TALs-Education/ZumoPi/README.md

# ZumoPi
ZumoPi is a compact robot platform built around the Pololu Zumo chassis and controlled by a Raspberry Pi. This project is used in various educational settings to demonstrate real-world applications of embedded systems, sensor integration, and autonomous control. The slides below cover topics such as configuring embedded hardware, implementing control loops, and developing path-following algorithms. The goal is to give students hands-on experience with building, programming, and testing autonomous robots.

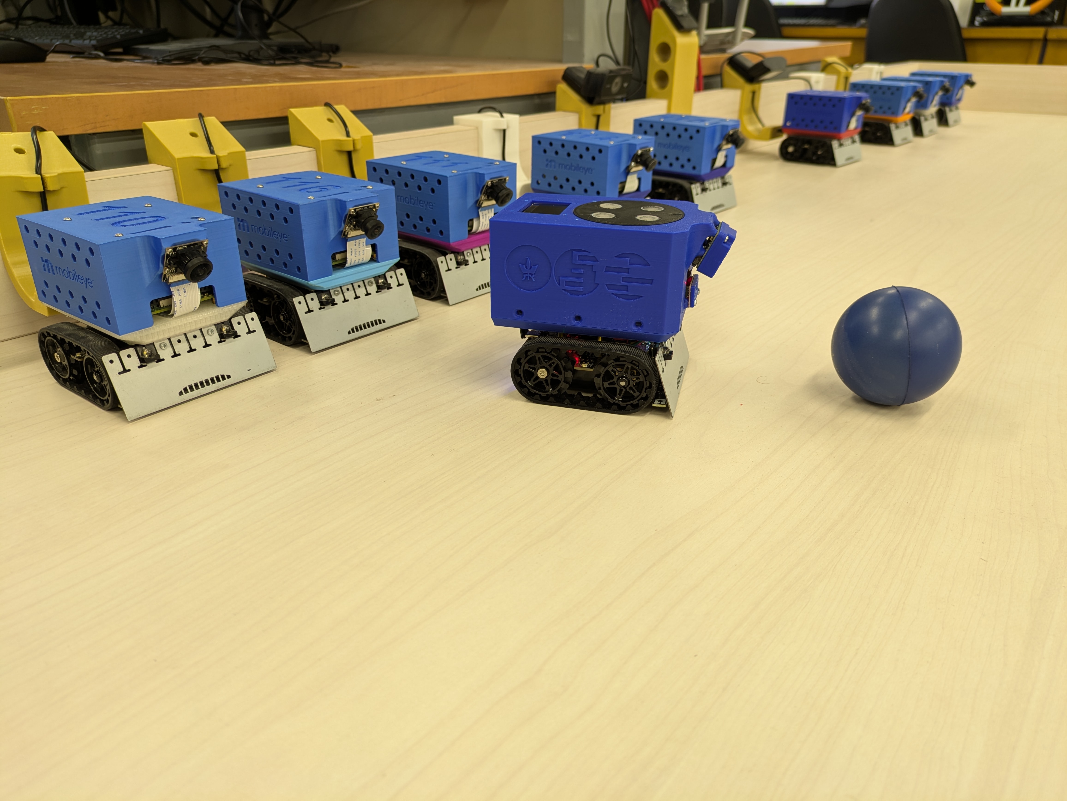
[picture p1: Media/ZumoPi_V02/ZumoV02.jpg]
Platform Image


---

Block Diagram

---

## Bill of Materials (BOM)

[BOM ZumoPi V02](https://docs.google.com/spreadsheets/d/e/2PACX-1vQxc54kx69_jDI3SzTPj1htnaY2AYKc5NwDaSZi82ZxfzQ_idLNpaMOl1VLD6l9M_Mb7hPjLyrn291Y/pubhtml)

---

## Course Slides

- **[Autonomous Systems Lab](https://docs.google.com/presentation/d/e/2PACX-1vRStIoiYa2XbYNI_D9ZccQSjIIEqi7QFh0CPTO20TWpKoEXQ6jn_6Y2cxPnYvpHpmra1TaAvrsPDCbp/pub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)**
  *Introduction to building and controlling autonomous robots, covering fundamental concepts such as sensor fusion, actuator control, and system integration.*

- **[Embedded](https://docs.google.com/presentation/d/e/2PACX-1vTtC3hYFiazQUpXpRI4Cu9u7xv1cP7oLfKXLLpGbvr99-eDz1KW8hfmtAW4wn4Qjw7GQxjzbYANB0p1/pub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)**  
  *Focus on embedded systems programming, including microcontroller or single-board computer setups, interfacing with hardware, and real-time control considerations.*

- **[PathControl](https://docs.google.com/document/d/e/2PACX-1vTpQWTco3Bi_aDHO9klbxftK4g1yNk0Z4INCxaVdjpg8Rd_K-o5vXg43kFpY49FMV86XIksFvMH8WC9/pub)**  
  *Detailed instructions and theory on path planning and control algorithms, demonstrating how to implement robust path-following routines on the ZumoPi robot.*

- **[PathControl - Python Simulation (PDF)](ZumoPi_V02/EducationalMaterials/ZumoPiV02%20-%20Autonomous%20Systems%20Lab%20-%20Path%20Control%20%28Python%29.pdf)**  
  *Python edition of the Path Control lab: the pre-lab runs in the [Python path control simulator](ZumoPi_V02/Python_Simulation) (GUI with live gain tuning, 2D path and block diagram view) instead of MATLAB/Simulink. Setup instructions are in its [README](ZumoPi_V02/Python_Simulation/README.md).*

- **[ImageProcessing](https://docs.google.com/document/d/e/2PACX-1vQhq_S6ipLvnca8L5krcB6jEdvge32izgGZujL72_1fmICjwPvxk8P4Rqf4jPIfgcK0uPkOjYD1Od2g/pub)**  
  *The Image Processing Lab provides comprehensive guidance and theoretical foundations for practical image processing techniques, demonstrating how to implement vision-based applications on the ZumoPi robot.*

- **[HomeExperiments](https://github.com/TALs-Education/HomeExperiments)**  
  *The HomeExperiments repository offers students home experiment kits focusing on motor control, Arduino integration, and sensor applications, facilitating hands-on learning of embedded systems concepts.*

---

## Demonstrations

- **[LineFollower 2024](https://youtu.be/RPoe6qCaDEk)**
- **[PathControl 2024](https://youtu.be/oDfgZZBIBZM)**
- **[SumoCompetition 2023](https://youtu.be/UK6Vnh2M9fI)**
- **[Video Teleoperation](https://youtu.be/0YhwoFXWOhQ)**
