TALs-Education/ZumoPi/ZumoPi_V02/SettingUp.txt

UPS - Geekworm X1200 - https://geekworm.com/products/x1200
https://suptronics.com/Raspberrypi/Power_mgmt/x120x-v1.0_software.html

arduino ide ARM 64 version 1.89
https://www.arduino.cc/en/software

Zumo-arduino Arduino Mbed OS RP2040 Boards 
https://github.com/adamgreen/pololu-3pi-plus-2040-arduino-library

Arduino library - Pololu3piPlus2040 compatible with Zumo2040
https://github.com/adamgreen/pololu-3pi-plus-2040-arduino-library

MicroPython Zumo2040 - https://github.com/pololu/zumo-2040-robot

install arduino-cli  	https://siytek.com/arduino-cli-raspberry-pi/

Install picamera2 https://forums.raspberrypi.com/viewtopic.php?t=361758 usually not needed installed by default
https://datasheets.raspberrypi.com/camera/picamera2-manual.pdf
$sudo apt install python3-picamera2

Install openCV
sudo apt install -y python3-opencv
sudo apt install -y opencv-data

work with virtualenv: https://learn.adafruit.com/python-virtual-environment-usage-on-raspberry-pi/overview
$sudo apt install python3-venv

create a virtual environment which uses the system python packages for picamera2
$python3 -m venv --system-site-packages zumoPy

activate enviroment
$source zumoPy/bin/activate

deactivate enviroment:
$deactivate

Backup enviroment:
$pip freeze > requirements.txt

Update enviroment:
$pip install -r requirements.txt

upgrade python-pip
$python3 -m pip install --upgrade pip

cancel auto shutdown:
$sudo shutdown -c

python packages:
$pip install dash
$pip install evdev
$pip install pyserial
$pip install dash-daq
$pip install matplotlib

Optional packages:
pip3 install tflite-runtime

Testcamera:
libcamera-hello
