TALs-Education/ZumoPi/ZumoPi_V02/Development/BallDetection/BallDetection(Sphere).pdf

## Detecting a Ball (Sphere) Using Camera Geometry

Using Known Camera Height, Tilt, FOV, and Ball Diameter

## Introduction

This document outlines a method for detecting a spherical ball in an image captured by a tilted camera at a known height. We assume:

- The ball has a known real-world diameter Dball (e.g., 70 mm).
- The camera is at height H above the ground (e.g., 85 mm), tilted downward by an angle θ.
- The camera has a horizontal and vertical field of view (FOV) of ϕh and ϕv, respectively (in degrees).
- The image resolution is W ×Himg, and the camera is modeled as a pinhole with effective focal lengths fx, fy.

Below, we derive the approximate distance from the camera to the ball using circle detection (cv2.HoughCircles) and account for partial ground occlusion where the ball contacts the floor. The associated Python code demonstrates how these formulas are implemented in real time.

## 1. Circle Detection

We first detect the ball’s 2D projection in the image using methods such as:

cv2.HoughCircles(...) | → | ( uball, vball, rpix),

where (uball, vball) is the circle’s center in pixel coordinates, and rpix is the detected circle’s pixel radius.

## 2. Initial Distance Estimate

Under a simpler pinhole model (no occlusion correction), if an object of physical diameter Dobj appears with diameter dpix in pixels, we can approximate the distance:

Dest =

favg × Dobj

dpix

,

where

- dpix = 2 rpix,
- favg is an average focal length in pixels, often computed as

fx =

W/2
tan

ϕh
2

, fy =

Himg/2
tan

ϕv
2

, favg =

fx + fy
2

For a sphere of diameter Dball, dpix is the measured diameter in the image.

## 3. Ground Occlusion Correction

If the ball rests on the ground, part of it is hidden by the contact point with the floor, making the measured circle smaller than the true circle. The Python code uses a function

project y(Yworld, Zworld, fy, cy)

to compute the vertical image coordinate of a 3D point (0, Yworld, Zworld) in a camera coordinate system tilted by θ.

### 3.1 Spherical Radius vs. Contact Point

Let Rball =

Dball
2

be the ball’s real radius.

- The center of the ball is at Yworld = Rball above the ground.
- The contact with the ground occurs at Yworld = 0.

We initially estimate Zworld = Dest and compute where the camera sees Yworld = Rball and Yworld = 0 in the image:

vcenter est = project y

Rball, Dest, fy, cy
,

vcontact est = project y

0, Dest, fy, cy

The difference

∆ = vcontact est − vcenter est

represents the vertical offset (in pixels) between the ball’s center and the ground contact point.

### 3.2 Corrected Apparent Diameter

In a perfect side view, if no occlusion occurred, the ball’s full radius in the image could be approximated by

rfull =

rdpix

2

2
+ ∆².

Thus, the full (unoccluded) diameter is dfull = 2 rfull. The code then refines the distance:

Dcorr = 2 ×

favg × Dball

dfull

,

introducing a factor of 2 to compensate for the partial occlusion. This new Dcorr is used for a more accurate distance estimate.

## 4. Final 3D Position

Once Dcorr is computed, we treat the ball’s center as lying at

Zworld = Dcorr cos(αeff), Xworld = Dcorr sin(αeff),

where

- α = arctan

uball−cx
fx
is the horizontal angle,

- β = arctan vcenter corr−cy
fy
is the additional pitch from the camera center to the ball center,
- αeff = θ + β is the total pitch angle from the horizontal reference.

Hence, in a 2D plane where the camera is the origin, Xworld is the lateral offset and Zworld is the forward distance (in mm). The ball’s vertical position relative to the ground can also be approximated by
VerticalEst = Dcorr × sin(αeff).

## 5. Summary of Key Steps in the Code

1. Capture frame, detect circle (uball, vball, rpix) via cv2.HoughCircles.
2. Initial distance:

Dest =

favg × Dball

(2 rpix)

3. Project ball center and contact to the image using project y.
4. Compute occlusion offset ∆ and refine diameter dfull.
5. Refine distance Dcorr and re-evaluate the ball center’s pitch angle β.
6. Compute 2D ground coordinates (Xworld, Zworld) and optional vertical position.

## 6. Caveats and Practical Considerations

- Lens Distortion: Wide-angle lenses may cause significant distortion that requires calibration for more accurate geometry.
- Noise and Circle Detection: cv2.HoughCircles parameters (dp, param1, param2, minRadius, etc.) must be tuned for the environment.
- Partial Occlusion Approximations: The approach here models the ball-floor contact as
a simple 2D projection. Very large tilt angles or non-flat surfaces can introduce errors.
- Real-Time Constraints: Computing these corrections each frame is still efficient enough for many robotics tasks, but frame rates vary based on resolution and Pi performance.

## Conclusion

By treating a detected circle in the image as part of a sphere resting on a flat plane, we can achieve more accurate distance estimates than naive pinhole formulas would give. The core ideas:

1. Use the known ball diameter and measured circle size to estimate distance.
2. Account for camera tilt and partial occlusion with a simple trigonometric correction.

3. Derive final (X, Z) coordinates in millimeters from the camera origin.

This pipeline can guide a mobile robot to locate, track, or interact with spherical objects using only a single downward-tilted camera.
