TALs-Education/ZumoPi/ZumoPi_V02/old_Designs/Research/Power_Management/bq24075/Links.txt

SparkFun Battery Babysitter - LiPo Battery Manager
https://www.sparkfun.com/products/13777
