TALs-Education/ZumoPi/ZumoPi_V02/old_Designs/Components/LTC4040/Links.txt

https://www.beyondlogic.org/ltc4040-5v-2-5a-uninterruptible-power-supply-ups-with-usb-c/
https://circuitmaker.com/Projects/Details/Craig-Peacock-4/5V-Uninterruptable-Power-Supply-USB

https://hackaday.io/project/162653-u1liupsrpi
