TALs-Education/ZumoPi/ZumoPi_V02/old_Designs/MCU/Pinout.xlsx

Sheet: Sheet1
 | My Functionality | AUDIO | UART | GPIO/BUS | I2C | SDIO | SPI | Dedicated |  | Header | My Functionality |  |  | AUDIO | UART | GPIO/BUS | I2C | SDIO | SPI | Dedicated |  | AUDIO | UART | GPIO/BUS | I2C | SDIO | SPI | Dedicated |  |  | AUDIO | UART | GPIO/BUS | I2C | SDIO | SPI0 | Dedicated |  |  |  | AUDIO | UART | GPIO/BUS | I2C | SDIO | SPI | Dedicated | AUDIO | UART | GPIO/BUS | I2C | SDIO | SPI0 | Dedicated
 |  | Function |  |  |  | Bottom | Top | Function |  |  |  |  |  | SAMD51 | Alternate | Primary | Bottom | Top | Primary | Alternate | SAMD51 | Alternate |  | Primary | RP2040 GPIO Pin | Bottom | Top | RP2040 GPIO Pin | Primary | Alternate | ESP32 Pin | Alternate Function |  | Primary Function | Bottom Pin | Top Pin | Primary Function | Alternate Function |  | ESP32 Pin | Function STM32 | Bottom | Top | Function |  |  |  | Function nRF52840 |  |  | Bottom | Top | Function nRF52840
 |  |  |  |  |  | Pin | Pin |  |  |  |  |  |  | Pin | Function | Function | Pin | Pin | Function | Function | Pin | Function |  | Function |  | Pin | Pin |  | Function | Function |  |  |  |  |  |  |  |  |  |  |  | Pin | Pin |  |  |  |  |  |  |  | Pin | Pin
 |  |  |  |  | (Not Connected) |  | 75 | GND |  |  |  |  |  |  |  | (Not Connected) |  | 75 | GND |  |  |  |  | (Not Connected)* |  |  | 75 |  | GND |  |  |  |  |  |  | 75 |  |  |  |  | (Not Connected) |  | 75 | GND |  |  |  |  |  |  | (Not Connected) | 75 | GND
 | 3.3V |  |  |  | 3.3V | 74 | 73 | G5 / BUS5 |  |  | !BST | Line MCU |  | D14 |  | 3.3V_IN | 74 | 73 | G5 |  | D7 |  |  | 3.3V |  | 74 | 73 | GPIO21 | G5 |  |  |  |  |  |  | 73 | G5 | RTC |  | 32 | 3.3V | 74 | 73 | G5 / BUS5 |  |  |  |  |  | 3.3V | 74 | 73 | G5
 | RTC_3V_BATT |  |  |  | RTC_3V_BATT | 72 | 71 | G6 / BUS6 |  |  | Vin Stat |  |  |  |  | 3.3V | 72 | 71 | G6 |  | D8 |  |  | 3.3V |  | 72 | 71 | GPIO22 | G6 |  |  |  |  |  |  | 71 | G6 | RTC |  | 33 |  | 72 | 71 | G6 / BUS6 |  |  |  |  |  | RTC_3V_BATT | 72 | 71 | G6
 | Header jp_en |  |  | SPI_CS1# | SDIO_DATA3 (I/O) | 70 | 69 | G7 / BUS7 |  |  | !Alert Battery |  |  |  |  | - | 70 | 69 | G7 |  | D9 |  | SPI_CS1 | SDIO_DATA3 | GPIO9 | 70 | 69 | GPIO23 | G7 |  |  |  |  |  |  | 61 | SPI_CIPO |  |  | 19 |  | 70 | 69 |  |  |  |  |  | SDIO_DATA3 | SPI_CS1 | 70 | 69 | G7
 | Header jp_en |  |  |  | SDIO_DATA2 (I/O) | 68 | 67 | G8 |  |  | Header | Pi_!INT! | JP |  |  | - | 68 | 67 | G8 |  | D10 |  | AUD_OUT | SDIO_DATA2 | GPIO10 | 68 | 67 |  | - |  |  |  |  |  |  | 59 | SPI_COPI |  |  | 23 |  | 68 | 67 |  |  |  |  |  |  | SDIO_DATA2 | 68 | 67 | G8
 | Header jp_en |  |  |  | SDIO_DATA1 (I/O) | 66 | 65 | G9 | ADC_D- | CAM_HSYNC | Header | Pi_!INT! | JP |  |  | - | 66 | 65 | G9 |  | D11 |  | AUD_IN | SDIO_DATA1 | GPIO11 | 66 | 65 | GPIO28 | G9 |  |  |  |  |  |  | 57 | SPI_SCK |  |  | 18 |  | 66 | 65 |  |  |  |  |  |  | SDIO_DATA1 | 66 | 65 | G9 | NFC1
 | Header jp_en |  |  | SPI_CIPO1 | SDIO_DATA0 (I/O) | 64 | 63 | G10 | ADC_D+ | CAM_VSYNC | Header | Pi_!INT! 2 | JP |  |  | - | 64 | 63 | - |  |  |  | SDIO_DATA0 | SPI_CIPO1 | GPIO12 | 64 | 63 | GPIO25 | G10 |  | 17 | AUD_OUT | TX1 | G3 | 56 | 55 | SPI_CS# |  |  | 5 |  | 64 | 63 | G10/HOST_VBUS |  |  |  |  | SDIO_DATA0 | SPI_CIPO1 | 64 | 63 | G10 | NFC2
 | Header jp_en |  |  | SPI COPI1 | SDIO_CMD (I/O) | 62 | 61 | SPI_CIPO (I) |  |  | Line MCU |  |  |  |  | - | 62 | 61 | SPI_CIPO |  | 47 |  | SDIO_CMD | SPI_COPI1 | GPIO15 | 62 | 61 | GPIO20 | SPI_CIPO | G4 | 16 | AUD_IN | RX1 | G4 | 54 | 53 | SCL1 | G1 | AUD_LRCLK | 25 |  | 62 | 61 | SPI_CIPO (I) |  |  |  |  | SDIO_CMD | SPI_COPI1 | 62 | 61 | SPI_CIPO
 | Header jp_en |  |  | SPI SCK1 | SDIO_SCK (O) | 60 | 59 | SPI_COPI (O) | LED_DAT |  | Line MCU |  |  |  |  | - | 60 | 59 | SPI_COPI |  | 45 |  | SDIO_SCK | SPI_SCK1 | GPIO14 | 60 | 59 | GPIO23 | SPI_COPI | G7 | 25 | AUD_LRCLK | SCL1 | G1 | 52 | 51 | SDA1 | G2 | AUD_BCLK | 26 |  | 60 | 59 | SPI_COPI (O) |  |  |  |  | SDIO_SCK | SPI_SCK1 | 60 | 59 | SPI_COPI
jp | VL0_CE |  |  |  | AUD_MCLK (O) | 58 | 57 | SPI_SCK (O) | LED_CLK |  | Line MCU |  |  | 43 |  | I2S_MCLK | 58 | 57 | SPI_SCK |  | 46 |  | AUD_MCLK | PWM1 | GPIO24 | 58 | 57 | GPIO22 | SPI_SCK | G6 | 26 | AUD_BCLK | SDA1 | G2 | 50 | 49 | BATT_VIN / 3 |  |  | 39 |  | 58 | 57 | SPI_SCK (O) |  |  |  |  |  | Not Connected | 58 | 57 | SPI_SCK
jp | VL1_CE | CAM_MCLK | PCM_OUT | I2S_OUT | AUD_OUT | 56 | 55 | SPI_CS# |  |  | Line MCU |  |  | 40 |  | I2S_SDO | 56 | 55 | SPI_CS |  | 48 |  | AUD_OUT | SDIO_DAT2 | GPIO10 | 56 | 55 | GPIO21 | SPI_CS | G5 | 16 | AUD_IN | RX1 | G4 | 48 | 47 | PWM1 |  |  | 12 | AUD_OUT | 56 | 55 | SPI_CS# |  |  |  |  |  | Not Connected | 56 | 55 | SPI_CS
jp | BNO_!INT! | CAM_PCLK | PCM_IN | I2S_IN | AUD_IN | 54 | 53 | I2C_SCL1 (I/O) |  |  | Header jp_en | I2c Pi |  | 41 |  | I2S_SDI | 54 | 53 | I2C_SCL1 | TX2 | 36 |  | AUD_IN | SDIO_DAT1 | GPIO11 | 54 | 53 |  | - |  | 17 | AUD_OUT | TX1 | G3 | 46 |  |  |  |  |  | AUD_IN | 54 | 53 | I2C_SCL1 (I/O) |  |  |  |  |  | Not Connected | 54 | 53 | I2C_SCL1
jp | BNO_!RST! | PDM_DATA | PCM_SYNC | I2S_WS | AUD_LRCLK | 52 | 51 | I2C_SDA1 (I/O) |  |  | Header jp_en | I2c Pi |  | 44 |  | I2S_FS | 52 | 51 | I2C_SDA1 | RX2 | 37 |  | AUD_LRCLK | CTS1 | GPIO2 | 52 | 51 |  | - |  | 26 | AUD_BCLK | SDA1 | G2 | 44 |  |  |  |  |  | AUD_LRCLK | 52 | 51 | I2C_SDA1 (I/O) |  |  |  |  |  | PDM_DATA | 52 | 51 | I2C_SDA1
jp | BNO_!BOOT! | PDM_CLK | PCM_CLK | I2S_SCK | AUD_BCLK | 50 | 49 | BATT_VIN / 3 (I - ADC) (0 to 3.3V) |  |  | BATT_VIN / 3 (I - ADC) (0 to 3.3V) |  |  | 42 |  | I2S_CLK | 50 | 49 | A4 |  | 21 |  | AUD_BCLK | UART_RTS1 | GPIO3 | 50 | 49 |  | BATT_VIN |  | 25 | AUD_LRCLK | SCL1 | G1 | 42 |  |  |  |  |  | AUD_BCLK | 50 | 49 | BATT_VIN / 3 (I - ADC) (0 to 3.3V) |  |  |  |  |  | PDM_CLK | 50 | 49 | BATT_VIN / 3 (0 to 3.3V)
 | ENC2_1 |  |  |  | G4 / BUS4 | 48 | 47 | PWM1 |  |  | M1 PWM |  |  | D6 |  | G4 | 48 | 47 | PWM1 | A3 | 20 |  | G4 | SPI_CIPO | GPIO20 | 48 | 47 | GPIO24 | PWM1 | AUD_MCLK | 15 |  |  | G0 | 40 | 39 | GND |  |  |  | G4 / BUS4 | 48 | 47 | PWM1 |  |  |  |  |  | G4 | 48 | 47 | PWM1
 | ENC2_0 |  |  |  | G3 / BUS3 | 46 | 45 | GND |  |  |  |  |  | D5 |  | G3 | 46 | 45 | GND |  |  |  |  | G3 | GPIO19 | 46 | 45 |  | GND |  | 35 |  |  | A1 | 38 |  |  |  |  |  | G3 / BUS3 | 46 | 45 | GND |  |  |  |  |  | G3 | 46 | 45 | GND
 | ENC1_1 |  |  |  | G2 / BUS2 | 44 | 43 | CAN_TX |  |  | Header |  |  | D4 |  | G2 | 44 | 43 | G10 |  | 38 |  |  | G2 | GPIO18 | 44 | 43 |  | - |  | 34 |  |  | A0 | 34 |  |  |  |  |  | G2 / BUS2 | 44 | 43 | CAN_TX |  |  |  |  |  | G2 | 44 | 43 | Not Connected
 | ENC1_0 |  |  |  | G1 / BUS1 | 42 | 41 | CAN_RX |  |  | Header |  |  | D3 |  | G1 | 42 | 41 | G11 |  | 39 |  |  | G1 | GPIO17 | 42 | 41 |  | - |  | 13 |  |  | PWM0 | 32 | 33 | GND |  |  |  | G1 / BUS1 | 42 | 41 | CAN_RX |  |  |  |  |  | G1 | 42 | 41 | Not Connected
 | P_EN |  |  |  | G0 / BUS0 | 40 | 39 | GND |  |  |  |  |  | D2 |  | G0 | 40 | 39 | GND |  |  |  |  | G0 | GPIO16 | 40 | 39 |  | GND |  |  |  |  |  |  | 19 | G4 | RX1 | AUD_IN | 16 | G0 / BUS0 | 40 | 39 | GND |  |  |  |  |  | G0 | 40 | 39 | GND
 | CLPROG |  |  |  | A1 | 38 | 37 | USBHOST_D- |  |  |  |  |  | 18 |  | A1 | 38 | 37 | - |  |  |  |  | A1 | GPIO27 | 38 | 37 |  | USBHOST_D- |  | 27 |  | CAM_TRIG | D1 | 18 | 17 | G3 | TX1 | AUD_OUT | 17 | A1 | 38 | 37 | USBHOST_D- |  |  |  |  |  | A1 | 38 | 37 | Not Connected
 |  |  |  |  | GND | 36 | 35 | USBHOST_D+ |  |  |  |  |  |  |  | GND | 36 | 35 | - |  |  |  |  | GND |  | 36 | 35 |  | USBHOST_D+ |  | 4 |  |  | I2C Interrupt | 16 |  |  |  |  |  | GND | 36 | 35 | USBHOST_D+ |  |  |  |  |  | GND | 36 | 35 | Not Connected
 | Header |  |  |  | A0 | 34 | 33 | GND |  |  |  |  |  | 17 | DAC | A0 | 34 | 33 | GND |  |  |  |  | A0 | GPIO26 | 34 | 33 |  | GND |  | 22 |  |  | SCL | 14 |  |  |  |  |  | A0 | 34 | 33 | GND |  |  |  |  |  | A0 | 34 | 33 | GND
 | M0 PWM |  |  |  | PWM0 | 32 | 31 | Module Key |  |  |  |  |  | 19 | A2 | PWM0 | 32 | 31 | Module Key |  |  |  |  | PWM0 | GPIO13 | 32 | 31 |  | Module Key |  | 21 |  |  | SDA | 12 | 11 | BOOT |  |  |  | PWM0 | 32 | 31 | Module Key |  |  |  |  |  | PWM0 | 32 | 31 | Module Key
 |  |  |  |  | Module Key | 30 | 29 | Module Key |  |  |  |  |  |  |  | Module Key | 30 | 29 | Module Key |  |  |  |  | Module Key |  | 30 | 29 |  | Module Key |  | 14 |  |  | D0 | 10 | 9 | USB_VIN |  |  |  | Module Key | 30 | 29 | Module Key |  |  |  |  |  | Module Key | 30 | 29 | Module Key
 |  |  |  |  | Module Key | 28 | 27 | Module Key |  |  |  |  |  |  |  | Module Key | 28 | 27 | Module Key |  |  |  |  | Module Key |  | 28 | 27 |  | Module Key |  |  |  |  |  |  | 7 | GND |  |  |  | Module Key | 28 | 27 | Module Key |  |  |  |  |  | Module Key | 28 | 27 | Module Key
 |  |  |  |  | Module Key | 26 | 25 | Module Key |  |  |  |  |  |  |  | Module Key | 26 | 25 | Module Key |  |  |  |  | Module Key |  | 26 | 25 |  | Module Key |  |  |  |  | RESET | 6 | 5 | USB_D- |  |  |  | Module Key | 26 | 25 | Module Key |  |  |  |  |  | Module Key | 26 | 25 | Module Key
 |  |  |  |  | Module Key | 24 | 23 | SWDIO |  |  | SWDIO |  |  |  |  | Module Key | 24 | 23 | SWDIO |  |  |  |  | Module Key |  | 24 | 23 |  | SWDIO |  |  |  |  |  |  | 3 | USB_D+ |  |  |  | Module Key | 24 | 23 | SWDIO |  |  |  |  |  | Module Key | 24 | 23 | SWDIO
 | BNO_TX |  |  |  | UART_TX2 (O) | 22 | 21 | SWDCK |  |  | SWDCK |  |  | 36 | I2C_SCL1 | UART_TX2 | 22 | 21 | SWDCK |  |  |  | I2C_INT | UART_TX2 | GPIO8 | 22 | 21 |  | SWDCK |  |  |  |  | 3.3V | 2 | 1 | GND |  |  |  |  | 22 | 21 | SWDCK |  |  |  |  |  | UART_TX2 | 22 | 21 | SWDCK
 | BNO_RX |  |  |  | UART_RX2 (I) | 20 | 19 | UART_RX1 (I) |  |  | Header | Uart Pi |  | 37 | I2C_SDA1 | UART_RX2 | 20 | 19 | UART_RX1 |  | 33 | SPI_CS1 | SDIO_DAT3 | UART_RX2 | GPIO9 | 20 | 19 | GPIO1 | UART_RX1 |  |  |  |  |  |  |  |  |  |  |  |  | 20 | 19 | UART_RX1 (I) |  |  |  |  |  | UART_RX2 | 20 | 19 | UART_RX1
 | M1 Phase |  |  | CAM_TRIG | D1 | 18 | 17 | UART_TX1 (0) |  |  | Header | Uart Pi |  | D1 |  | D1 | 18 | 17 | UART_TX1 |  | 32 |  |  | D1 | GPIO7 | 18 | 17 | GPIO0 | UART_TX1 |  |  |  |  |  |  |  |  |  |  |  | D1 | 18 | 17 | UART_TX1 (0) |  |  |  |  |  | D1 | 18 | 17 | UART_TX1
 | Line MCU Interrupt |  |  |  | I2C_INT# | 16 | 15 | UART_CTS1 (I) |  |  |  |  |  | D12 |  | I2C_INT | 16 | 15 | - |  |  |  | TX2 | I2C_INT | GPIO8 | 16 | 15 | GPIO2 | UART_CTS1 | AUD_LRCLK |  |  |  |  |  |  |  |  |  |  | I2C_INT# | 16 | 15 |  |  |  |  |  |  | I2C_INT | 16 | 15 | UART_CTS1
Line MCU | I2C_SCL (I/0) |  |  |  | I2C_SCL (I/0) | 14 | 13 | UART_RTS1 (O) |  |  |  |  |  | 34 |  | I2C_SCL | 14 | 13 | - |  |  |  |  | I2C_SCL | GPIO5 | 14 | 13 | GPIO3 | UART_RTS1 | AUD_BCLK |  |  |  |  |  |  |  |  |  |  | I2C_SCL (I/0) | 14 | 13 |  |  |  |  |  |  | I2C_SCL | 14 | 13 | UART_RTS1
Line MCU | I2C_SDA (I/0) |  |  |  | I2C_SDA (I/0) | 12 | 11 | BOOT (I - Open Drain) |  |  | BOOT (I - Open Drain) | Header |  | 35 |  | I2C_SDA | 12 | 11 | - |  |  |  |  | I2C_SDA | GPIO4 | 12 | 11 |  | BOOT |  |  |  |  |  |  |  |  |  |  |  | I2C_SDA (I/0) | 12 | 11 | BOOT# (I - Open Drain) |  |  |  |  |  | I2C_SDA | 12 | 11 | BOOT (Open Drain)
 | M0 Phase |  |  |  | D0 | 10 | 9 | USB_VIN |  |  | USB_VIN |  |  | D0 |  | D0 | 10 | 9 | - |  |  |  |  | D0 | GPIO6 | 10 | 9 |  | USB_VIN |  |  |  |  |  |  |  |  |  |  |  | D0 | 10 | 9 |  |  |  |  |  |  | D0 | 10 | 9 | USB_VIN
 | SWO |  |  | SWO | G11 | 8 | 7 | GND |  |  |  |  |  | 29 |  | HOST_ENABLE | 8 | 7 | GND |  |  |  |  | - |  | 8 | 7 |  | GND |  |  |  |  |  |  |  |  |  |  |  | G11/HOST_ID | 8 | 7 | GND |  |  |  |  |  |  | 8 | 7 | GND
Header | RESET# (I - Open Drain) |  |  |  | RESET# (I - Open Drain) | 6 | 5 | USB_D- |  |  | USB_D- | Header after mux |  |  |  | RESET# (Open Drain) | 6 | 5 | USB_D- | USBHOST_D- | 30 |  |  | RESET |  | 6 | 5 |  | USB_D- |  |  |  |  |  |  |  |  |  |  |  | RESET# (I - Open Drain) | 6 | 5 | USB_D- |  |  |  |  |  | RESET# (Open Drain) | 6 | 5 | USB_D-
 | 3.3V_EN |  |  |  | 3.3V_EN | 4 | 3 | USB_D+ |  |  | USB_D+ | Header after mux |  |  |  | 3.3V_EN | 4 | 3 | USB_D+ | USB_HOST_D+ | 31 |  |  | - |  | 4 | 3 |  | USB_D+ |  |  |  |  |  |  |  |  |  |  |  |  | 4 | 3 | USB_D+ |  |  |  |  |  | 3.3V_EN | 4 | 3 | USB_D+
 | 3.3V |  |  |  | 3.3V | 2 | 1 | GND |  |  |  |  |  |  |  | 3.3V_IN | 2 | 1 | GND |  |  |  |  | 3.3V_IN |  | 2 | 1 |  | GND |  |  |  |  |  |  |  |  |  |  |  | 3.3V | 2 | 1 | GND |  |  |  |  |  | 3.3V | 2 | 1 | GND

Sheet: ESP32_Option
https://learn.sparkfun.com/tutorials/micromod-esp32-processor-board-hookup-guide/all
My Functionality | ESP32 Pin | Alternate Function | Primary Function | Bottom Pin | Top Pin | Primary Function | Alternate Function | ESP32 Pin | My Functionality | AUDIO | UART | GPIO/BUS | I2C | SDIO | SPI0 | Dedicated | Header Pi
 |  |  |  |  | 73 | G5 | RTC | 32
 |  |  |  |  | 71 | G6 | RTC | 33
 |  |  |  |  | 61 | SPI_CIPO |  | 19 | SPI_CIPO
 |  |  |  |  | 59 | SPI_COPI |  | 23 | SPI_COPI
 |  |  |  |  | 57 | SPI_SCK |  | 18 | SPI_SCK
 |  |  |  | 56 | 55 | SPI_CS# |  | 5 | SPI_CS#
 |  |  |  | 50 | 49 | BATT_VIN / 3 |  | 39 | BATT_VIN / 3
ENC2_1 | 16 |  | G4 | 48 | 47 | PWM1 |  | 12 | PWM1
ENC2_0 | 17 |  | G3 | 46
ENC1_1 | 26 |  | G2 | 44
ENC1_0 | 25 |  | G1 | 42
P_EN | 15 |  | G0 | 40 | 39 | GND
CLPROG | 35 |  | A1 | 38
 | 34 |  | A0 | 34
M0 PWM | 13 |  | PWM0 | 32 | 33 | GND
M1 Phase | 27 | CAM_TRIG | D1 | 18 | 17
I2C Interrupt | 4 |  | I2C Interrupt | 16
SCL | 22 |  | SCL | 14
SDA | 21 |  | SDA | 12 | 11 | BOOT |  |  | BOOT
M0 Phase | 14 |  | D0 | 10 | 9 | USB_VIN |  |  | USB_VIN
 |  |  |  |  | 7 | GND
RESET# (I - Open Drain) |  |  | RESET | 6 | 5 | USB_D- |  |  | USB_D- MUX
 |  |  |  |  | 3 | USB_D+ |  |  | USB_D+ MUX
3.3V |  |  | 3.3V | 2 | 1 | GND
Dedicated Pins
A0 - GPIO pin 34, pad 34 on the MicroMod (Input Only!)
A1 - GPIO pin 35, pad 38 on the MicroMod (Input Only!)
D0 - GPIO pin 14, pad 10 on the MicroMod
D1 - GPIO pin 27, pad 18 on the MicroMod
PWM0 - GPIO pin 13, pad 32 on the MicroMod
PWM1 - GPIO pin 12, pad 47 on the MicroMod
General Purpose IO pins
G0 - GPIO pin 15, pad 40 on the MicroMod
G1 - GPIO pin 25, pad 42 on the MicroMod - Shared with the I2S bus, and secondary I2C bus.
G2 - GPIO pin 26, pad 44 on the MicroMod - Shared with the I2S bus, and secondary I2C bus.
G3 - GPIO pin 17, pad 46 on the MicroMod - Shared with the I2S bus, and secondary UART.
G4 - GPIO pin 16, pad 48 on the MicroMod - Shared with the I2S bus, and secondary UART.
G5 - GPIO pin 32, pad 73 on the MicroMod - Shared with the 32KHz RTC crystal.
G6 - GPIO pin 33, pad 71 on the MicroMod - Shared with the 32KHz RTC crystal.
