TALs-Education/ZumoPi/Media/ZumoPi_V02/ImageDetection.png

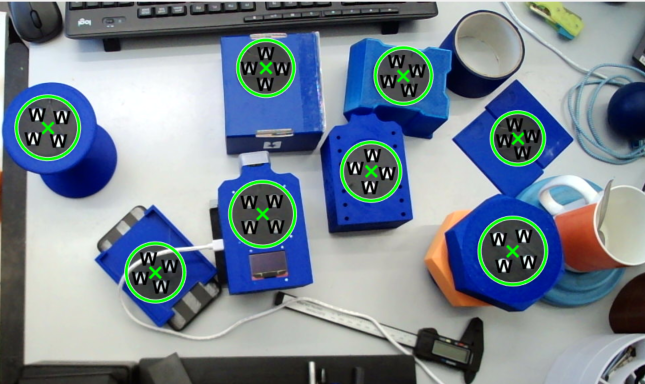
Media/ZumoPi_V02/ImageDetection.png
