TALs-Education/ZumoPi/Media/ZumoPi_V02/ImageDetectionMultiBarcode.jpg

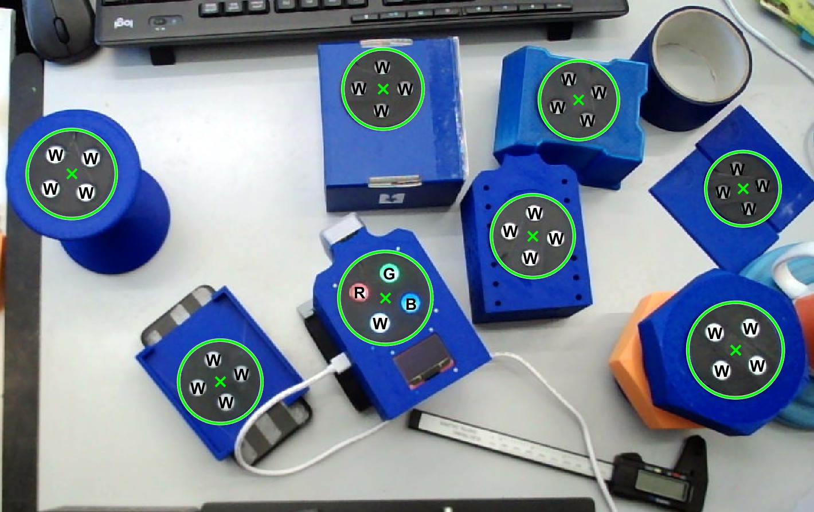
Media/ZumoPi_V02/ImageDetectionMultiBarcode.jpg
