TALs-Education/ZumoPi/Media/ZumoPi_V02/PXL_20250226_071156245.jpg

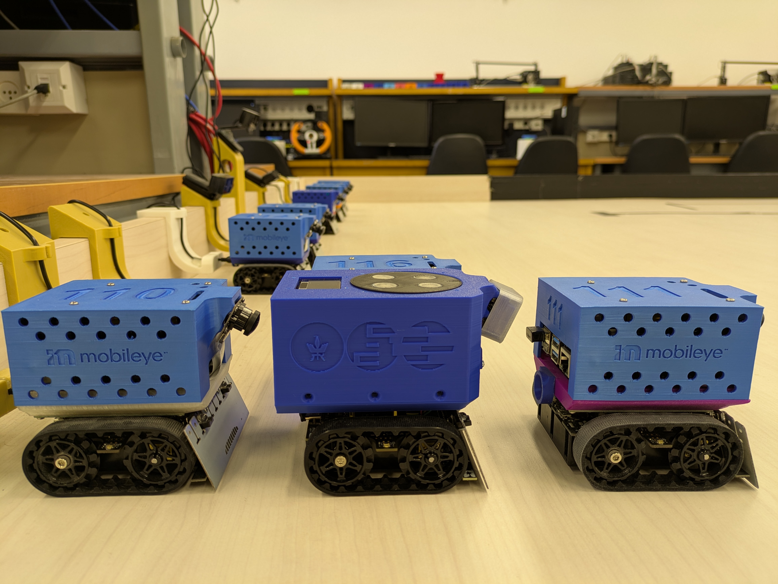
Media/ZumoPi_V02/PXL_20250226_071156245.jpg
