TALs-Education/ZumoPi/Media/ZumoPi_V02_Assembly/PiUartPinout.jpeg

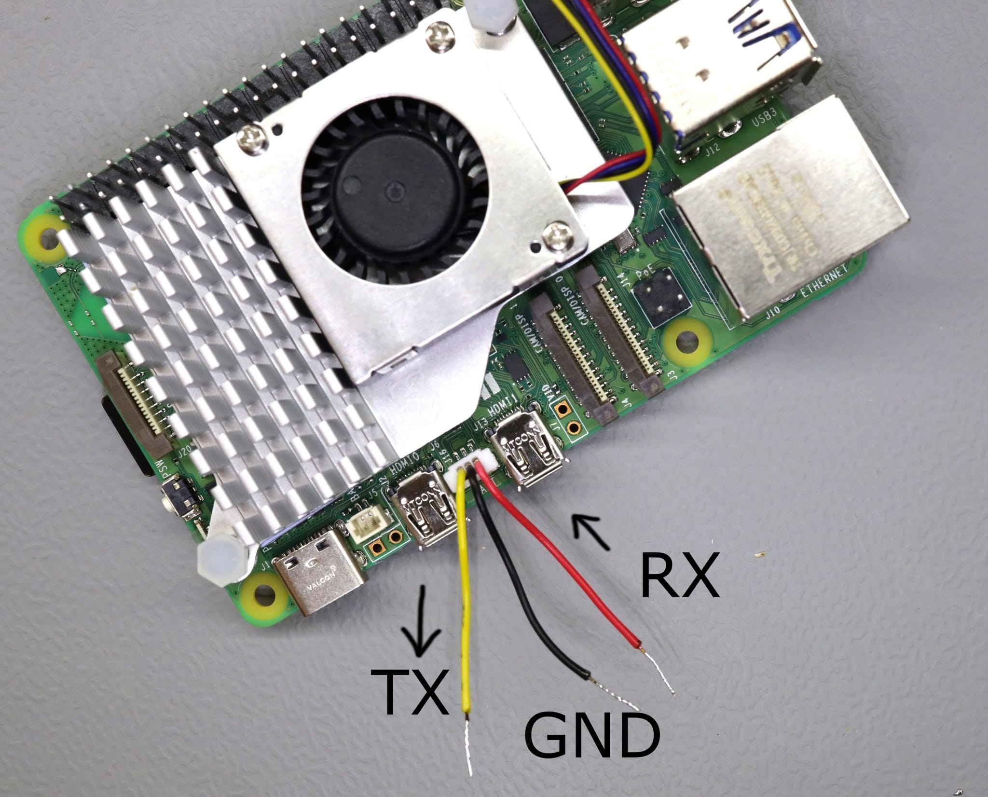
Media/ZumoPi_V02_Assembly/PiUartPinout.jpeg
