TALs-Education/ZumoPi/ZumoPi_V02/Development/BarcodeDetection/matlab/Image3.jpg

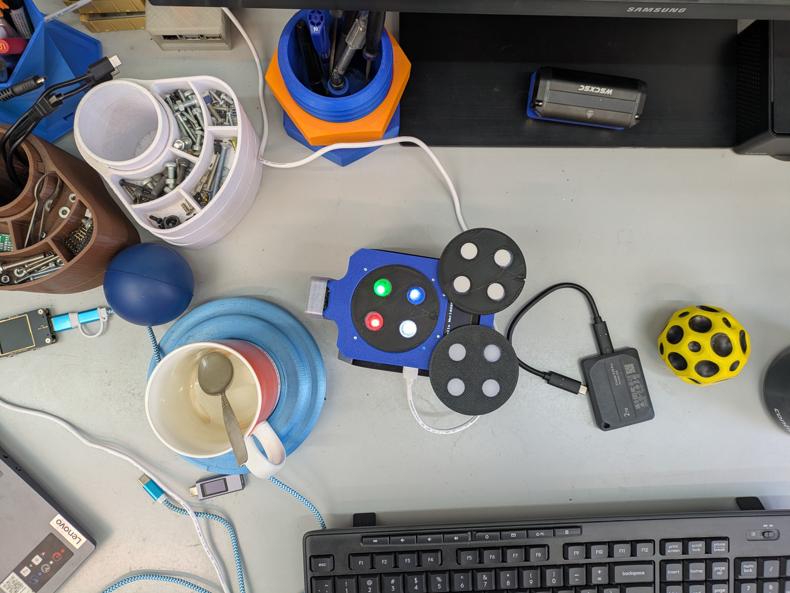
ZumoPi_V02/Development/BarcodeDetection/matlab/Image3.jpg
