TALs-Education/ZumoPi/ZumoPi_V02/Development/BarcodeDetection/matlab/Image4.jpg

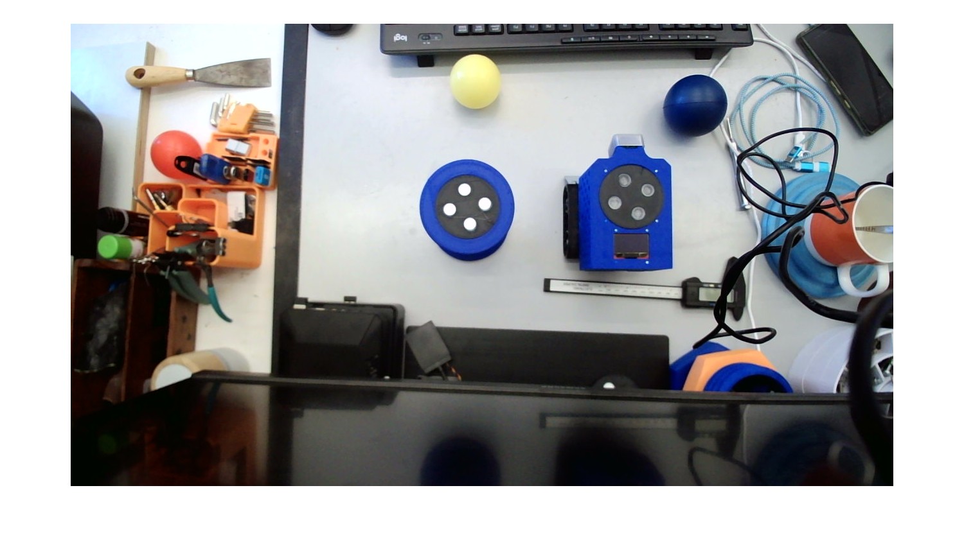
ZumoPi_V02/Development/BarcodeDetection/matlab/Image4.jpg
