TALs-Education/ZumoPi/ZumoPi_V02/Matlab_Simulation/images/distance.jpg

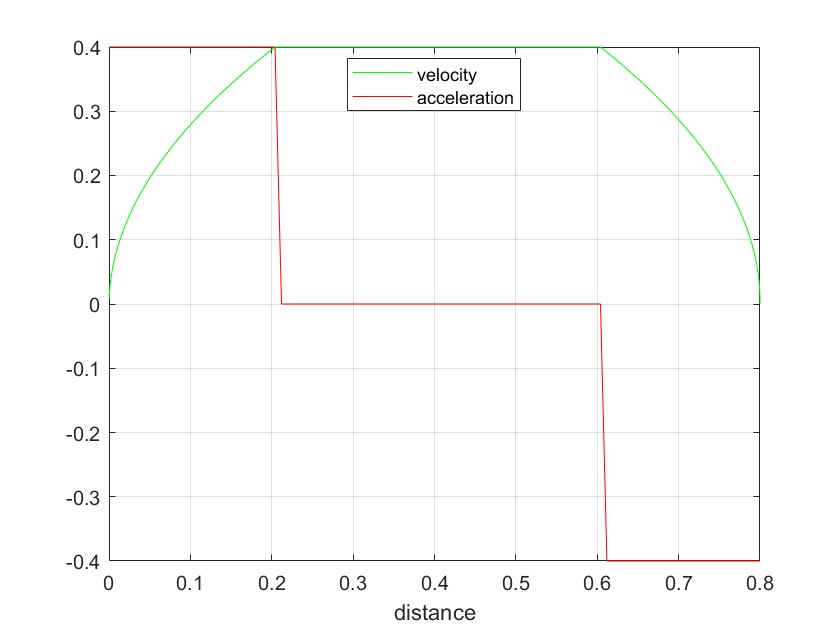
ZumoPi_V02/Matlab_Simulation/images/distance.jpg
