TALs-Education/ZumoPi/ZumoPi_V02/Matlab_Simulation/images/infSignPlot.jpg

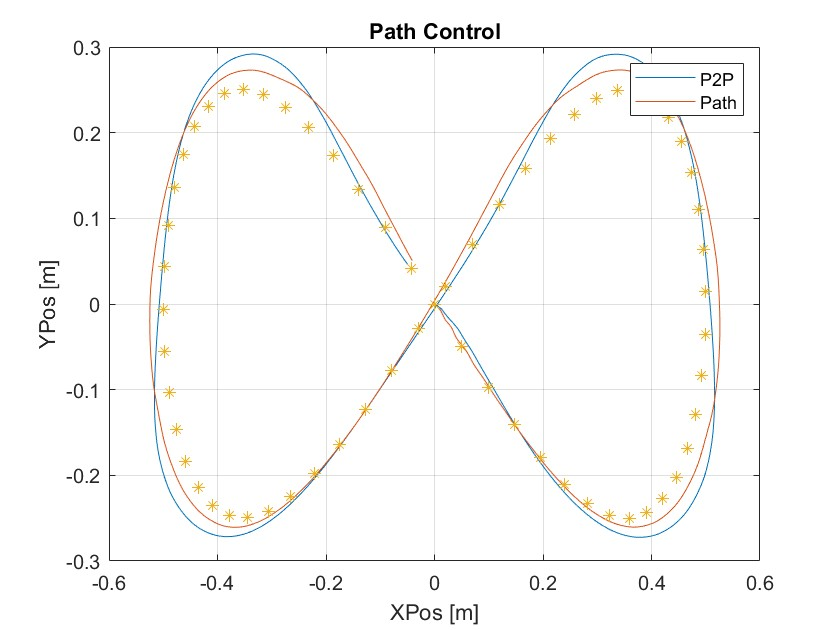
ZumoPi_V02/Matlab_Simulation/images/infSignPlot.jpg
