TALs-Education/ZumoPi/ZumoPi_V02/Matlab_Simulation/images/infSignPlot_Untuned.jpg

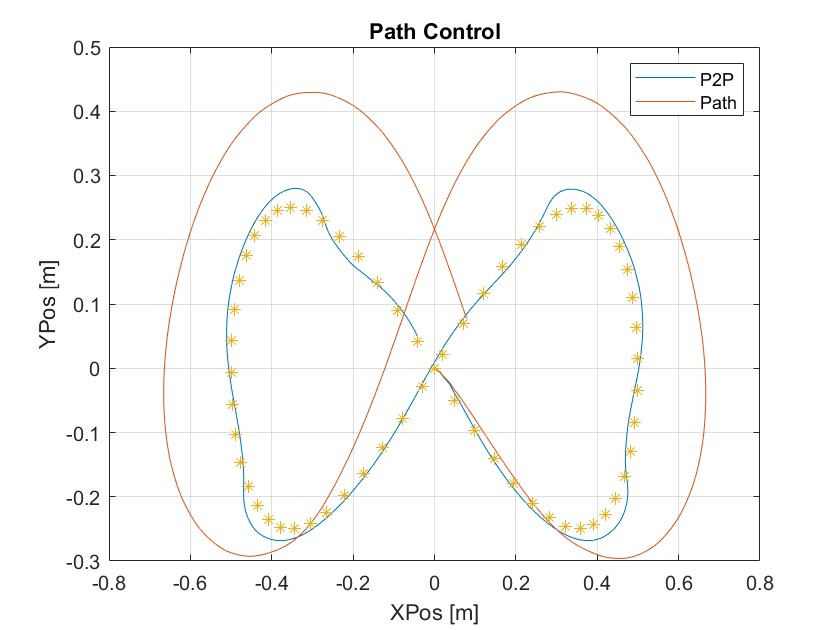
ZumoPi_V02/Matlab_Simulation/images/infSignPlot_Untuned.jpg
