TALs-Education/ZumoPi/ZumoPi_V02/Matlab_Simulation/images/P2P_Control.jpg

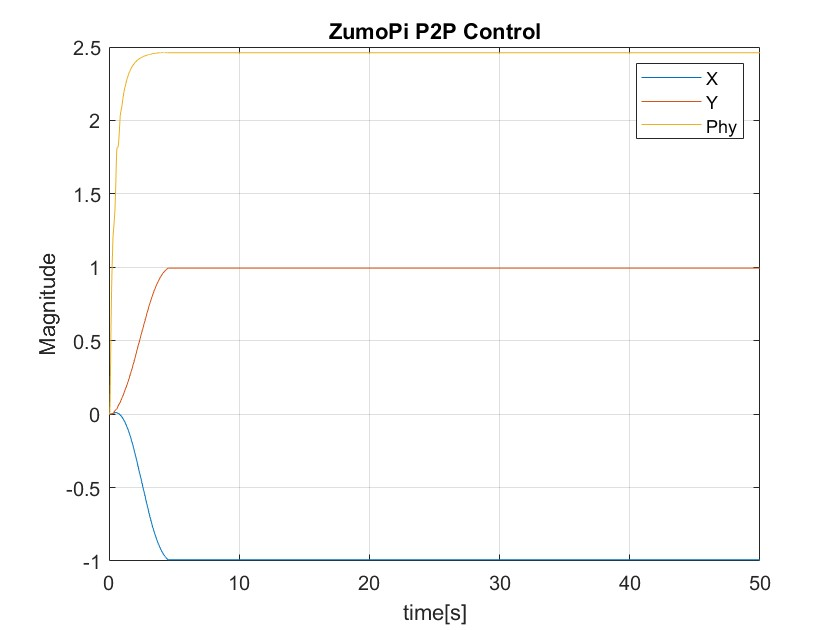
ZumoPi_V02/Matlab_Simulation/images/P2P_Control.jpg
