TALs-Education/ZumoPi/ZumoPi_V02/Matlab_Simulation/images/PathResponse.jpg

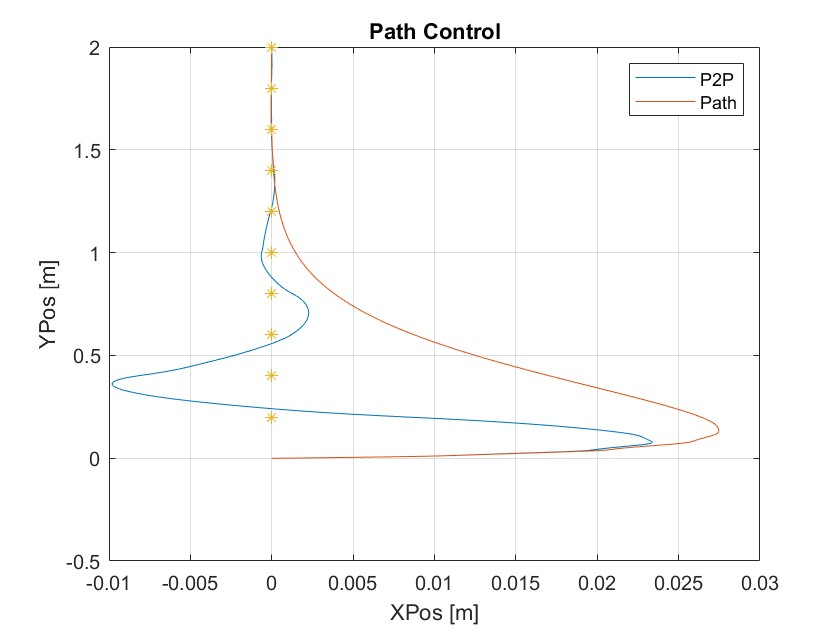
ZumoPi_V02/Matlab_Simulation/images/PathResponse.jpg
