TALs-Education/ZumoPi/ZumoPi_V02/Matlab_Simulation/images/profile.jpg

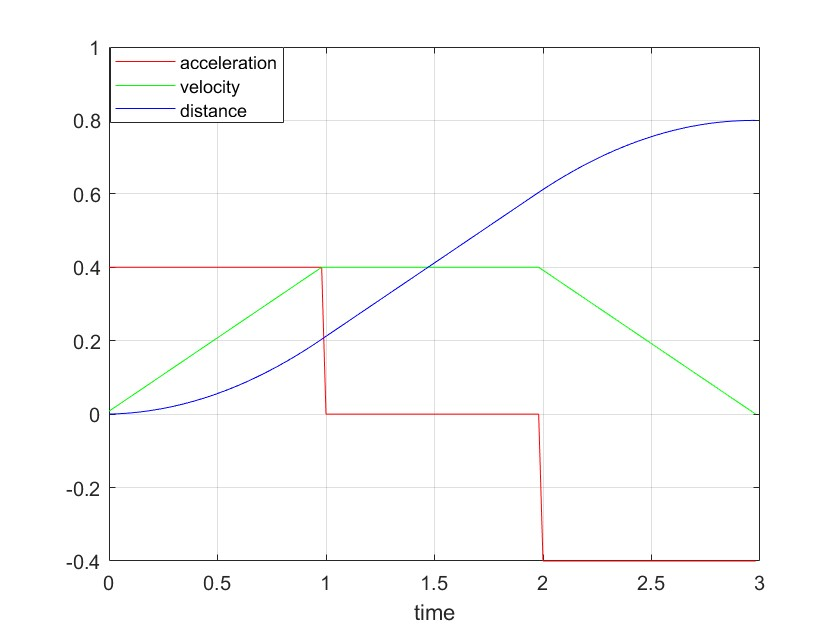
ZumoPi_V02/Matlab_Simulation/images/profile.jpg
