TALs-Education/ZumoPi/ZumoPi_V02/Python_Simulation/docs/gui_p2p_single.png

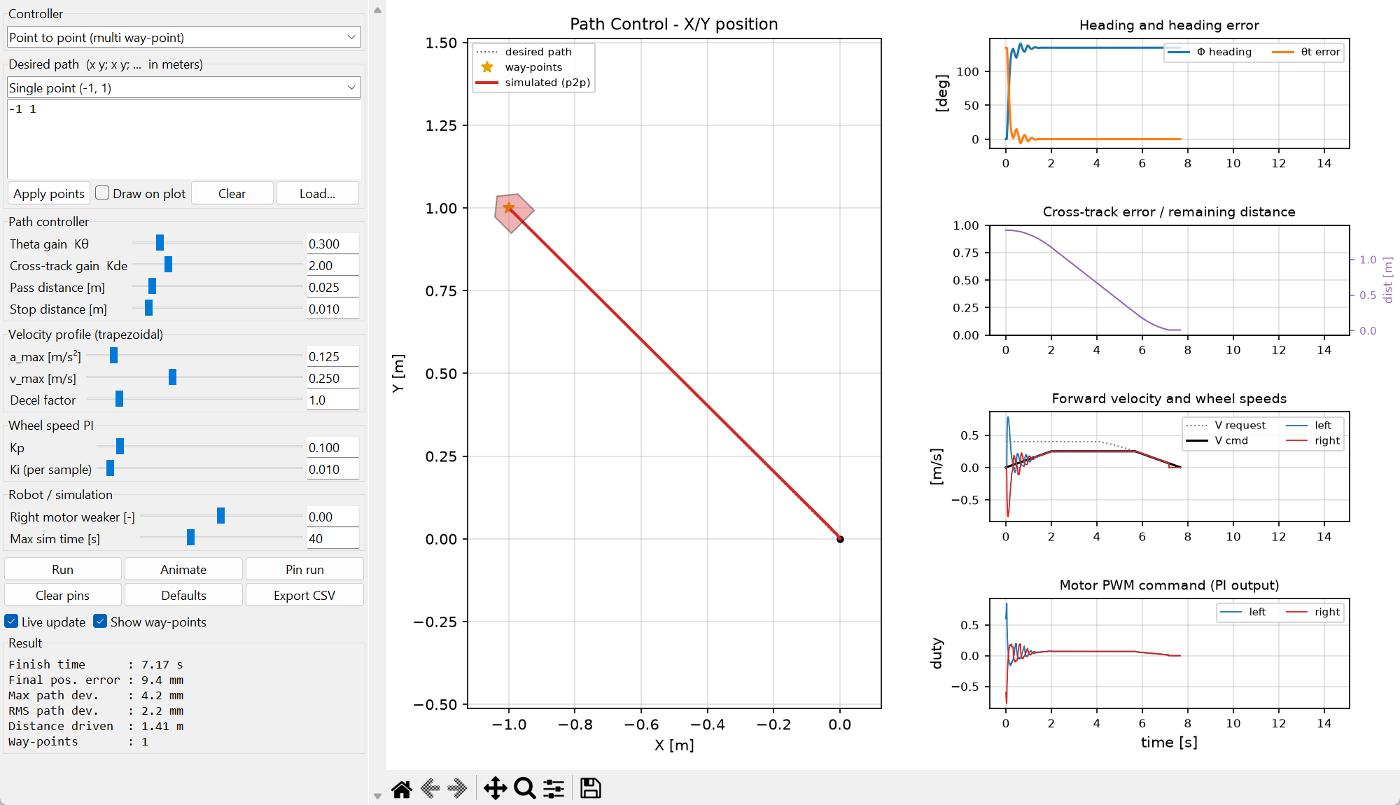
ZumoPi_V02/Python_Simulation/docs/gui_p2p_single.png
