TALs-Education/ZumoPi/ZumoPi_V02/Python_Simulation/docs/plot_inf_tuned.png

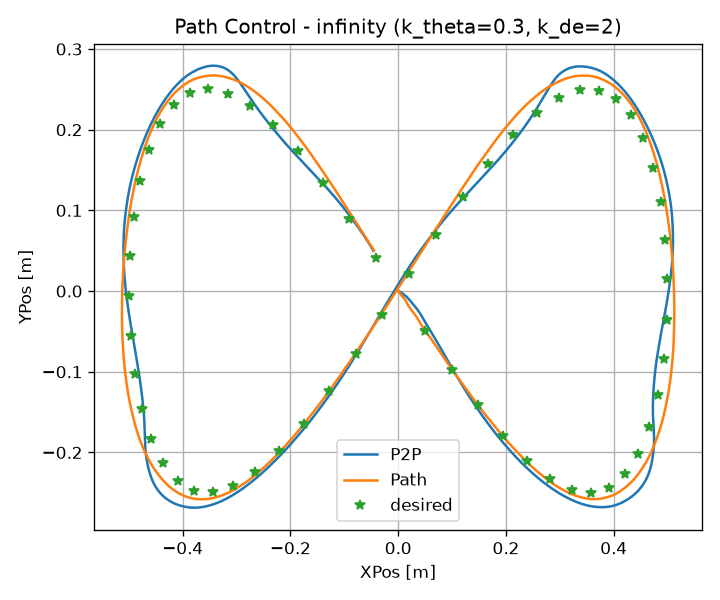
ZumoPi_V02/Python_Simulation/docs/plot_inf_tuned.png
