TALs-Education/ZumoPi/ZumoPi_V02/Python_Simulation/docs/plot_inf_untuned.png

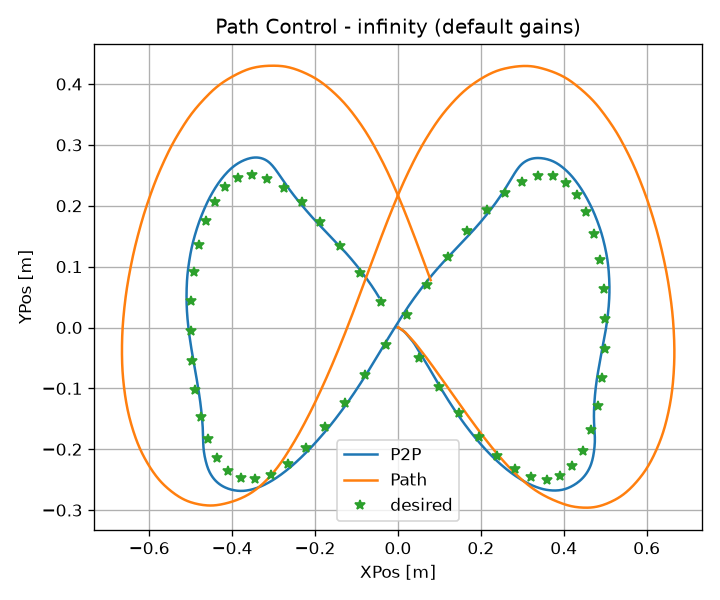
ZumoPi_V02/Python_Simulation/docs/plot_inf_untuned.png
