TALs-Education/ZumoPi/ZumoPi_V02/Python_Simulation/docs/plot_line.png

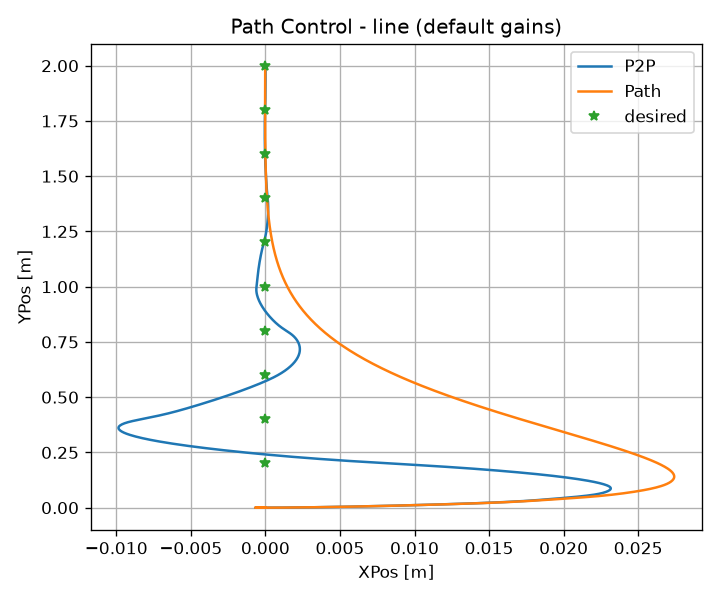
ZumoPi_V02/Python_Simulation/docs/plot_line.png
