TALs-Education/ZumoPi/ZumoPi_V02/EducationalMaterials/ZumoPi V02 BOM LIST.pdf

Github | https://github.com/TALs-Education/ZumoPi
ZumoPi V02 BOM LIST: | Fusion360 3d Model and files | https://a360.co/3Dfy8EH Without top addition: | https://a360.co/4koXErK
Part | Price (NIS) | units | Link | Comment | Additional Option
Zumo 2040 Robot | 950 | 1 https://www.pololu.com/category/308/zumo-2040-robot Pololu item: 5012
Raspberry PI 5 8GB | 390 | 1 https://piitel.co.il/shop/raspberry-pi-5/?attribute_pa_ram=8gb Piitel: 73804
Raspberry Pi AI HAT (Hailo 26 Tops) | 554 | 1 https://piitel.co.il/shop/raspberry-pi-ai-hat/ Piitel: 74090
Active Cooler | 25 | 1 https://piitel.co.il/shop/active-cooler/ Piitel: 73809
Raspberry Pi Camera Module 3 | 163 | 1 https://piitel.co.il/shop/raspberry-pi-camera-module-3/?attribute_pa_lense=wide Piitel: 73523
Official Raspberry Pi CSI | 13 | 1 https://piitel.co.il/shop/official-raspberry-pi-csi-fpc-flexible-cable-200mm-for-raspberry-pi-5-22pin-to-15pin-suitable-for-csi-camera-modules/ Piitel: 73911
Raspberry Pi 27W USB-C | 68.99 | 1 https://piitel.co.il/shop/27w-usb-c-psu/?attribute_pa_color=white Piitel: 73808
MicroSD Card 64GB | 80.73 | 1 https://piitel.co.il/shop/%d7%9b%d7%a8%d7%98%d7%99%d7%a1-%d7%96%d7%99%d7%9b%d7%a8%d7%95%d7%9f-sandisk-extreme-pro-microsdhc-sdsqxcy-064g-gn6ma-64gb/ Piitel: 72763
edimax wifi dongle 7822ulc | 150 | 1 https://www.edimax.com/edimax/merchandise/merchandise_detail/data/edimax/uk/wireless_adapters_ac1200_dual-band/ew-7822ulc/ EW-7822ULC | USB-AX55 Nano https://www.asus.com/networking-iot-servers/adapters/all-series/usb-ax55-nano/ 320
LIPOLY BATTERY CHARGER W/USB C | 28.47 | 1 https://www.digikey.co.il/en/products/detail/adafruit-industries-llc/4410/10673110 Digikey: 1528-4410-ND
M2 Spacer M F 15mm | 12.24 | 4 https://www.digikey.co.il/he/products/detail/w%C3%BCrth-elektronik/971100244/9488622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 Digikey: 732-12918-ND
M2.5 Spacer FF 20mm | 23.32 | 4 https://www.digikey.co.il/he/products/detail/w%C3%BCrth-elektronik/970200155/9488727 Digikey: 732-13023-ND
M3x10 Countersunk | 6 | 0.06 https://www.digikey.co.il/he/products/detail/io-audio-technologies/IO-M3X10-M3HN-100/13949728 Digikey: 1937-IO-M3X10/M3HN-100-ND
JST SH 1.0 3pin | 1 | 0.1 https://www.aliexpress.com/item/1005006676932842.html?spm=a2g0o.order_list.order_list_main.43.60fc1802xkUBiA aliexpress
USB-C Type C | 10 | 1 https://www.aliexpress.com/item/1005005975880130.html?spm=a2g0o.cart.0.0.183b38daNsKnDr&mp=1 aliexpress: AMLE-CMUP
Geekworm X1200 | 250 | 1 https://geekworm.com/products/x1200 https://www.aliexpress.com/item/1005006420068840.html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 Aliexpress
VL53L5CX | 160.1 | 1 https://www.4project.co.il/product/sparkfun-qwiic-mini-tof-imager-vl53l5cx 4Project: 4P-1013785 / SF-SEN-19013
18650 Li-Ion 3.7V/3000mAh - LG | 86.6 | 2 https://www.4project.co.il/product/18650-lg-hg2-battery-3.7v-3000mah 4Project: 4P-892026
LiPoly 3.7V/1200mAh/2C | 48.3 | 1 https://www.4project.co.il/product/polymer-lithium-ion-battery-3.7v-1200mah 4Project: 4P-537596
JST-PH 2-pin | 7.8 | 2 https://www.4project.co.il/product/jst-ph-2pin-connector-with-wires 4Project: 4P-682 https://vi.aliexpress.com/item/1005002332868366.html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 JST 1.25 2P
JST-SM 3-pin | 4 | 1 https://www.4project.co.il/product/540089 4Project: 4P-540089 https://vi.aliexpress.com/item/1005002332868366.html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 JST 1.25 3P
Qwiic cable 10cm | 11.4 | 1 https://www.4project.co.il/product/flexible-qwiic-cable-100mm 4Project: 4P-540126 / SF-PRT-17259
PLA+ | 20.65 | 0.25 https://www.4project.co.il/product/pla-plus-1.75mm-blue-filament 4Project: 4P-819293
M2x10 | 1.6 | 8 https://www.4project.co.il/product/screw-m2x10mm-galvanized 4Project: 4P-6744
M2 Nut | 0.8 | 4 https://www.4project.co.il/product/nut-m2-galvanized 4Project: 4P-6736
M2.5x10 | 0.8 | 4 https://www.4project.co.il/product/screw-m2.5x10mm-galvanized 4Project: 4P-6573

M2.5x30 | 1.8 | 4 https://www.4project.co.il/product/screw-m2.5x30mm-galvanized 4Project: 4P-6580
Total | 3069.6

Optional Led system

JST-PH 4-pin | 6.9 | 1 https://www.4project.co.il/product/jst-ph-4pin-connector-with-wires 4Project: 4P-684
JST-SM 4-Pin | 4.7 | 1 https://www.4project.co.il/product/540090 4Project: 4P-540090 https://vi.aliexpress.com/item/1005002332868366.html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 JST 1.25 4P
M3x6 | 0.8 | 4 https://www.4project.co.il/product/screw-m3x6mm-galvanized 4Project: 4P-6742
APA102C | 31.2 | 4 https://www.digikey.co.il/he/products/detail/american-bright-optoelectronics-corporation/BL-HBGR32L-3-TRB-8/9817409 Digikey: 2007-BL-HBGR32L-3-TRB-8TR-ND
Custom PCB | 50 | 1 https://a360.co/4kiAROl Fusion 360 design
Total | 93.6

3d printed accessories
Cones | https://a360.co/3XkSaVm
Barcode Holder | https://a360.co/4koiM1C
