TALs-Education/ZumoPi/Media/ZumoPi_V02_Assembly/ZumoPiComponents.jpg

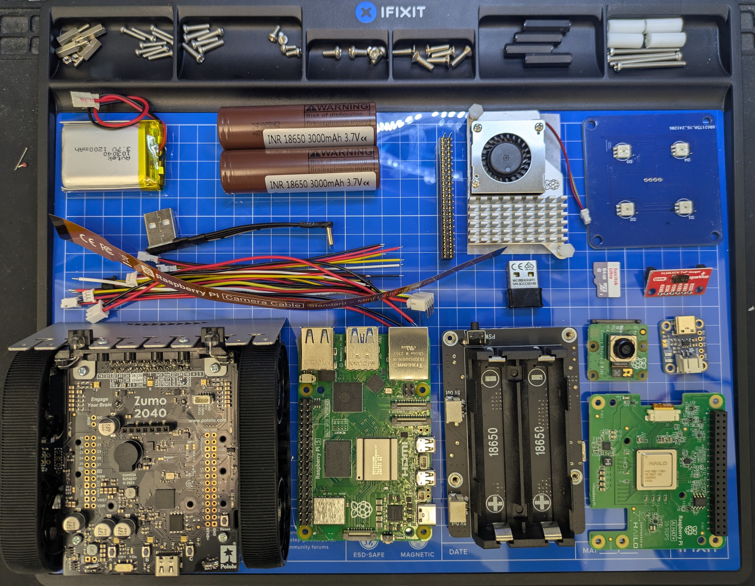
Media/ZumoPi_V02_Assembly/ZumoPiComponents.jpg
