TALs-Education/ZumoPi/ZumoPi_V02/3dModels/accessories/BarcodeCircle.3mf

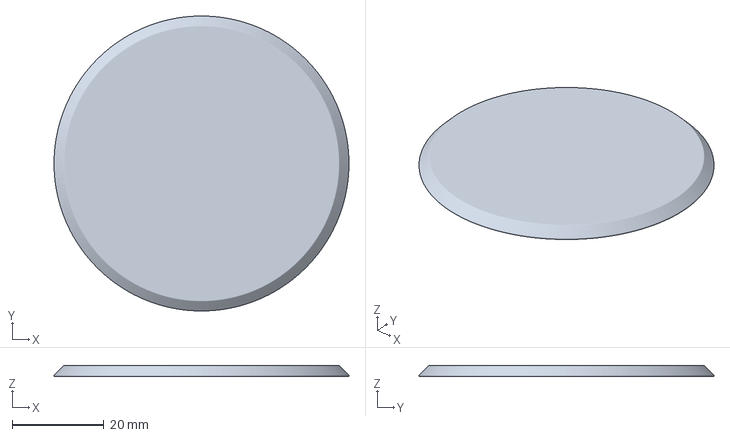
[picture p97: CAD file, 2026-08-06]
ZumoPi_V02/3dModels/accessories/BarcodeCircle.3mf
64.3 x 64.3 x 2.50 mm
