TALs-Education/ZumoPi/ZumoPi_V02/3dModels/ZumoPiV02/CarsCoversNumbered/PiCover_121.3mf

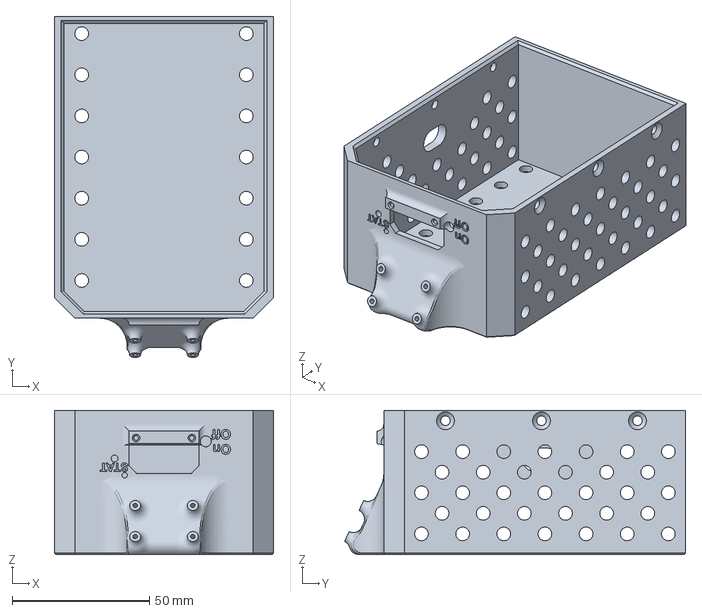
[picture p98: CAD file, 2026-09-06]
ZumoPi_V02/3dModels/ZumoPiV02/CarsCoversNumbered/PiCover_121.3mf
80.0 x 124.3 x 52.5 mm
