TALs-Education/ZumoPi/ZumoPi_V02/3dModels/ZumoPiV02/GroupedPrint.3mf

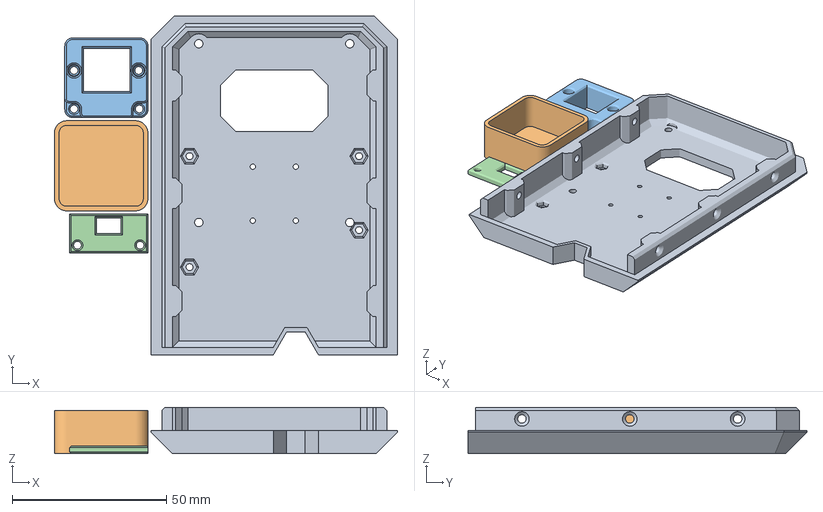
[picture p99: CAD file, 2026-08-06]
ZumoPi_V02/3dModels/ZumoPiV02/GroupedPrint.3mf
111.4 x 110.0 x 15.0 mm
PiAdapter
CameraProtection
CameraCover
TofCover
