TALs-Education/ZumoPi/ZumoPi_V02/3dModels/accessories/Cylinder_Multicolor.3mf

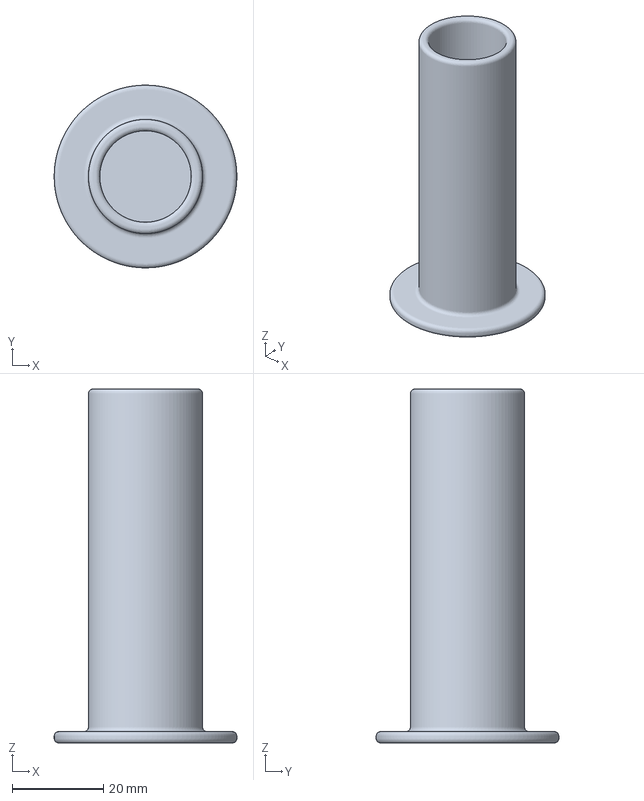
[picture p100: CAD file, 2026-08-06]
ZumoPi_V02/3dModels/accessories/Cylinder_Multicolor.3mf
40.0 x 40.0 x 77.5 mm
