TALs-Education/ZumoPi/ZumoPi_V02/3dModels/ZumoPiV02/CameraCover.3mf

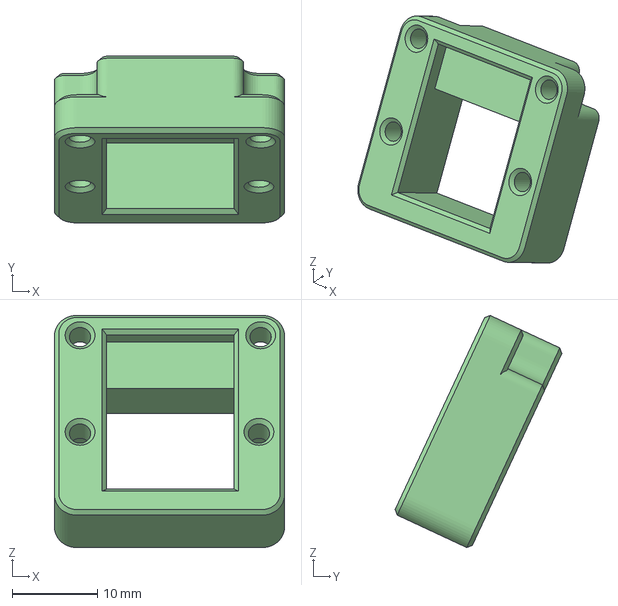
[picture p101: CAD file, 2026-08-06]
ZumoPi_V02/3dModels/ZumoPiV02/CameraCover.3mf
27.0 x 19.6 x 27.2 mm
