TALs-Education/ZumoPi/ZumoPi_V02/3dModels/accessories/SmallSignCircle.3mf

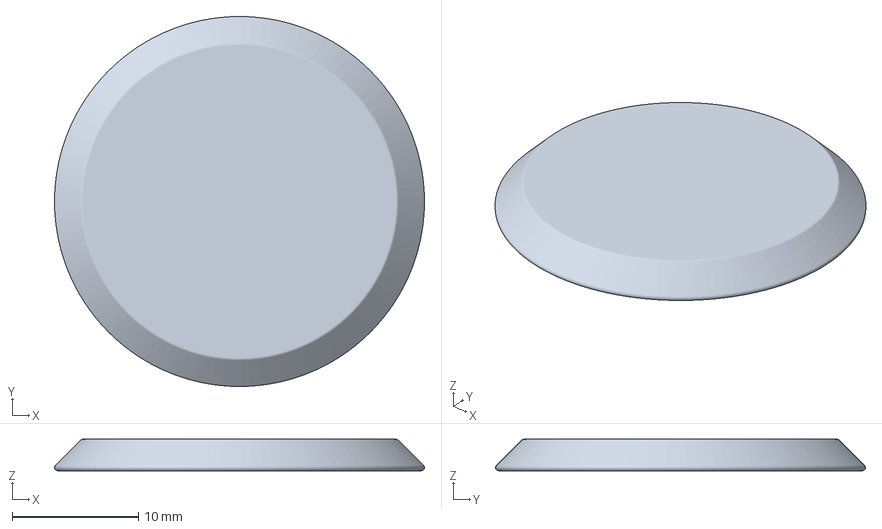
[picture p102: CAD file, 2026-08-06]
ZumoPi_V02/3dModels/accessories/SmallSignCircle.3mf
29.3 x 29.3 x 2.50 mm
