TALs-Education/ZumoPi/ZumoPi_V02/3dModels/ZumoPiV02/PiAdapter.3mf

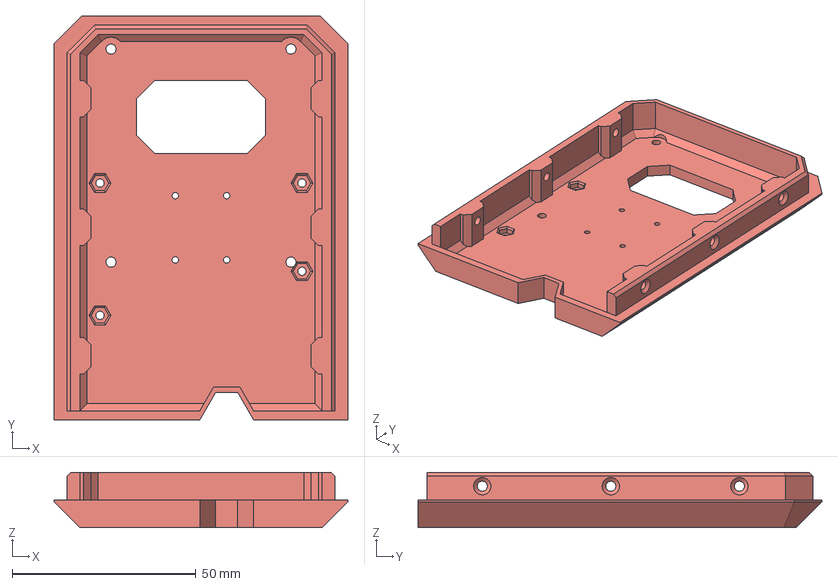
[picture p103: CAD file, 2026-08-06]
ZumoPi_V02/3dModels/ZumoPiV02/PiAdapter.3mf
80.0 x 110.0 x 15.0 mm
