TALs-Education/ZumoPi/ZumoPi_V02/3dModels/accessories/Ball.3mf

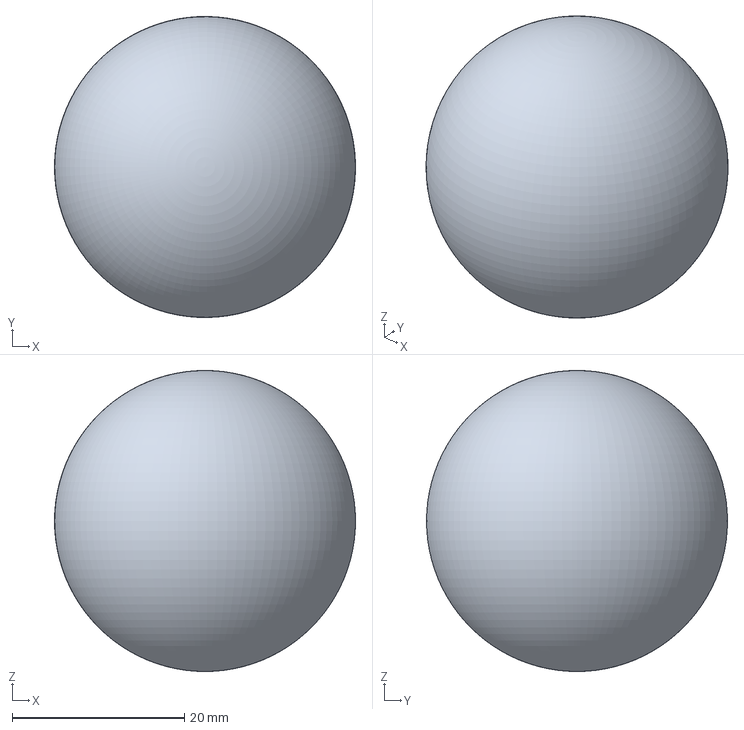
[picture p104: CAD file, 2026-08-06]
ZumoPi_V02/3dModels/accessories/Ball.3mf
35.0 x 35.0 x 35.0 mm
