TALs-Education/ZumoPi/ZumoPi_V02/3dModels/ZumoPiV02/Knob.3mf

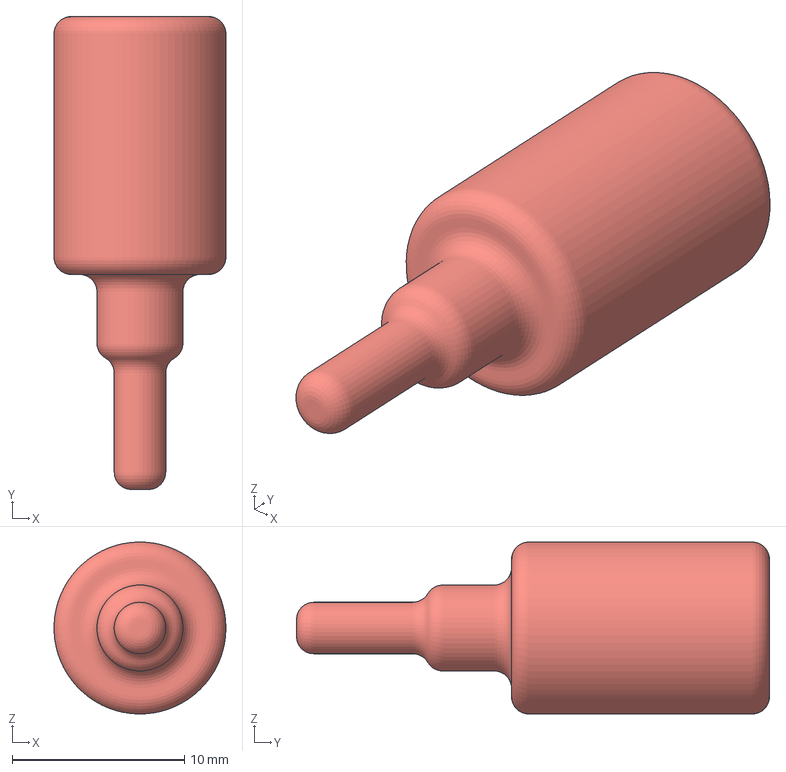
[picture p105: CAD file, 2026-08-06]
ZumoPi_V02/3dModels/ZumoPiV02/Knob.3mf
10.00 x 27.5 x 10.00 mm
