TALs-Education/ZumoPi/ZumoPi_V02/3dModels/accessories/BarcodePrints.3mf

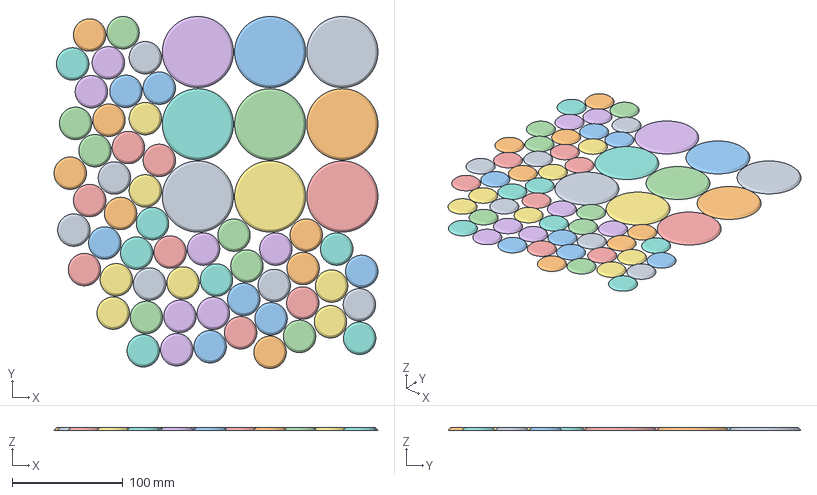
[picture p106: CAD file, 2026-08-06]
ZumoPi_V02/3dModels/accessories/BarcodePrints.3mf
292.8 x 318.2 x 2.50 mm
Assembly x 64
