TALs-Education/ZumoPi/ZumoPi_V02/3dModels/ZumoPiV02/TofCover.3mf

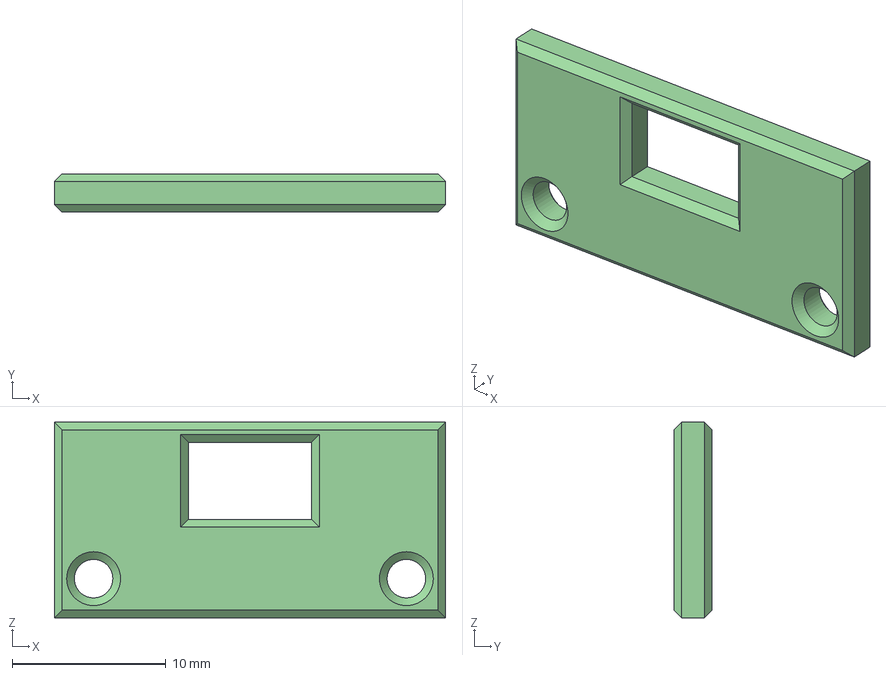
[picture p107: CAD file, 2026-08-06]
ZumoPi_V02/3dModels/ZumoPiV02/TofCover.3mf
25.4 x 2.50 x 12.7 mm
