TALs-Education/ZumoPi/ZumoPi_V02/3dModels/accessories/Cone_MultiColor.3mf

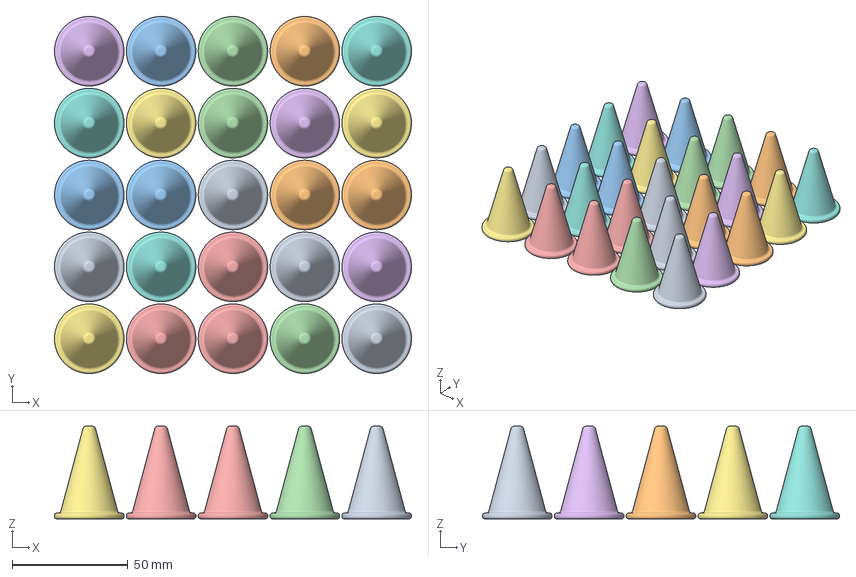
[picture p108: CAD file, 2026-08-06]
ZumoPi_V02/3dModels/accessories/Cone_MultiColor.3mf
154.0 x 154.0 x 40.0 mm
Cone_MultiColor x 25
