TALs-Education/ZumoPi/ZumoPi_V02/3dModels/ZumoPiV02/CameraProtection.3mf

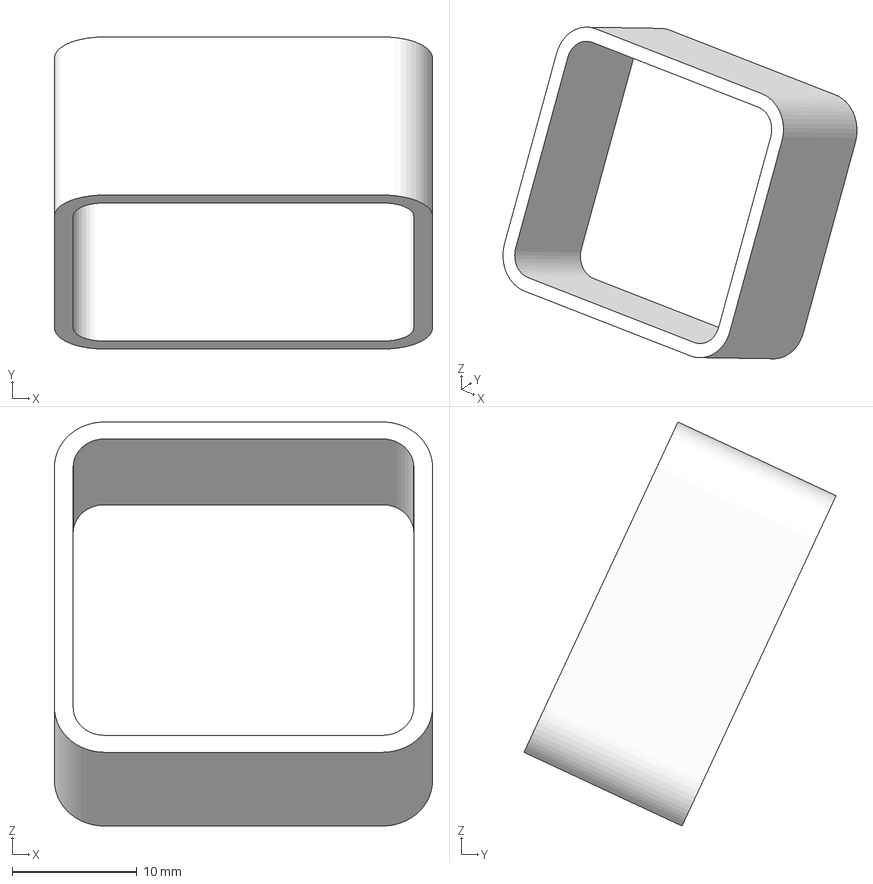
[picture p109: CAD file, 2026-08-06]
ZumoPi_V02/3dModels/ZumoPiV02/CameraProtection.3mf
30.4 x 25.0 x 32.4 mm
