TALs-Education/ZumoPi/ZumoPi_V02/3dModels/accessories/Cylinder_Small_Multicolor.3mf

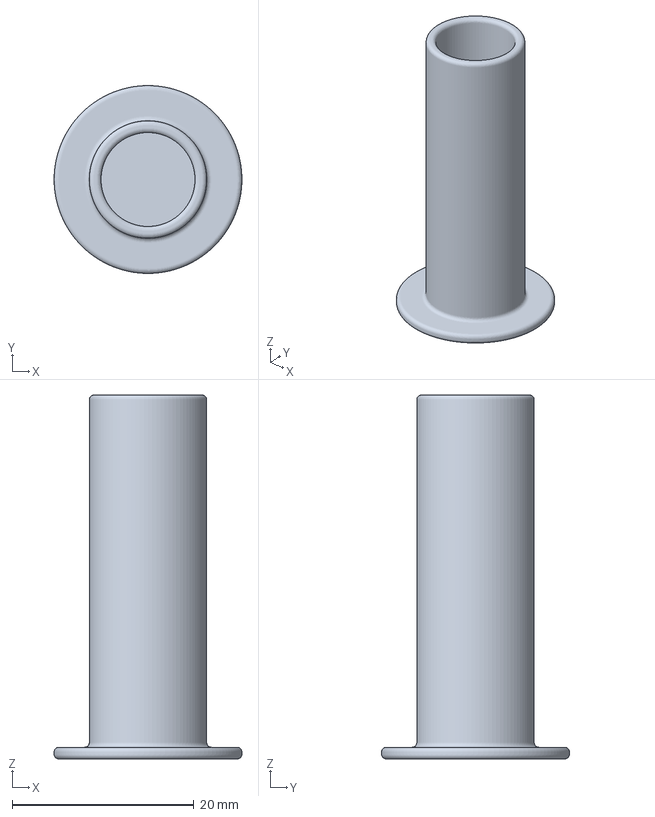
[picture p110: CAD file, 2026-08-06]
ZumoPi_V02/3dModels/accessories/Cylinder_Small_Multicolor.3mf
20.6 x 20.6 x 40.0 mm
