TALs-Education/ZumoPi/(list of files, cad)

Other CAD files:
ZumoPi_V02/3dModels/ZumoPiV02/CarsCoversNumbered/PiCover_125.3mf
ZumoPi_V02/3dModels/ZumoPiV02/CarsCoversNumbered/PiCover_124.3mf
ZumoPi_V02/3dModels/ZumoPiV02/CarsCoversNumbered/PiCover_123.3mf
ZumoPi_V02/3dModels/ZumoPiV02/CarsCoversNumbered/PiCover_122.3mf
ZumoPi_V02/3dModels/ZumoPiV02/CarsCoversNumbered/PiCover_120.3mf
ZumoPi_V02/3dModels/ZumoPiV02/CarsCoversNumbered/PiCover_126.3mf
ZumoPi_V02/3dModels/ZumoPiV02/PiCover.3mf
ZumoPi_V02/3dModels/ZumoPiV02/CarsCoversNumbered/PiCover_130.3mf
ZumoPi_V02/3dModels/ZumoPiV02/CarsCoversNumbered/PiCover_127.3mf
ZumoPi_V02/3dModels/ZumoPiV02/CarsCoversNumbered/PiCover_128.3mf
ZumoPi_V02/3dModels/ZumoPiV02/CarsCoversNumbered/PiCover_129.3mf
ZumoPi_V01/Zumo Platform/3d/zum02c-drill.dxf
ZumoPi_V02/3dModels/ZumoPiV02/ZumoPi_Basic_V02.f3z
