TALs-Education/ZumoPi/ZumoPi_V01/fresh_build.txt

Install rasbian using pi imager
Perform system update, enable ssh, vnc, camera, etc.

install EW-7822ULC/UTC adapter - https://github.com/cilynx/rtl88x2bu
tutorials - install prerequirments from tutorial install driver using make 
https://simsalabasim.medium.com/edimax-7822-wifi-usb-dongle-on-raspberry-pi-4-4f839db76e1e
https://edimax.freshdesk.com/support/solutions/articles/14000062079-how-to-install-ew-7822ulc-utc-adapter-on-raspberry-pi
$cd rtl8822bu
$make
$sudo make install

install arduino arm 32
$sudo apt install arduino
add zumo libraries 	https://www.pololu.com/docs/0J63/5.2
install arduino-cli  	https://siytek.com/arduino-cli-raspberry-pi/

setup arduino cores:
$arduino-cli core install arduino:avr

work with virtualenv: https://learn.adafruit.com/python-virtual-environment-usage-on-raspberry-pi/overview
$sudo apt install python3-venv
$python3 -m venv zumoPy

activate enviroment
$source zumoPy/bin/activate

deactivate enviroment:
$deactivate

Backup enviroment:
$pip freeze > requirements.txt

Update enviroment:
$pip install -r requirements.txt

upgrade python-pip
$python3 -m pip install --upgrade pip

python packages:
$pip install dash
$pip install evdev
$pip install pyserial
$pip install dash-daq

#legacy camera setup
&sudo apt install python3-picamzero

&pip install picamera
&pip install --upgrade picamera[array]

install i2ctools
https://snapcraft.io/install/i2ctools/raspbian

Setup pi UPS: https://wiki.geekworm.com/X728
$git clone https://github.com/geekworm-com/x728
$cd x728
$chmod +x *.sh
$sudo bash x728-v1.0.sh // or latest version present 2.1
