TALs-Education/ZumoPi/Media/ZumoPi_V02_Assembly/AssembledZumoPiV02.jpg

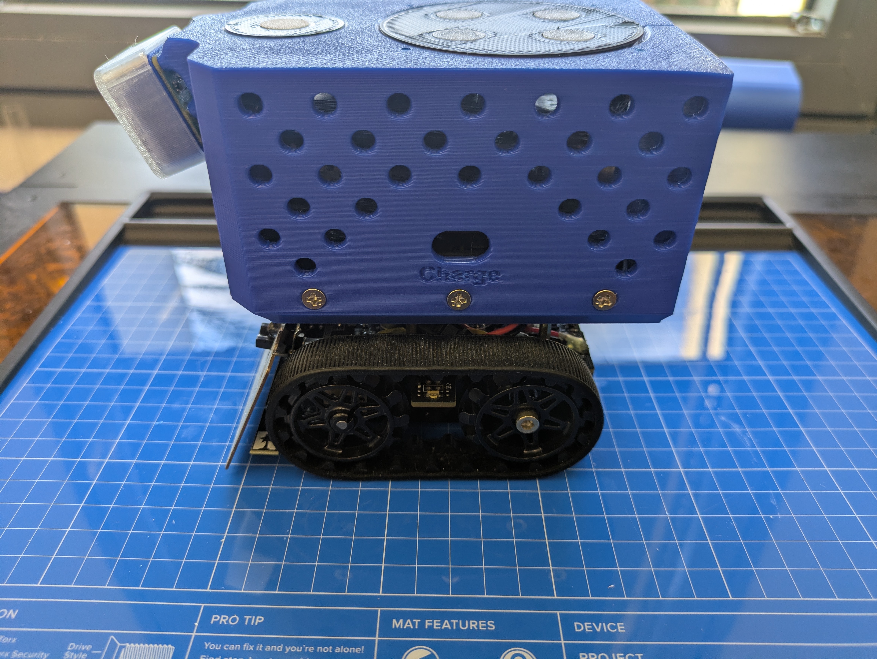
Media/ZumoPi_V02_Assembly/AssembledZumoPiV02.jpg
