TALs-Education/ZumoPi/Media/ZumoPi_V02_Assembly/BatteryCharger.jpg

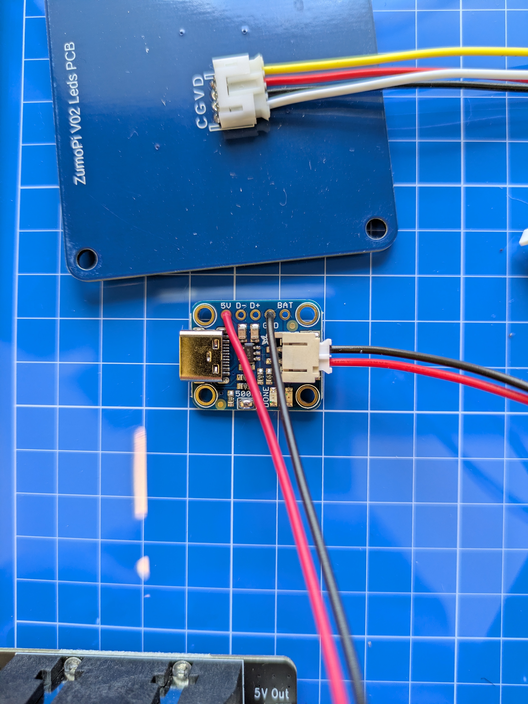
Media/ZumoPi_V02_Assembly/BatteryCharger.jpg
