TALs-Education/ZumoPi/Media/ZumoPi_V02_Assembly/CameraAssembly.jpg

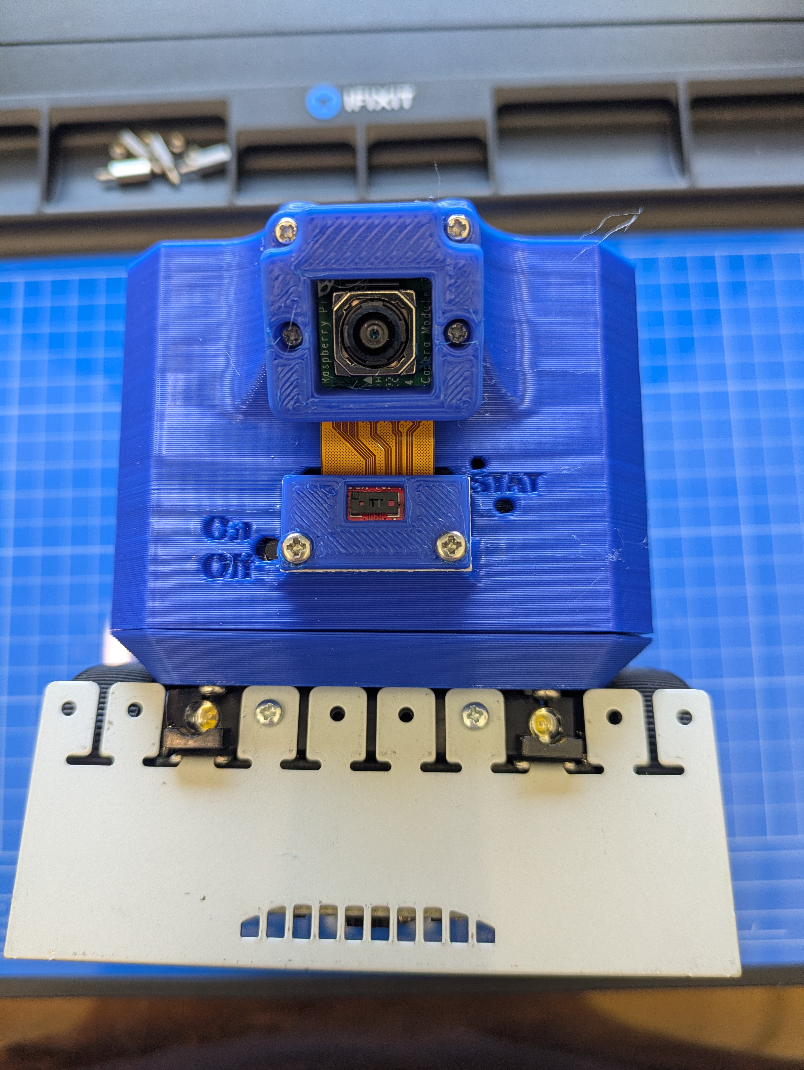
Media/ZumoPi_V02_Assembly/CameraAssembly.jpg
