TALs-Education/ZumoPi/Media/ZumoPi_V02_Assembly/Connectors.jpg

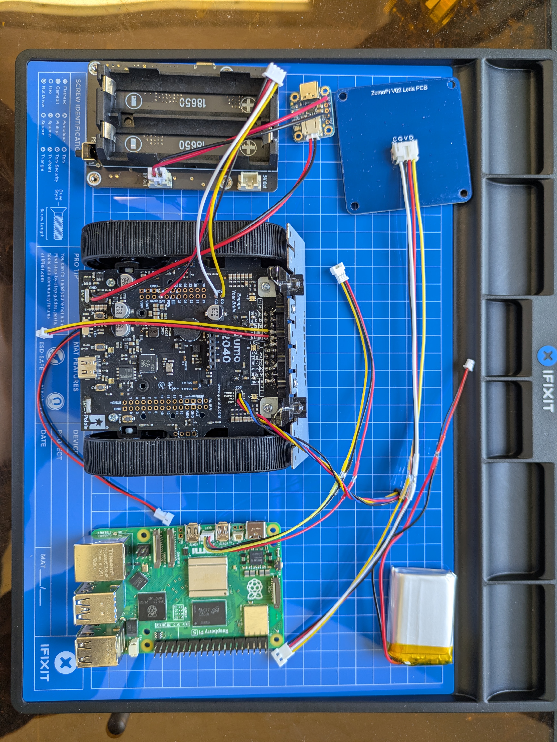
Media/ZumoPi_V02_Assembly/Connectors.jpg
