TALs-Education/ZumoPi/Media/ZumoPi_V02_Assembly/FullUnitAssembly.jpg

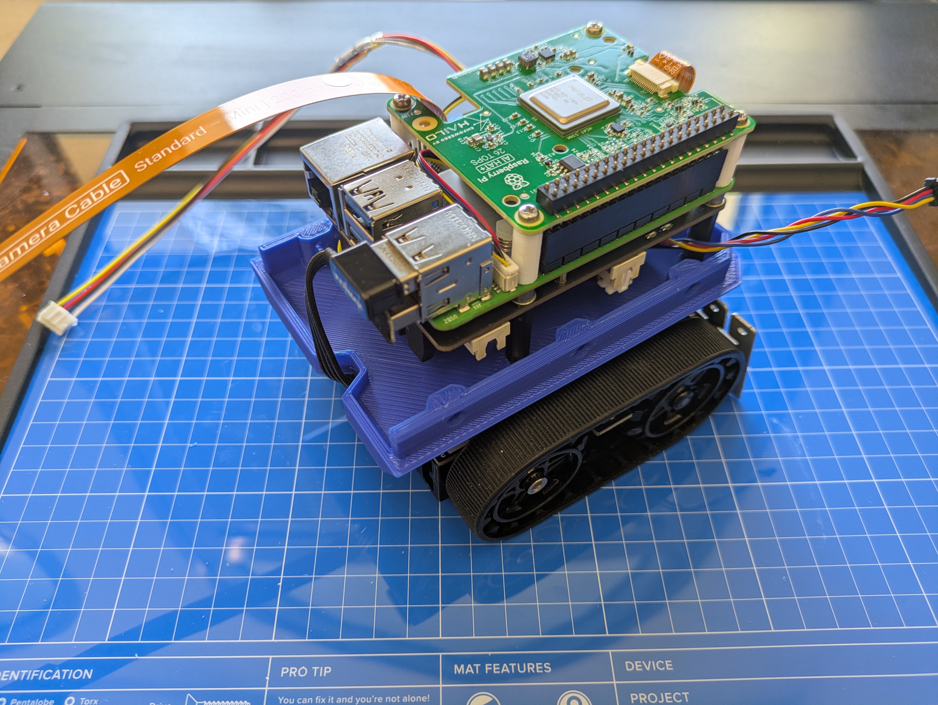
Media/ZumoPi_V02_Assembly/FullUnitAssembly.jpg
