TALs-Education/ZumoPi/Media/ZumoPi_V02_Assembly/LedPCBAssembly.jpg

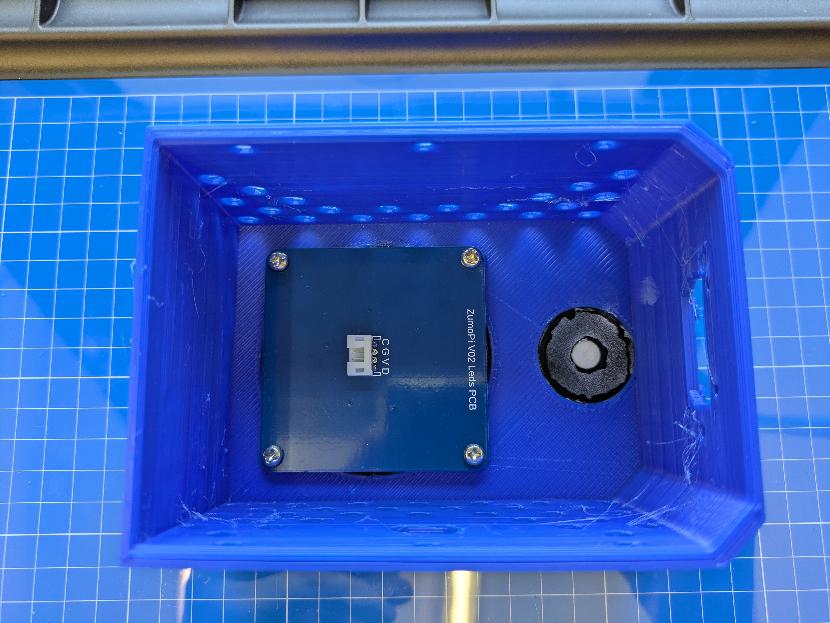
Media/ZumoPi_V02_Assembly/LedPCBAssembly.jpg
