TALs-Education/ZumoPi/Media/ZumoPi_V02_Assembly/LedsPCBWiring.jpg

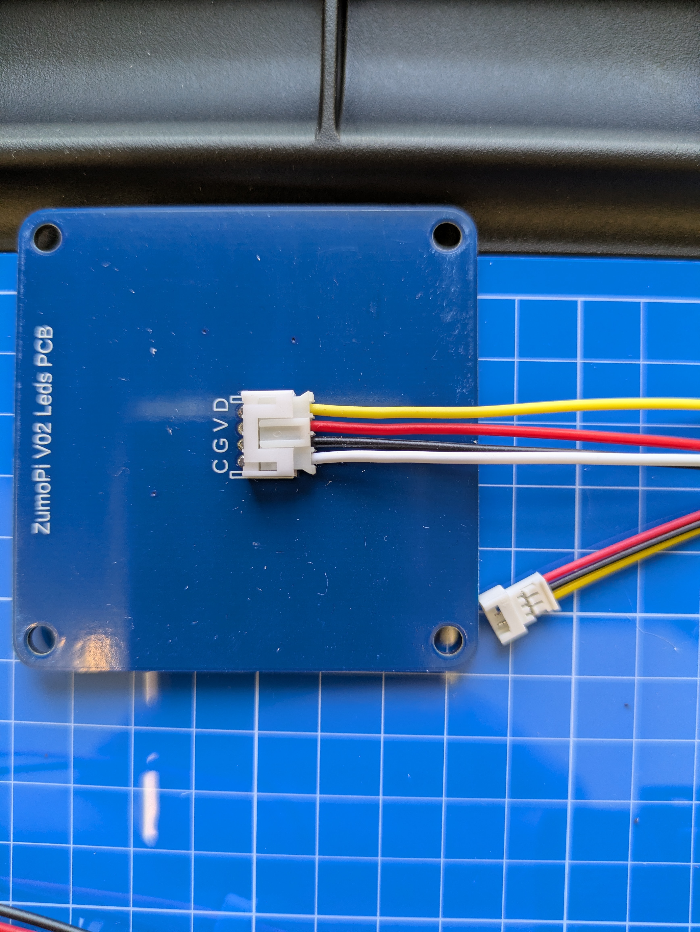
Media/ZumoPi_V02_Assembly/LedsPCBWiring.jpg
