TALs-Education/ZumoPi/Media/ZumoPi_V02_Assembly/PiAssembly.jpg

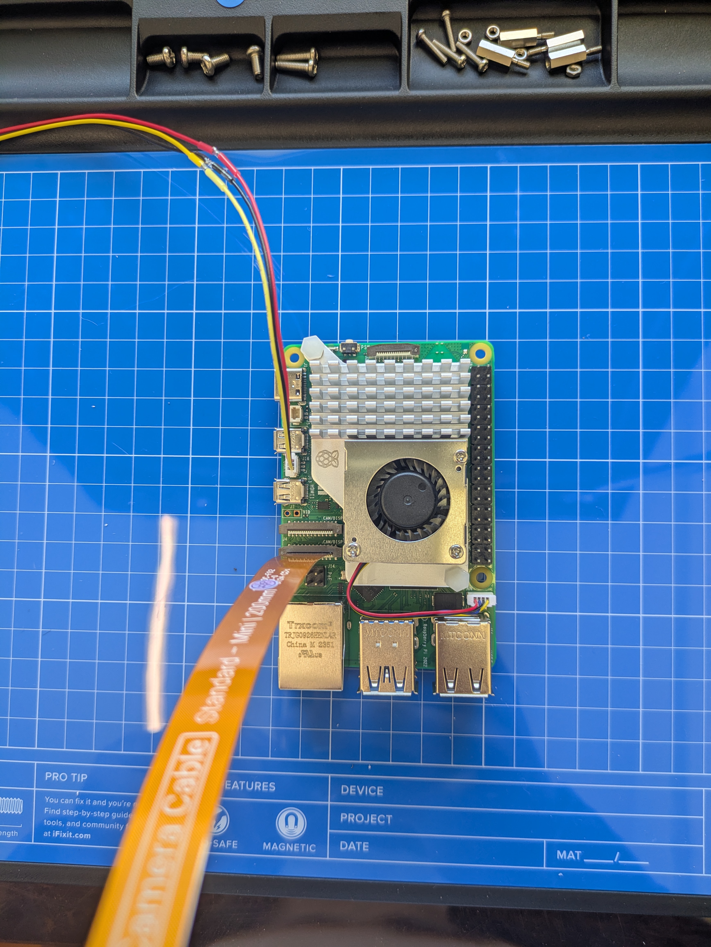
Media/ZumoPi_V02_Assembly/PiAssembly.jpg
