TALs-Education/ZumoPi/Media/ZumoPi_V02_Assembly/StandoffAssembly.jpg

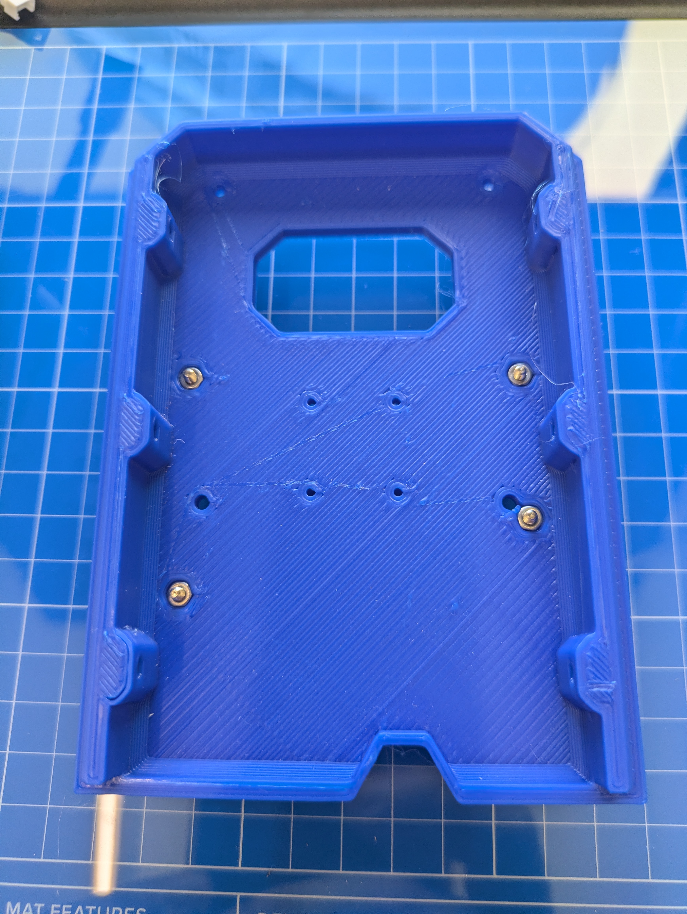
Media/ZumoPi_V02_Assembly/StandoffAssembly.jpg
