TALs-Education/ZumoPi/Media/ZumoPi_V02_Assembly/ThickWires/PXL_20251112_133846683.jpg

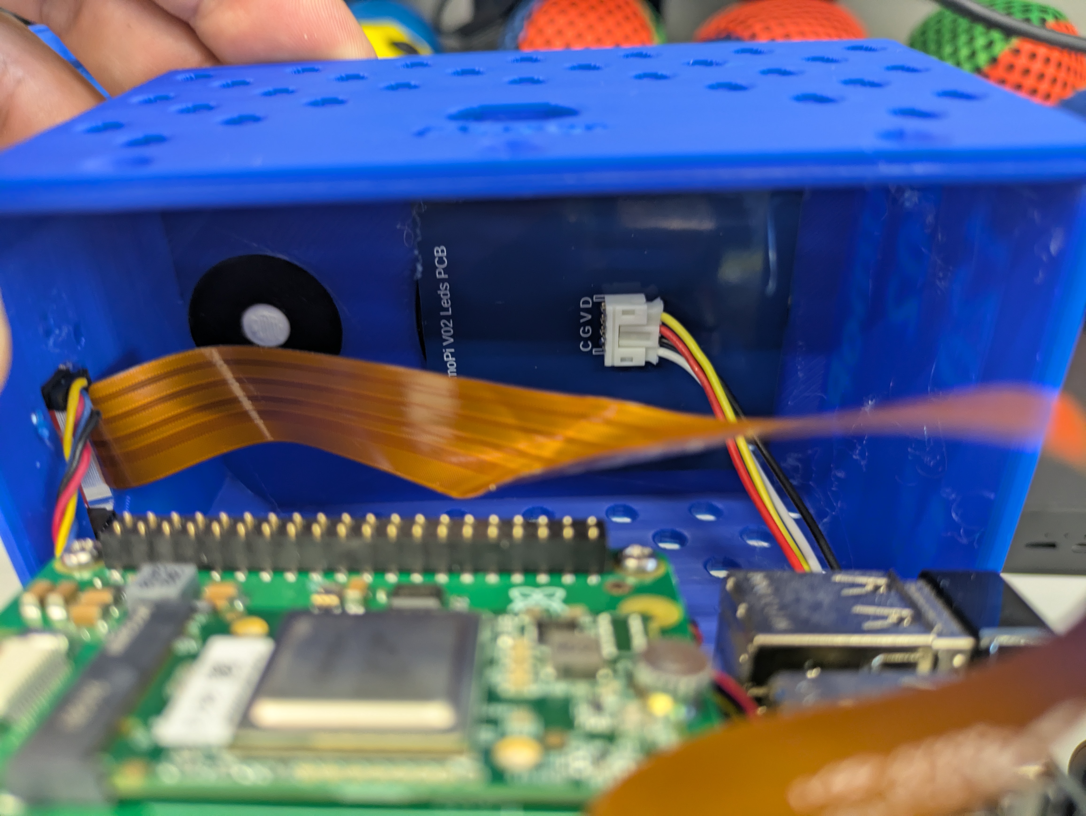
Media/ZumoPi_V02_Assembly/ThickWires/PXL_20251112_133846683.jpg
