TALs-Education/ZumoPi/Media/ZumoPi_V02_Assembly/TOFAssembly.jpg

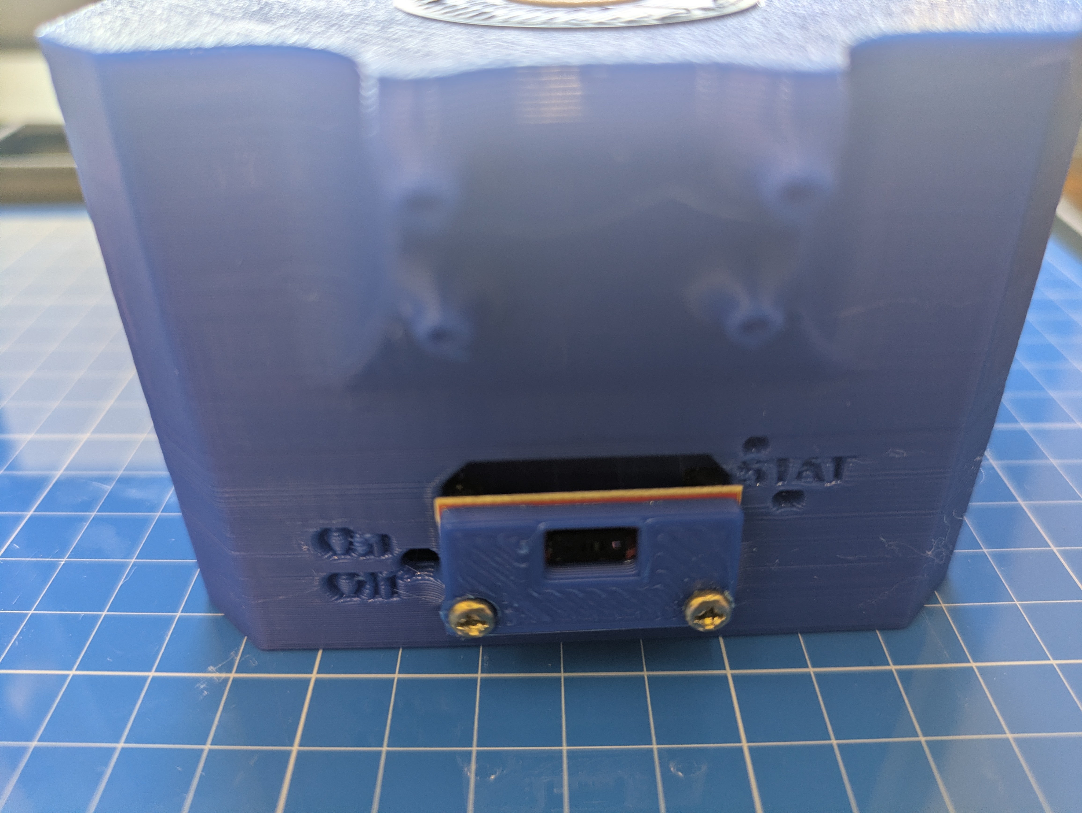
Media/ZumoPi_V02_Assembly/TOFAssembly.jpg
