TALs-Education/ZumoPi/Media/ZumoPi_V02_Assembly/UartWiring.jpg

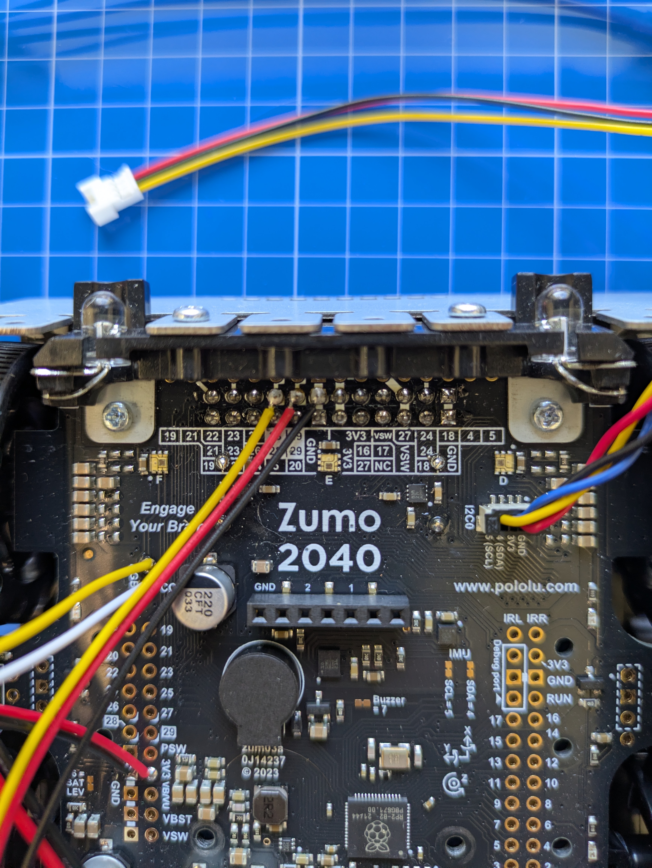
Media/ZumoPi_V02_Assembly/UartWiring.jpg
