TALs-Education/ZumoPi/Media/ZumoPi_V02_Assembly/ZumoConnectors1.jpg

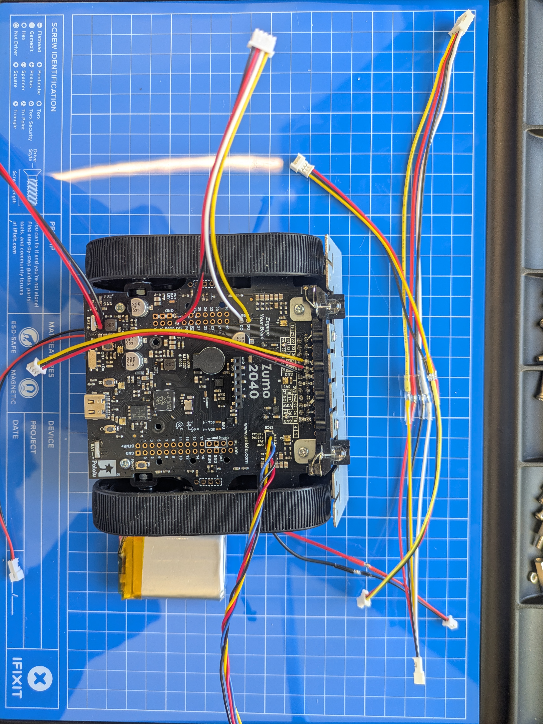
Media/ZumoPi_V02_Assembly/ZumoConnectors1.jpg
