TALs-Education/ZumoPi/Media/ZumoPi_V02_Assembly/ZumoConnectors2.jpg

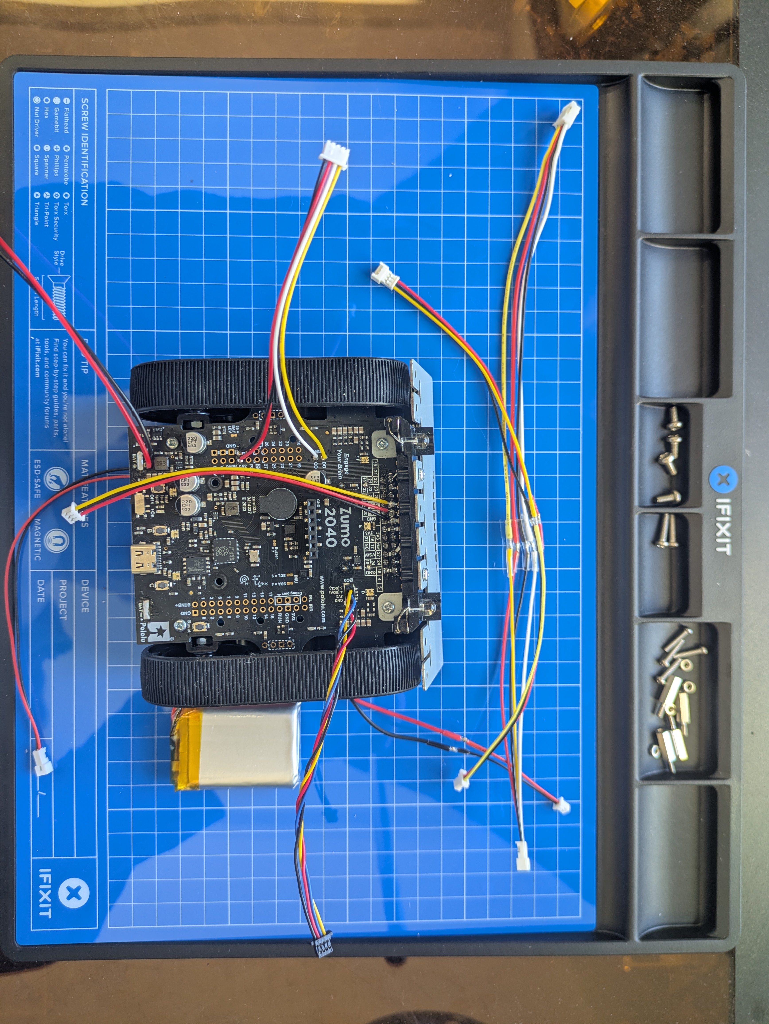
Media/ZumoPi_V02_Assembly/ZumoConnectors2.jpg
