TALs-Education/ZumoPi/ZumoPi_V02/old_Designs/Components/SparkFun_Qwiic_VR_IMU_Breakout.pdf

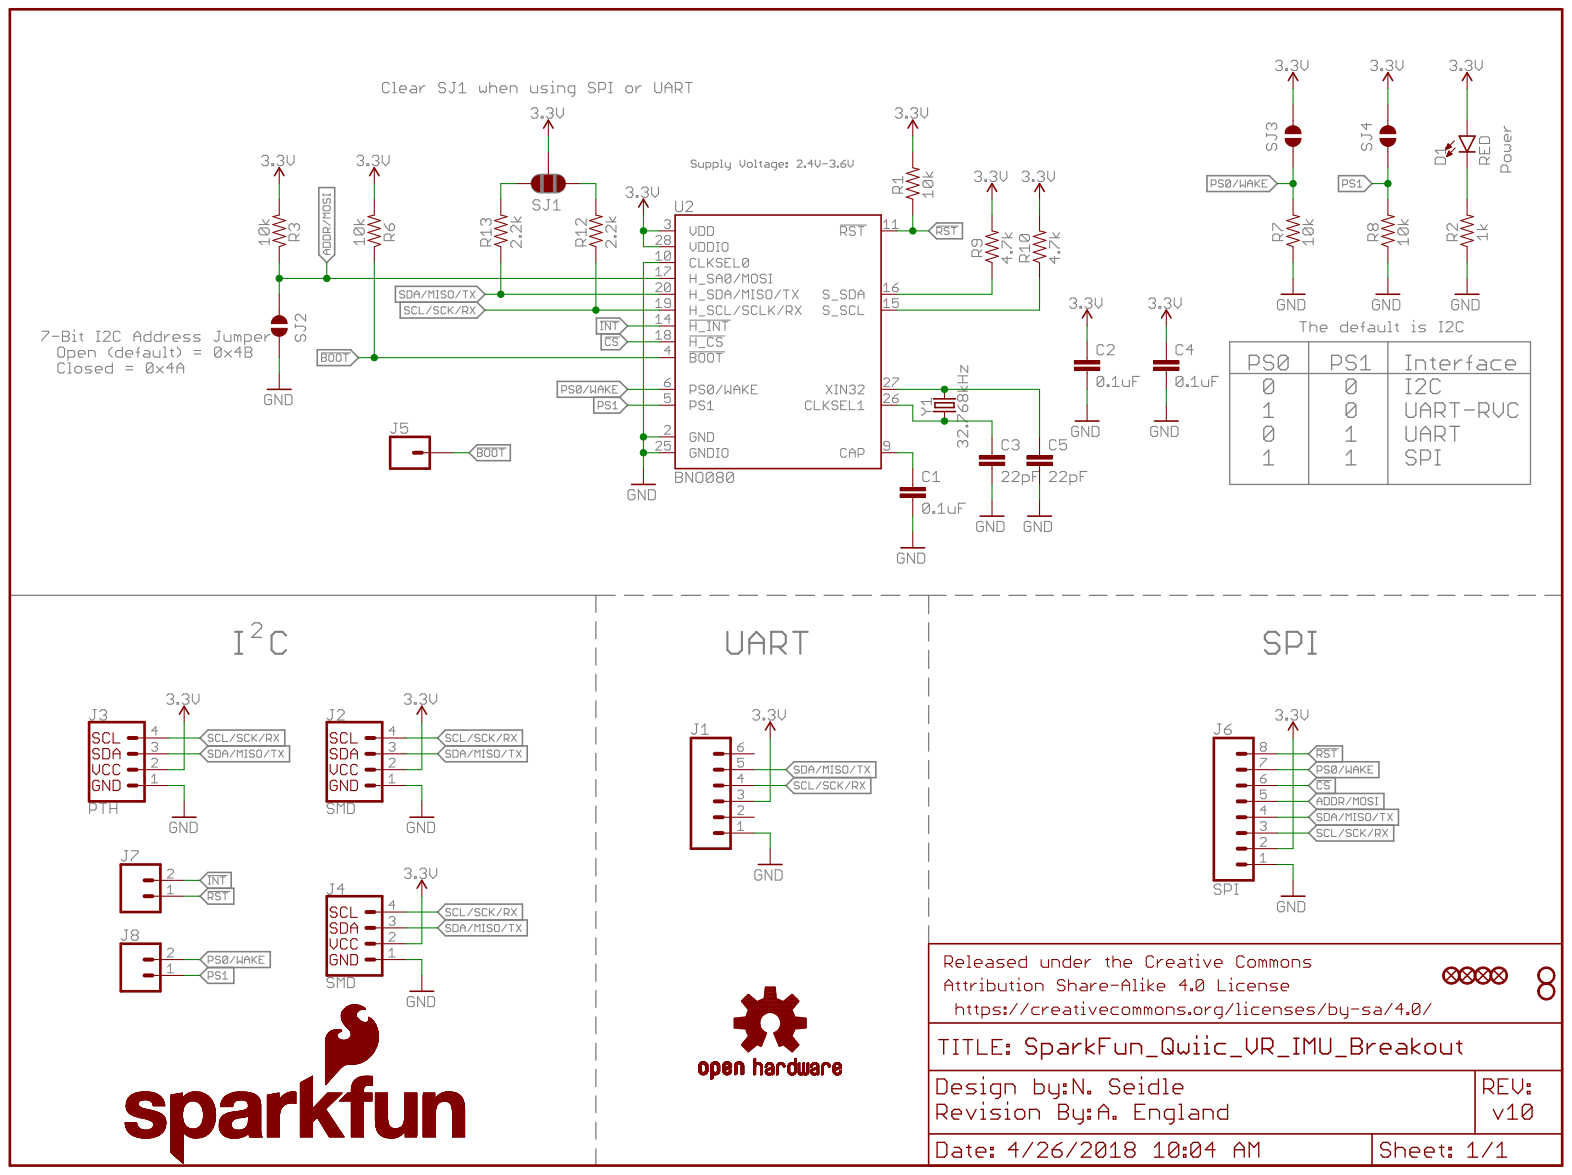
[picture p128: page 1]
