TALs-Education/ZumoPi/ZumoPi_V02/old_Designs/MCU/MicroMod_Processor_Board-nRF52840.pdf

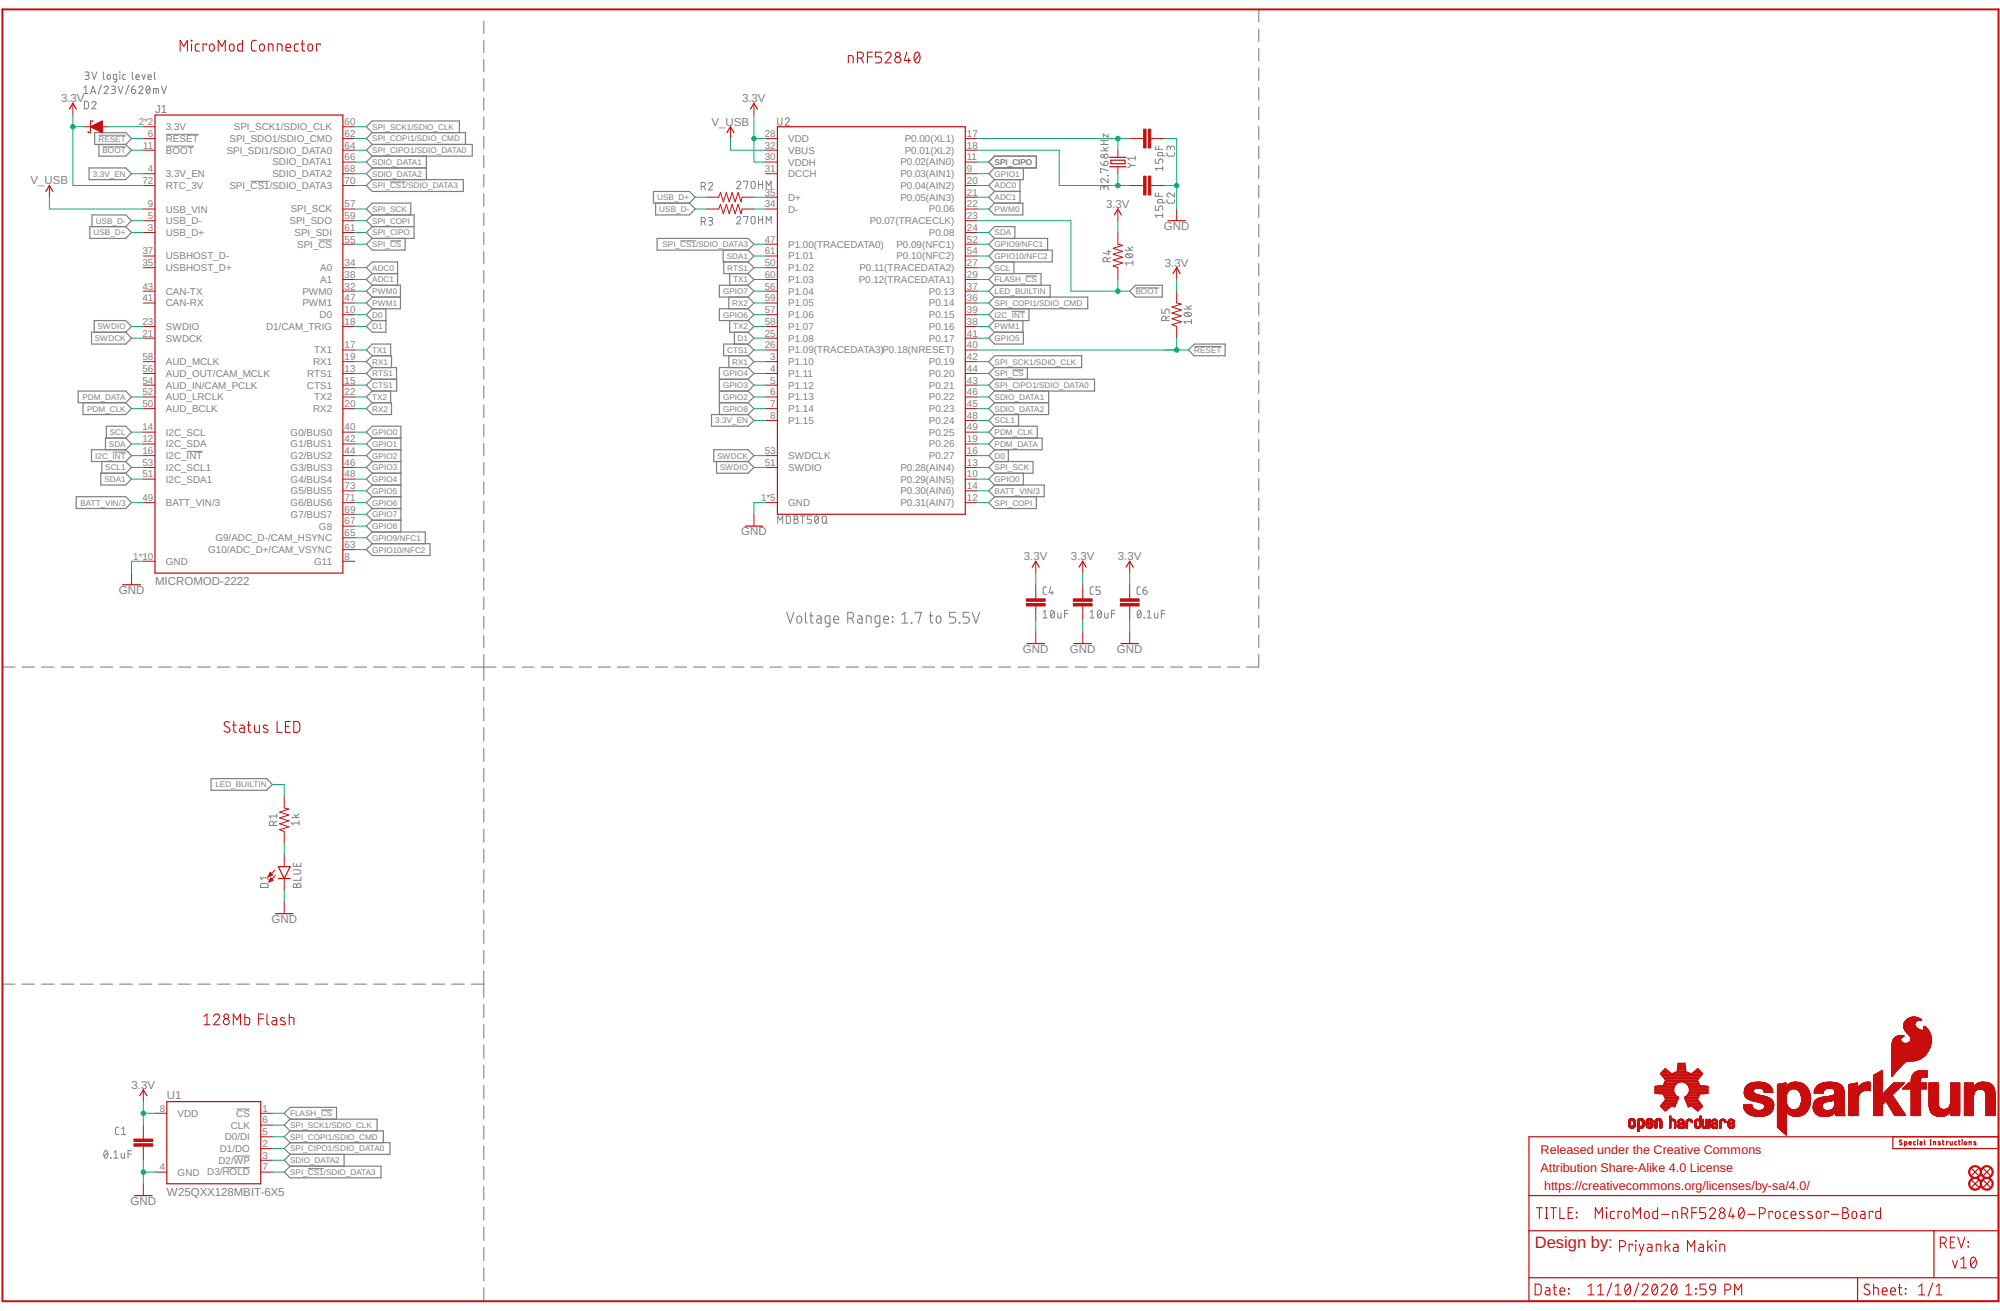
[picture p129: page 1]

Released under the Creative Commons Attribution Share-Alike 4.0 License

https://creativecommons.org/licenses/by-sa/4.0/ Design by:
