TALs-Education/ZumoPi/ZumoPi_V02/old_Designs/Sensor_Array/SparkFun Line Follower Array_v10.pdf

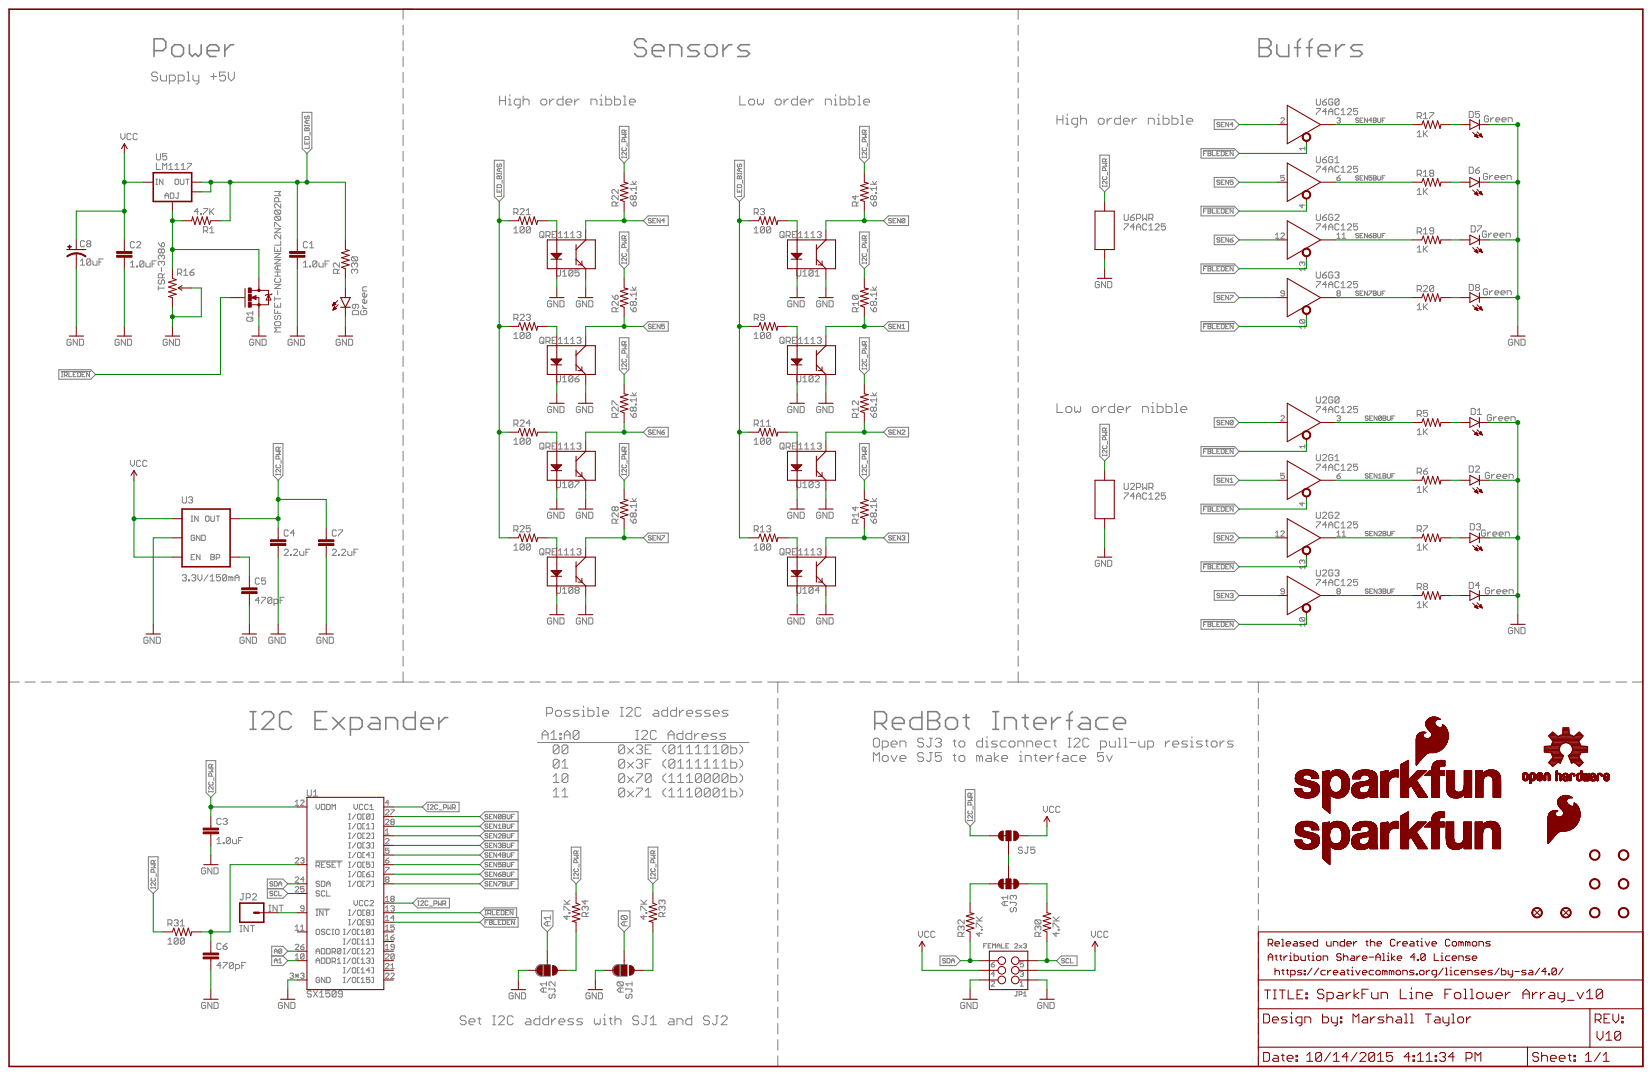
[picture p130: page 1]
