TALs-Education/ZumoPi/ZumoPi_V02/old_Designs/Research/Power_Management/Magnetic_Connector/PHR-C4777-02A-FVP-800.pdf

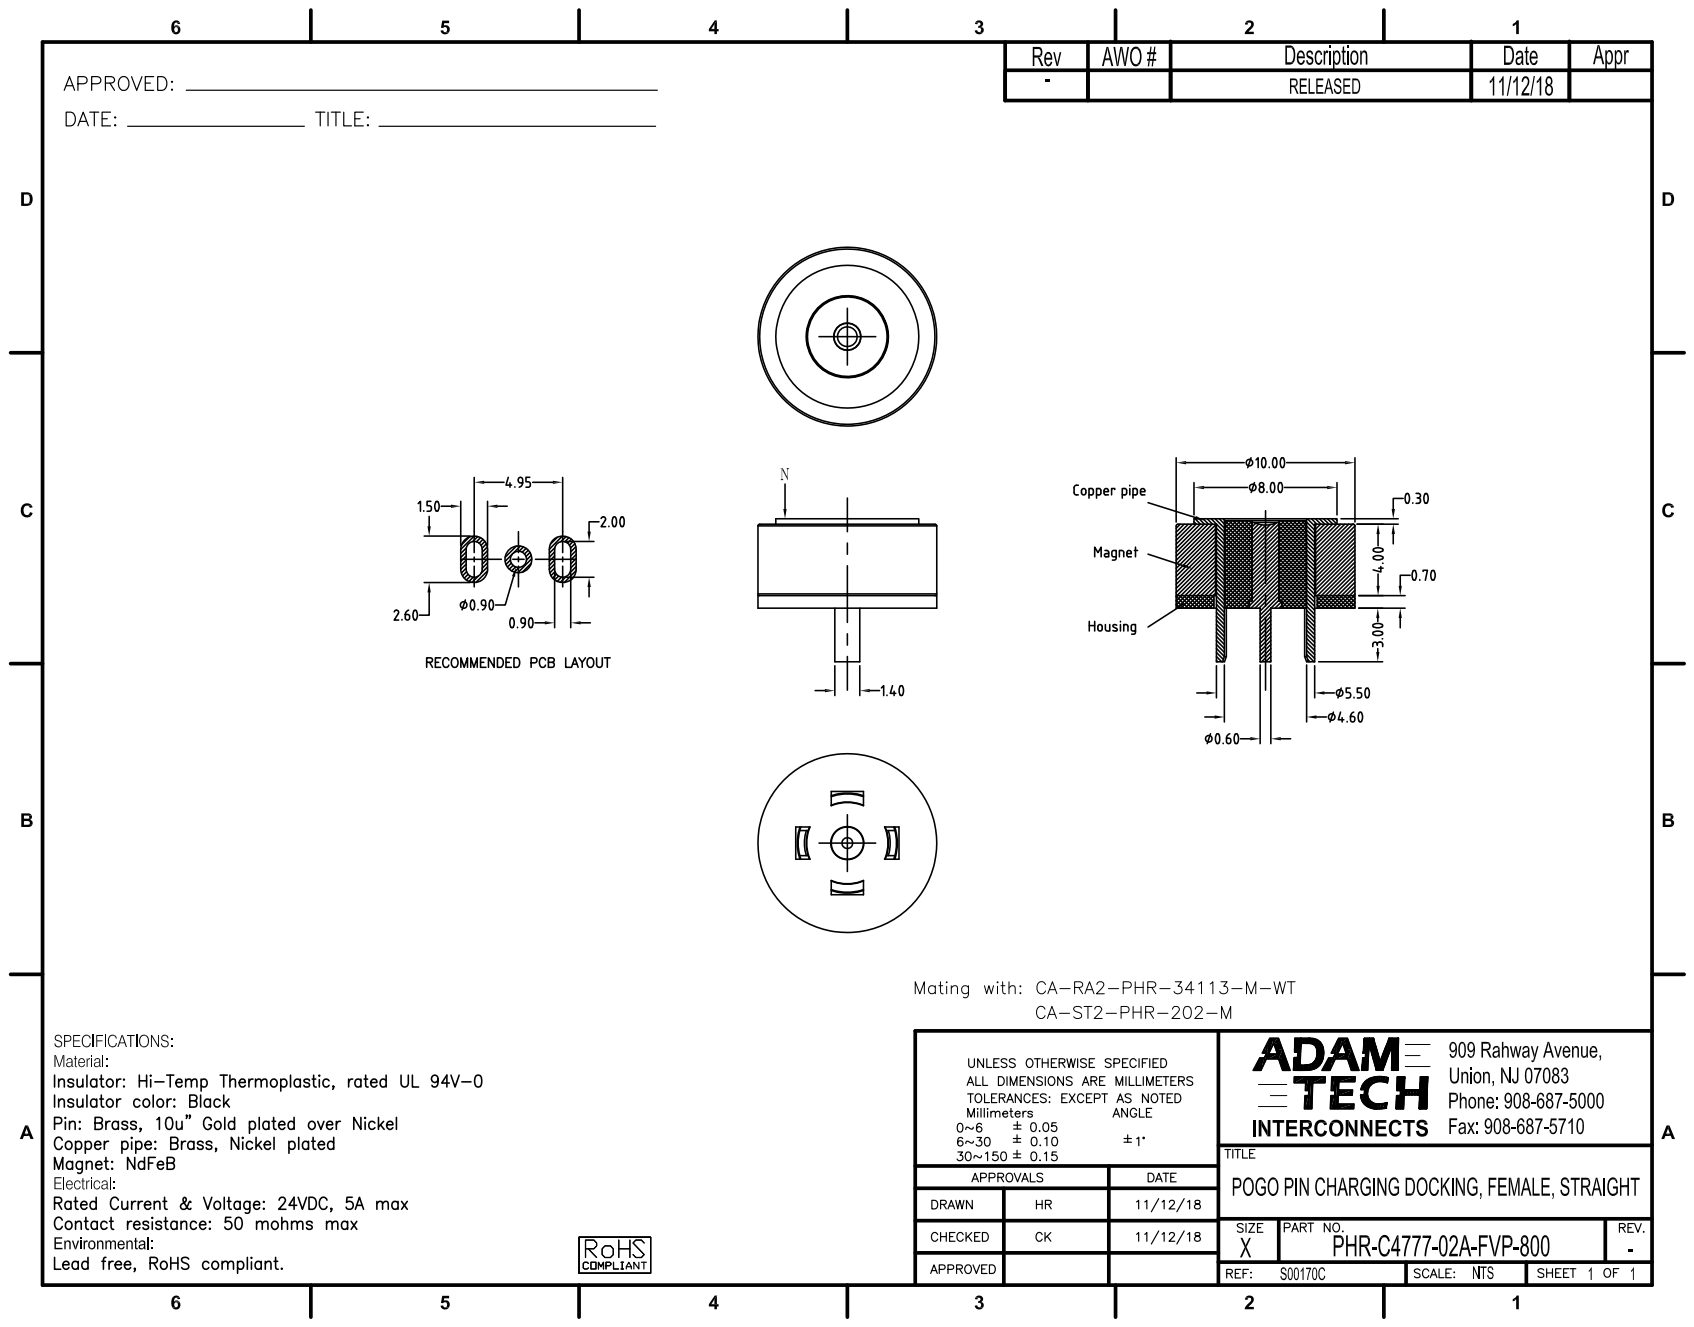
[picture p131: page 1]
