TALs-Education/ZumoPi/ZumoPi_V02/old_Designs/PCB/ref_design/Qwiic_Fuel_Gauge_-_MAX17048/Qwiic Fuel Gauge - MAX17048.brd

## EAGLE design ZumoPi_V02/old_Designs/PCB/ref_design/Qwiic_Fuel_Gauge_-_MAX17048/Qwiic Fuel Gauge - MAX17048.brd (2024-11-26, an earlier design)

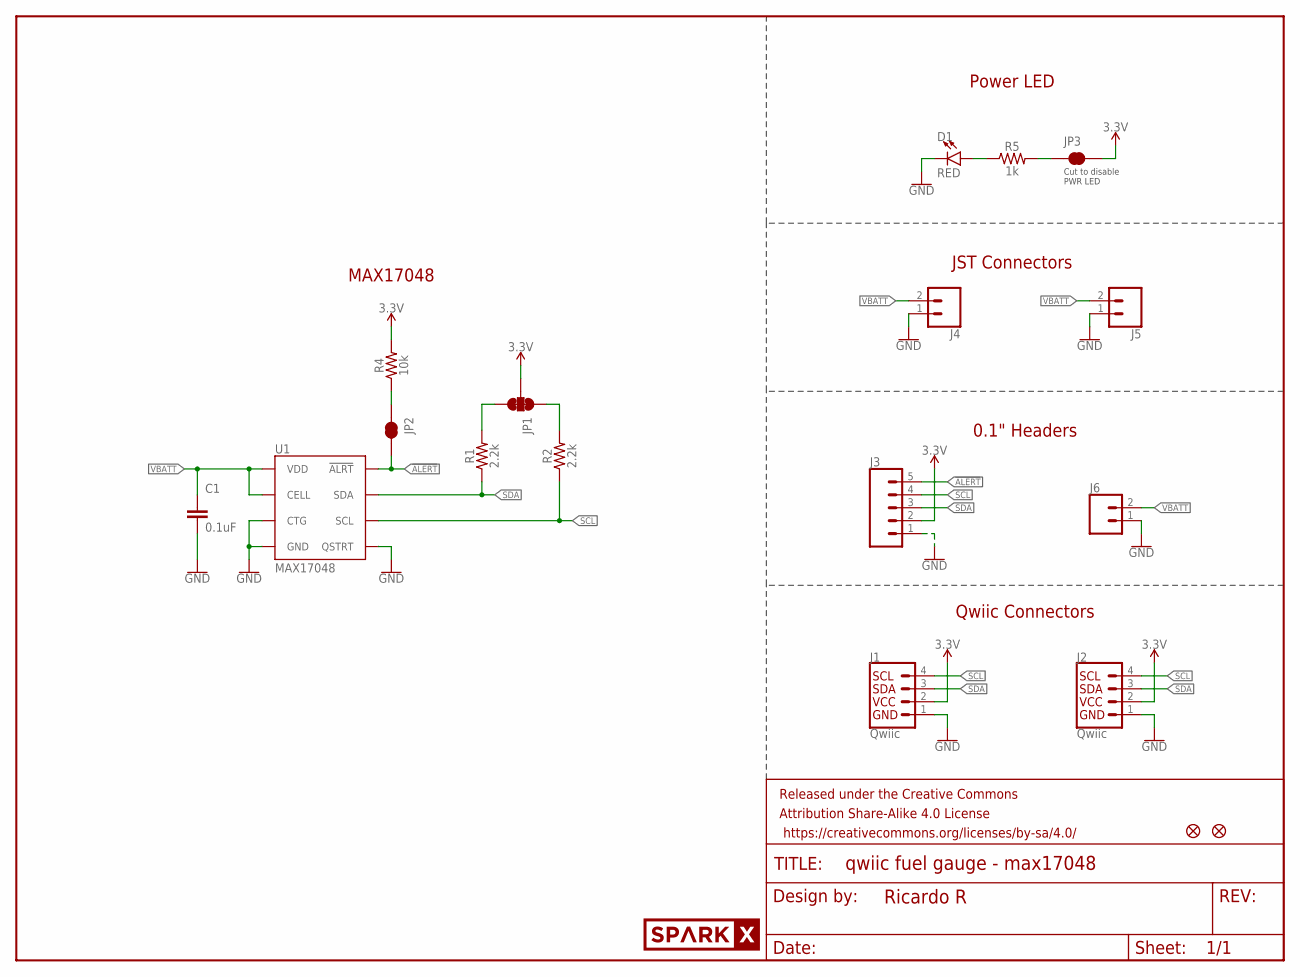
[picture p132: schematic Qwiic Fuel Gauge - MAX17048.sch]

Parts:
C1: 0.1uF; 0603
D1: RED; LED-0603
FD1, FD2: FIDUCIAL1X2; FIDUCIAL-1X2
FRAME1: FRAME-LETTERNO_PACKAGE; DUMMY
J1, J2: Qwiic; JST04_1MM_RA
J3: CONN_05NO_SILK; 1X05_NO_SILK
J4, J5: CONN_02-JST-2MM-SMT; JST-2-SMD
J6: CONN_021X02_NO_SILK; 1X02_NO_SILK
JP1: JUMPER-SMT_3_2-NC_TRACE_SILK; SMT-JUMPER_3_2-NC_TRACE_SILK
JP2, JP3: JUMPER-SMT_2_NC_TRACE_SILK; SMT-JUMPER_2_NC_TRACE_SILK
R1, R2: 2.2k; 0603
R4: 10k; 0603
R5: 1k; 0603
U1: MAX17048; DFN-8
U$30: SPARKX-LOGO4; SPARKX-MEDIUM

Connections:
3.3V: J1.2, J2.2, J3.2, JP1.2, JP3.2, R4.2
!ALERT: J3.5, JP2.2, U1.5 (!ALRT)
GND: C1.2, D1.C, J1.1, J2.1, J3.1, J4.1 (2), J5.1 (2), J6.1, U1.1 (CTG), U1.4 (GND), U1.6 (QSTRT), U1.9 (GND)
unnamed: D1.A, R5.1
unnamed: JP1.3, R1.2
unnamed: JP1.1, R2.2
unnamed: JP3.1, R5.2
unnamed: JP2.1, R4.1
SCL: J1.4, J2.4, J3.4, R2.1, U1.7 (SCL)
SDA: J1.3, J2.3, J3.3, R1.1, U1.8 (SDA)
VBATT: C1.1, J4.2 (1), J5.2 (1), J6.2, U1.2 (CELL), U1.3 (VDD)

Notes on the sheet:
Qwiic Connectors
Cut to disable PWR LED
0.1" Headers
JST Connectors
Power LED
MAX17048

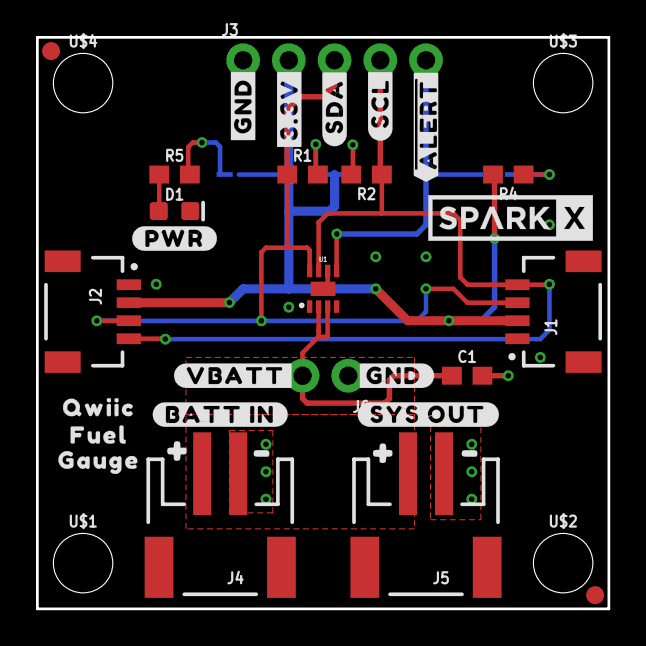
[picture p133: board Qwiic Fuel Gauge - MAX17048.brd from above]

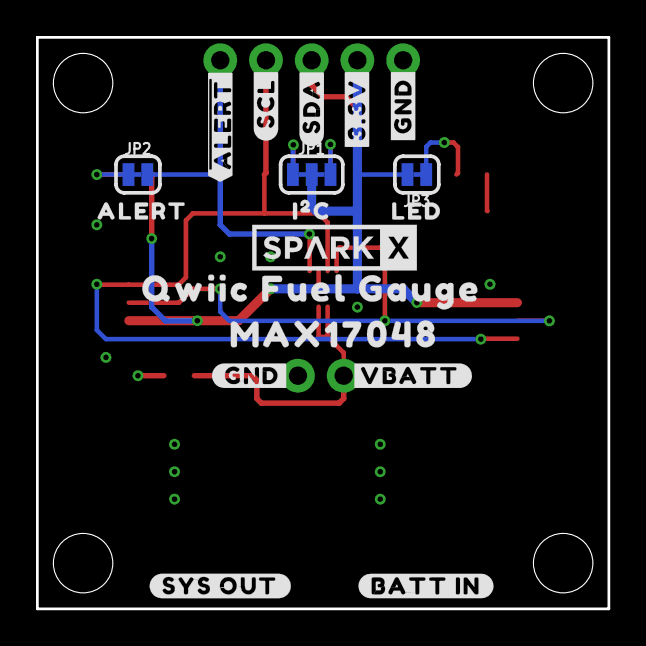
[picture p134: board Qwiic Fuel Gauge - MAX17048.brd from below]

Board: 2 copper layers, 31.8 x 31.8 mm, 56 parts (18 on the bottom side), 11 nets.

Other parts of the board:
U$1, U$2, U$3, U$4: STAND-OFF
U$5, U$16: ##ALERT##6
U$6, U$17: #SCL#5
U$7, U$22: #SDA#4
U$8, U$14: #3#3V#1
U$9, U$15: #GND#0
U$10, U$20: #BATT_IN#8
U$11, U$37: #SYS_OUT#0
U$12: #VBATT#10
U$13: #GND#7
U$18: #GND#1708416
U$19: #VBATT#1708415
U$21: SPARKX-LOGO4; SPARKX-MEDIUM
U$23: MAX170481
U$24: FUEL1
U$25: ALERT1708413
U$26: #PWR#1708412
U$27: QWIIC_FUEL_GAUGE0
U$28: I�C0
U$29: LED1
U$31: GAUGE2
U$32: QWIIC0
U$33, U$34: #0
U$35, U$36: #1
