TALs-Education/ZumoPi/ZumoPi_V02/old_Designs/PCB/ref_design/VL6180_Sensor_v10/VL6180_Sensor_v10.brd

## EAGLE design ZumoPi_V02/old_Designs/PCB/ref_design/VL6180_Sensor_v10/VL6180_Sensor_v10.brd (2024-11-26, an earlier design)

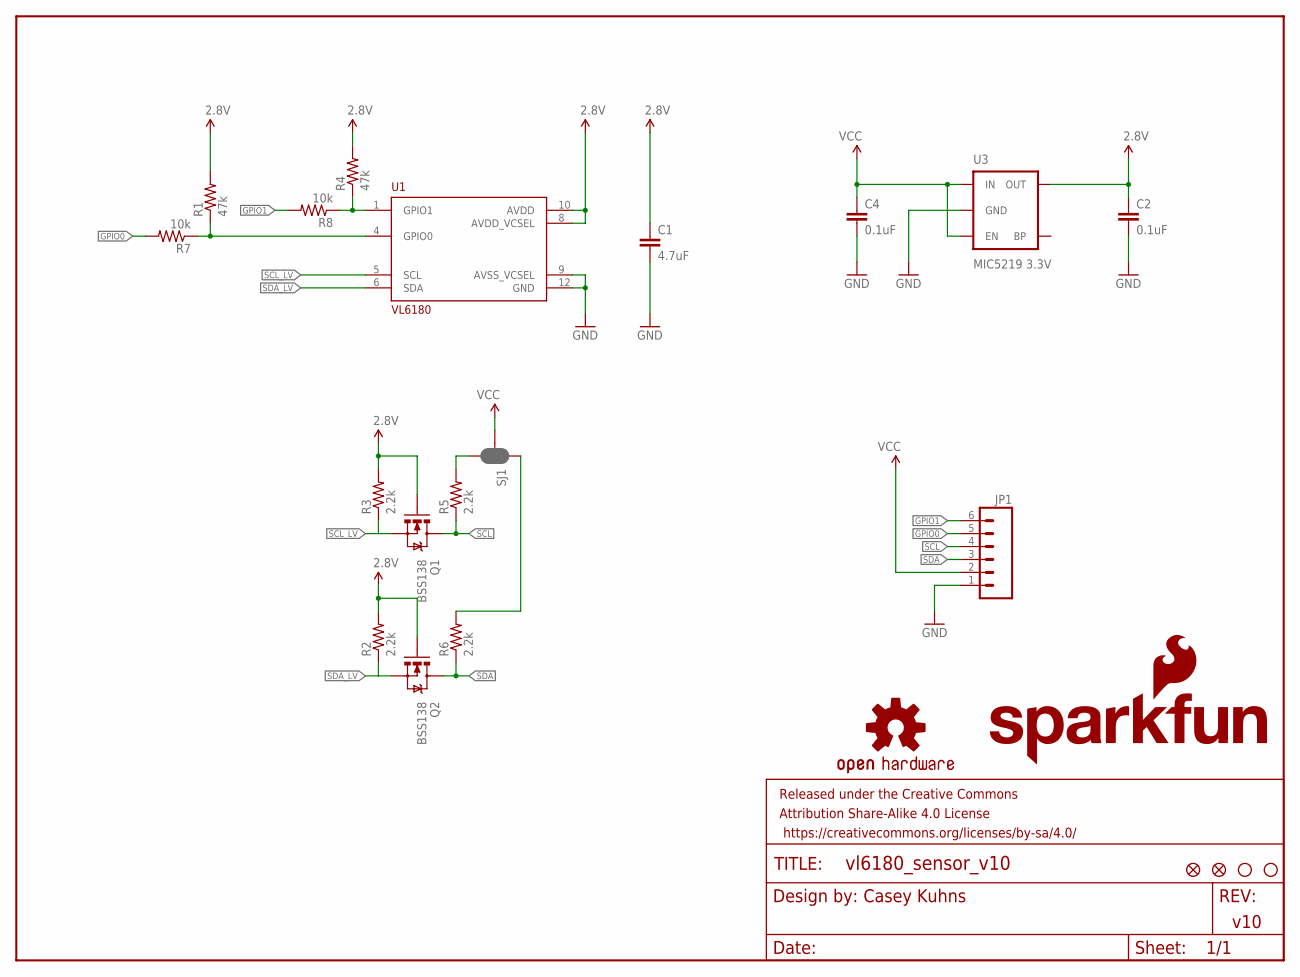
[picture p135: schematic VL6180_Sensor_v10.sch]

Parts:
C1: 4.7uF; 0603-CAP
C2, C4: 0.1uF; 0603-CAP
FID1, FID2: FIDUCIAL1X2; FIDUCIAL-1X2
FRAME1: FRAME-LETTER; CREATIVE_COMMONS
JP1: M06SIP; 1X06
LOGO1: SFE_LOGO_NAME_FLAME.1_INCH; SFE_LOGO_NAME_FLAME_.1
LOGO2: OSHW-LOGOS; OSHW-LOGO-S
Q1, Q2: BSS138; SOT23
R1, R4: 47k; 0603-RES
R2, R3, R5, R6: 2.2k; 0603-RES
R7, R8: 10k; 0603-RES
SJ1: JUMPER-PAD-3-NC_BY_PASTE; PAD-JUMPER-3-NC_BY_PASTE_YES_SILK_FULL_BOX
STANDOFF1, STANDOFF2: STAND-OFF
U1: VL6180
U3: MIC5219 3.3V; SOT23-5

Connections:
2.8V: C1.1, C2.1, Q1.1 (G), Q2.1 (G), R1.2, R2.2, R3.2, R4.2, U1.8 (AVDD_VCSEL), U1.10 (AVDD), U3.5 (OUT)
GND: C1.2, C2.2, C4.2, JP1.1, U1.9 (AVSS_VCSEL), U1.12 (GND), U3.2 (GND)
GPIO0: JP1.5, R7.2
GPIO1: JP1.6, R8.2
unnamed: R6.2, SJ1.1
unnamed: R5.2, SJ1.3
unnamed: R1.1, R7.1, U1.4 (GPIO0)
unnamed: R4.1, R8.1, U1.1 (GPIO1)
SCL: JP1.4, Q1.3 (D), R5.1
SCL_LV: Q1.2 (S), R3.1, U1.5 (SCL)
SDA: JP1.3, Q2.3 (D), R6.1
SDA_LV: Q2.2 (S), R2.1, U1.6 (SDA)
VCC: C4.1, JP1.2, SJ1.2, U3.1 (IN), U3.3 (EN)

Notes on the sheet:
Casey Kuhns
v10

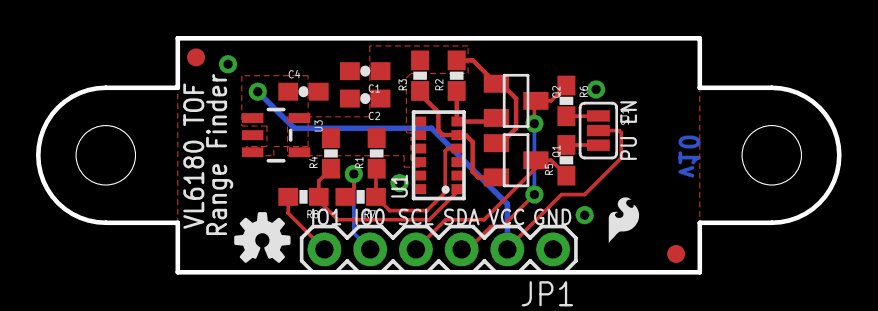
[picture p136: board VL6180_Sensor_v10.brd from above]

Board: 2 copper layers, 44.5 x 13.0 mm, 25 parts (1 on the bottom side), 13 nets.

Other parts of the board:
U$2: SFE_LOGO_FLAME_.1
