TALs-Education/ZumoPi/ZumoPi_V02/old_Designs/PCB/ref_design/Qwiic_Multi_Distance_Sensor_-_VL53L3CX/Qwiic Multi Distance Sensor - VL53L3CX.brd

## EAGLE design ZumoPi_V02/old_Designs/PCB/ref_design/Qwiic_Multi_Distance_Sensor_-_VL53L3CX/Qwiic Multi Distance Sensor - VL53L3CX.brd (2024-11-26, an earlier design)

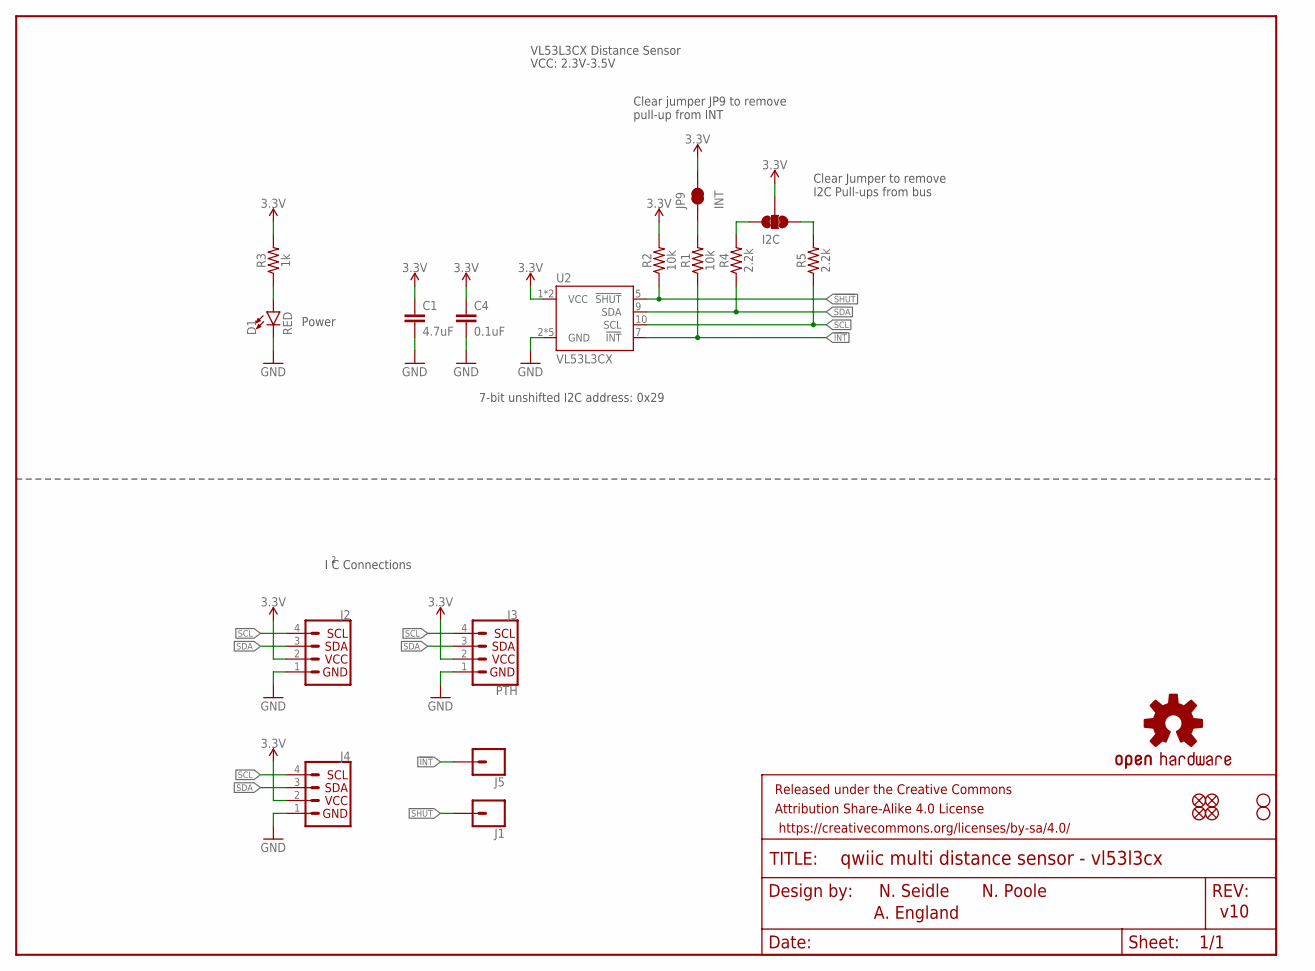
[picture p137: schematic Qwiic Multi Distance Sensor - VL53L3CX.sch]

Parts:
C1: 4.7uF; 0603
C4: 0.1uF; 0603
D1: RED; LED-0603
FRAME1: FRAME-LETTERNO_PACKAGE; DUMMY
I2C: JUMPER-SMT_3_2-NC_TRACE_SILK; SMT-JUMPER_3_2-NC_TRACE_SILK
J1, J5: CONN_01PTH_NO_SILK_YES_STOP; 1X01_NO_SILK
J2, J4: QWIIC_CONNECTORJS-1MM; 1X04_1MM_RA
J3: PTH; 1X04_NO_SILK
JP1, JP2, JP5, JP6: FIDUCIALUFIDUCIAL; MICRO-FIDUCIAL
JP3, JP4: STAND-OFF
JP9: INT; PAD-JUMPER-2-NC_BY_TRACE_YES_SILK
LOGO1: OSHW-LOGOMINI; OSHW-LOGO-MINI
R1, R2: 10k; 0603
R3: 1k; 0603
R4, R5: 2.2k; 0603
U2: VL53L3CX; VL53L1X

Connections:
3.3V: C1.1, C4.1, I2C.2, J2.2, J3.2 (VCC), J4.2, JP9.2, R2.2, R3.2, U2.1 (VCC), U2.11 (VCC)
!INT: J5.1, R1.1, U2.7 (!INT)
!SHUT: J1.1, R2.1, U2.5 (!SHUT)
GND: C1.2, C4.2, D1.C, J2.1, J3.1 (GND), J4.1, U2.2 (GND), U2.3 (GND), U2.4 (GND), U2.6 (GND), U2.12 (GND)
unnamed: I2C.1, R5.2
unnamed: I2C.3, R4.2
unnamed: D1.A, R3.1
unnamed: JP9.1, R1.2
SCL: J2.4, J3.4 (SCL), J4.4, R5.1, U2.10 (SCL)
SDA: J2.3, J3.3 (SDA), J4.3, R4.1, U2.9 (SDA)

Notes on the sheet:
N. Seidle
v10
7-bit unshifted I2C address: 0x29
Clear Jumper to remove I2C Pull-ups from bus
Clear jumper JP9 to remove pull-up from INT
Power
A. England
I C Connections
VL53L3CX Distance Sensor
VCC: 2.3V-3.5V
N. Poole

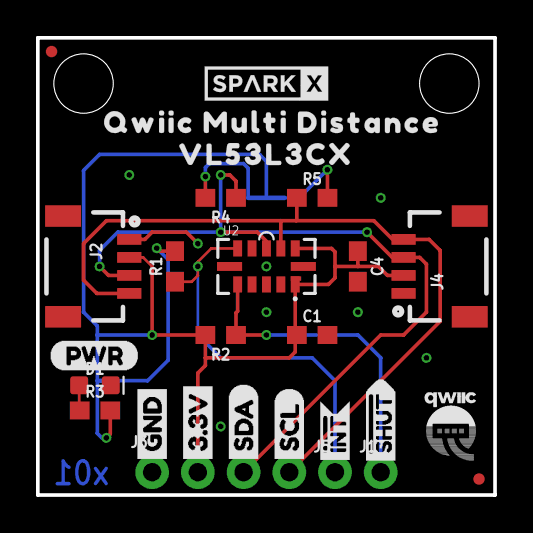
[picture p138: board Qwiic Multi Distance Sensor - VL53L3CX.brd from above]

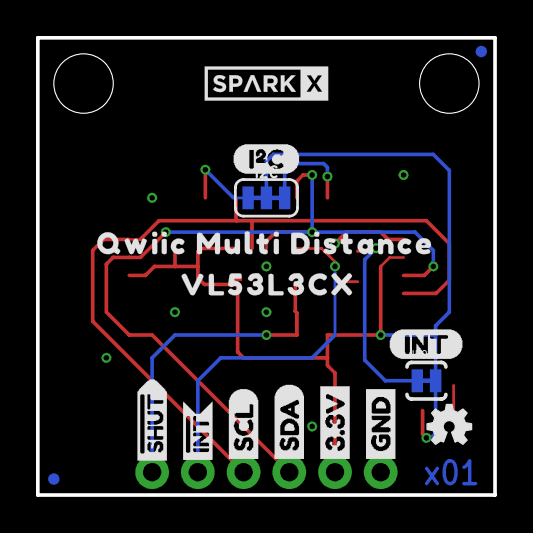
[picture p139: board Qwiic Multi Distance Sensor - VL53L3CX.brd from below]

Board: 2 copper layers, 25.4 x 25.4 mm, 46 parts (16 on the bottom side), 10 nets.

Other parts of the board:
U$1, U$16: VL53L3CX0
U$2, U$15: QWIIC_MULTI_DISTANCE1
U$3, U$22: GND1
U$4, U$21: 3#3V2
U$5, U$27: SDA8
U$6, U$26: SCL9
U$7, U$14: INT#-[<
U$8, U$9: #SHUT15
U$10: (PWR)
U$11: (I_SUPER2_C)
U$12: (INT)
U$13: QWIIC-LOGO-SMALL
U$17, U$18: SPARKX-SMALL
