TALs-Education/ZumoPi/ZumoPi_V02/old_Designs/PCB/ref_design/MicroMod_ATP_CarrierBoard/MicroMod_ATP_CarrierBoard.brd

## EAGLE design ZumoPi_V02/old_Designs/PCB/ref_design/MicroMod_ATP_CarrierBoard/MicroMod_ATP_CarrierBoard.brd (2024-11-26, an earlier design)

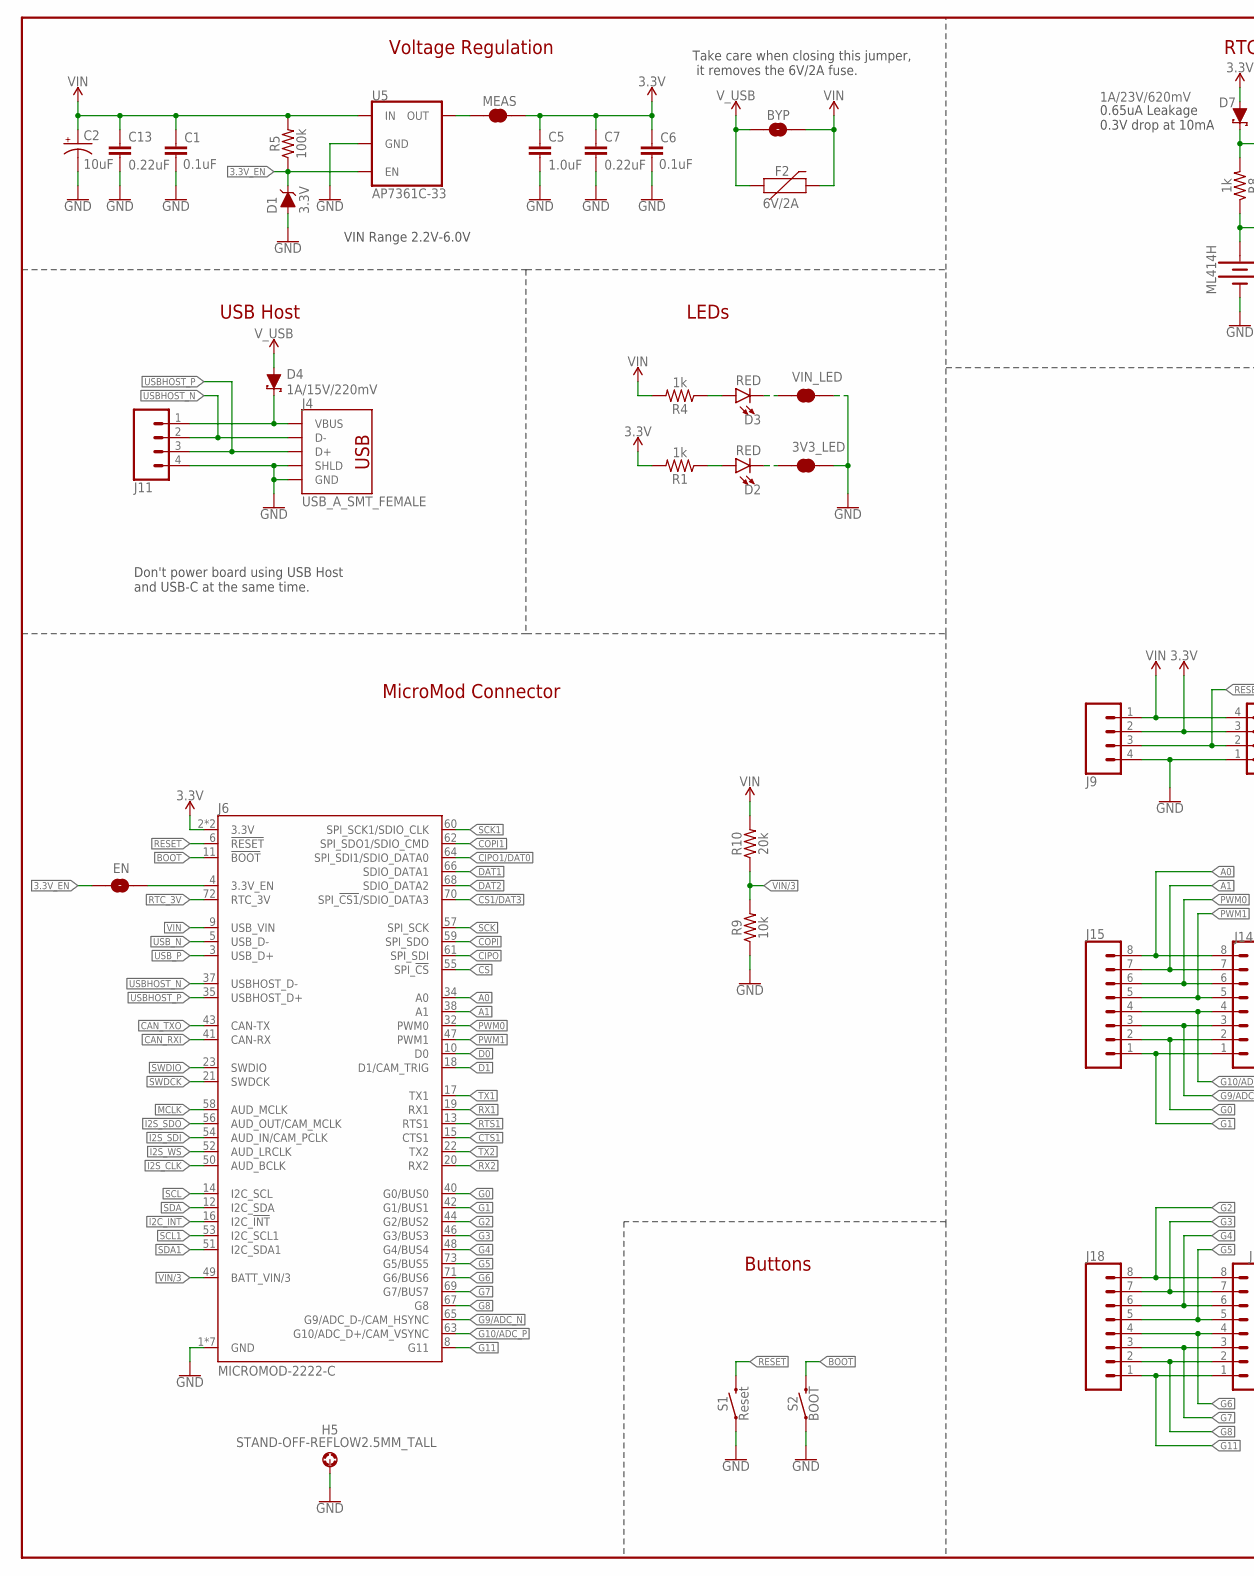
[picture p140: schematic MicroMod_ATP_CarrierBoard.sch, part in row 1, column 1]

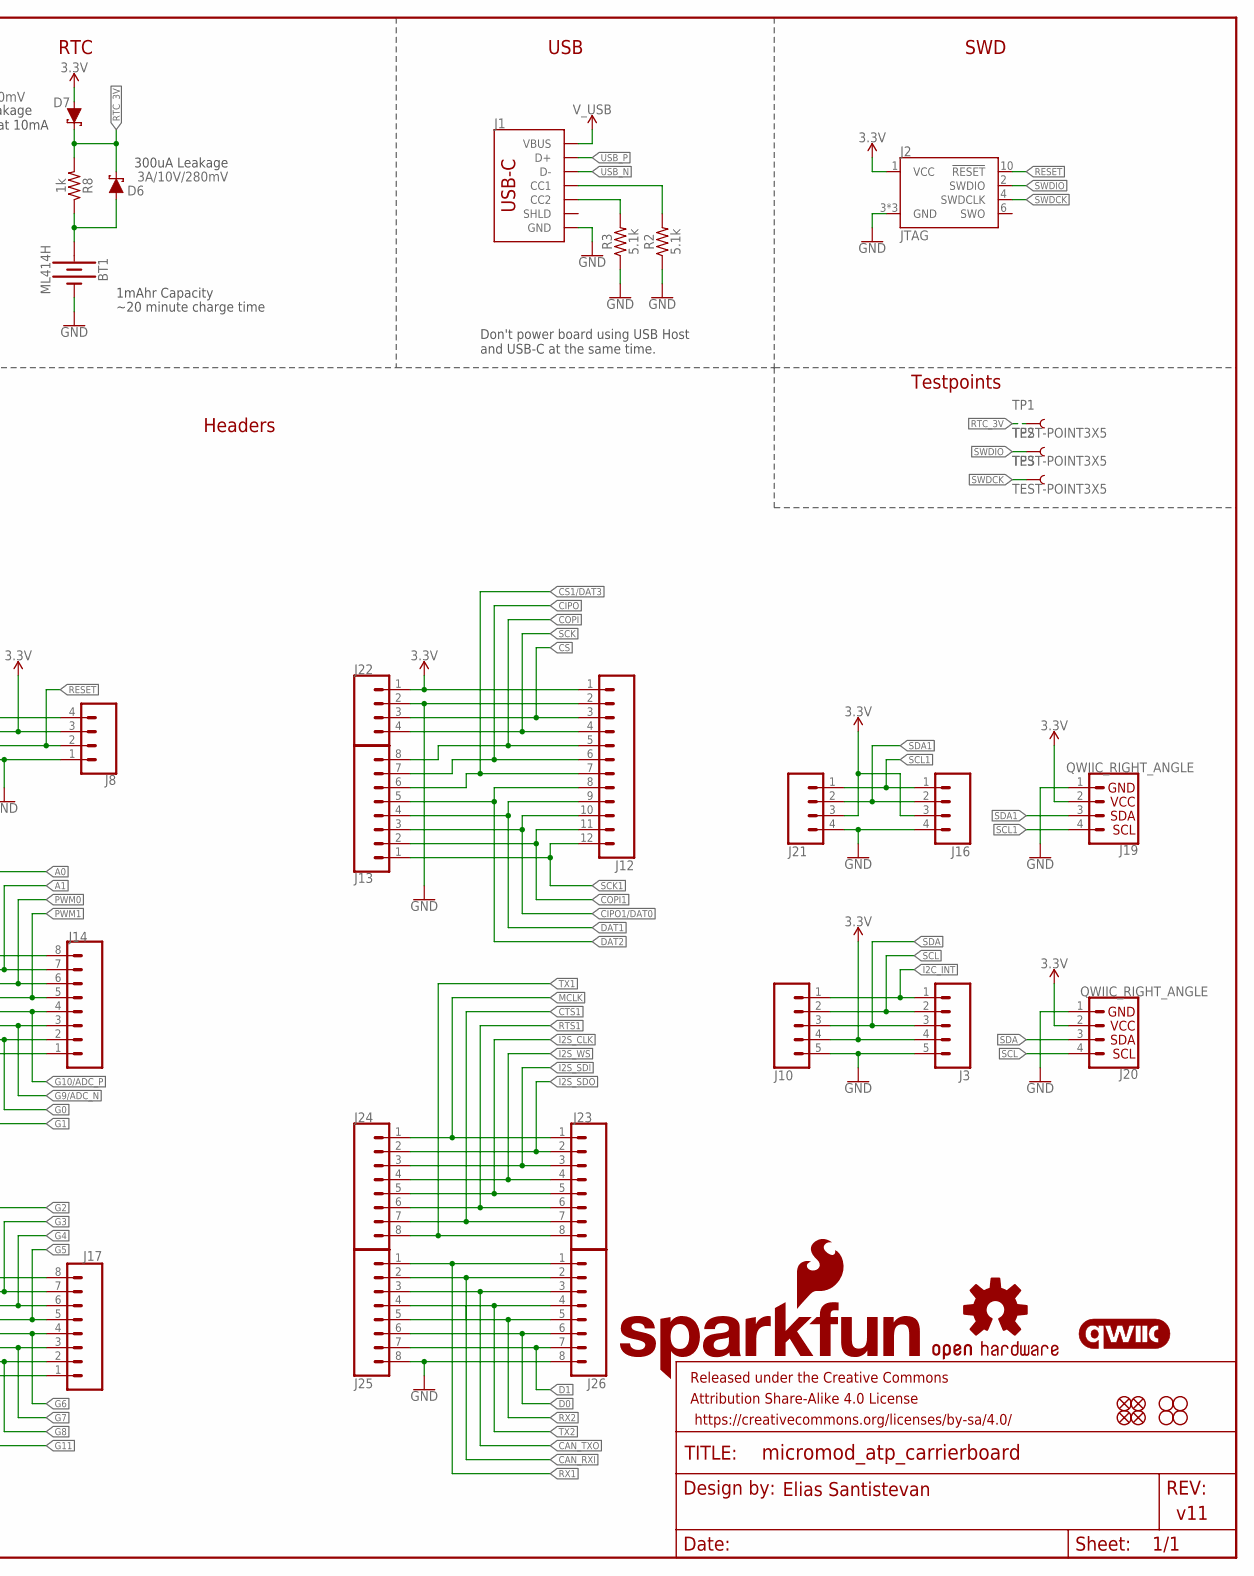
[picture p141: schematic MicroMod_ATP_CarrierBoard.sch, part in row 1, column 2]

Parts:
3V3_LED: JUMPER-SMT_2_NC_TRACE_SILK; SMT-JUMPER_2_NC_TRACE_SILK
BT1: ML414H; ML414H_IV01E
BYP: JUMPER-SMT_2_NO_SILK; SMT-JUMPER_2_NO_SILK
C1, C6: 0.1uF; 0603
C2: 10uF; EIA3216
C5: 1.0uF; 0603
C7, C13: 0.22uF; 0603
D1: 3.3V; SOD-323
D2, D3: RED; LED-0603
D4: 1A/15V/220mV; DO-214BA
D6: 3A/10V/280mV; SOD-323
D7: 1A/23V/620mV; SOD-323
EN: JUMPER-SMT_2_NO_SILK; SMT-JUMPER_2_NO_SILK
F2: 6V/2A; 1210
FD1, FD2, FD3, FD4: FIDUCIALUFIDUCIAL; FIDUCIAL-MICRO
FRAME1: FRAME-LEDGER; CREATIVE_COMMONS
H1, H2, H3, H4: STAND-OFF
H5: STAND-OFF-REFLOW2.5MM_TALL; STAND-OFF-REFLOW-M2.5
J1: USB_C_2-LAYER_PADS; USB-C-16P-2LAYER-PADS
J2: JTAG; 2X5-PTH-1.27MM
J3: CONN_05NO_SILK; 1X05_NO_SILK
J4: USB_A_SMT_FEMALE; USB-A-S-SILK-FEMALE
J6: MICROMOD-2222-C; M.2-CONNECTOR-E
J8, J21: 1X04_SMD_STRAIGHT_COMBO; 1X04_SMD_VERTICAL_COMBO
J9: CONN_041X04_NO_SILK; 1X04_NO_SILK
J10: CONN_05VERT_FEMALE_HEADER; 1X05_SMD_VERTICAL_COMBO
J11, J16, J22: CONN_041X04_NO_SILK_NO_POP; 1X04_NO_SILK
J12: CONN_12SMD_COMBINED; 1X12_SMD_COMBINED
J13: CONN_08NO_SILK_DNP; 1X08_NO_SILK
J14, J17, J24, J25: CONN_08SMD-COMBO-FEMALE; 1X08_SMD_COMBINED
J15, J18, J23, J26: CONN_08NO_SILK_FEMALE_PTH; 1X08_NO_SILK
J19, J20: QWIIC_RIGHT_ANGLE; JST04_1MM_RA
LOGO1: SFE_LOGO_NAME_FLAME.1_INCH; SFE_LOGO_NAME_FLAME_.1
LOGO2: QWIIC_LOGO_5MM; QWIIC_5MM
LOGO3: OSHW-LOGOMINI; OSHW-LOGO-MINI
MEAS: JUMPER-COMBO_2_NC_TRACE; COMBO-JUMPER_2_NC_TRACE
R1, R4, R8: 1k; 0603
R2, R3: 5.1k; 0603
R5: 100k; 0603
R9: 10k; 0603
R10: 20k; 0603
S1: Reset; TACTILE_SWITCH_SMD_5.2MM
S2: BOOT; TACTILE_SWITCH_SMD_5.2MM
TP1, TP2, TP3: TEST-POINT3X5; PAD.03X.05
U5: AP7361C-33; UDFN-8
VIN_LED: JUMPER-SMT_2_NC_TRACE_SILK; SMT-JUMPER_2_NC_TRACE_SILK

Connections:
3.3V: C5.1, C6.1, C7.1, D7.A, J2.1 (VCC), J3.4, J6.2 (3.3V), J6.74 (3.3V), J8.3, J9.2, J10.4, J12.1, J16.3, J19.2, J20.2, J21.3, J22.1, MEAS.2, MEAS.4 (2), R1.2
3.3V_EN: D1.C, EN.1, R5.1, U5.5 (EN)
!BOOT!: J6.11 (!BOOT!), S2.3 (2), S2.4 (2)
!CS1!/DAT3: J6.70 (SPI_!CS1!/SDIO_DATA3), J12.7, J13.6
!CS!: J6.55 (SPI_!CS!), J12.3, J22.3
!RESET: J2.10 (!RESET), J6.6 (!RESET!), J8.2, J9.3, S1.3 (2), S1.4 (2)
A0: J6.34 (A0), J14.8, J15.8
A1: J6.38 (A1), J14.7, J15.7
CAN_RXI: J6.41 (CAN-RX), J25.2, J26.2
CAN_TXO: J6.43 (CAN-TX), J25.3, J26.3
CIPO: J6.61 (SPI_SDI), J12.6, J13.7
CIPO1/DAT0: J6.64 (SPI_SDI1/SDIO_DATA0), J12.10, J13.3
COPI: J6.59 (SPI_SDO), J12.5, J13.8
COPI1: J6.62 (SPI_SDO1/SDIO_CMD), J12.11, J13.2
CTS1: J6.15 (CTS1), J23.7, J24.7
D0: J6.10 (D0), J25.6, J26.6
D1: J6.18 (D1/CAM_TRIG), J25.7, J26.7
DAT1: J6.66 (SDIO_DATA1), J12.9, J13.4
DAT2: J6.68 (SDIO_DATA2), J12.8, J13.5
G0: J6.40 (G0/BUS0), J14.2, J15.2
G1: J6.42 (G1/BUS1), J14.1, J15.1
G2: J6.44 (G2/BUS2), J17.8, J18.8
G3: J6.46 (G3/BUS3), J17.7, J18.7
G4: J6.48 (G4/BUS4), J17.6, J18.6
G5: J6.73 (G5/BUS5), J17.5, J18.5
G6: J6.71 (G6/BUS6), J17.4, J18.4
G7: J6.69 (G7/BUS7), J17.3, J18.3
G8: J6.67 (G8), J17.2, J18.2
G9/ADC_N: J6.65 (G9/ADC_D-/CAM_HSYNC), J14.3, J15.3
G10/ADC_P: J6.63 (G10/ADC_D+/CAM_VSYNC), J14.4, J15.4
G11: J6.8 (G11), J17.1, J18.1
GND: 3V3_LED.2, BT1.-, C1.2, C2.-, C5.2, C6.2, C7.2, C13.2, D1.A, H5.1, J1.GND, J1.GND2 (GND), J2.3 (GND), J2.5 (GND), J2.9 (GND), J3.5, J4.GND, J4.SHLD1 (SHLD), J4.SHLD2 (SHLD), J6.1 (GND), J6.7 (GND), J6.33 (GND), J6.36 (GND), J6.39 (GND), J6.45 (GND), J6.75 (GND), J8.1, J9.4, J10.5, J11.4, J12.2, J16.4, J19.1, J20.1, J21.4, J22.2, J25.8, J26.8, R2.1, R3.1, R9.1, S1.1, S1.2 (1), S2.1, S2.2 (1), U5.4 (GND), U5.EP (GND), VIN_LED.2
I2C_!INT: J3.1, J6.16 (I2C_!INT!), J10.1
I2S_CLK: J6.50 (AUD_BCLK), J23.5, J24.5
I2S_SDI: J6.54 (AUD_IN/CAM_PCLK), J23.3, J24.3
I2S_SDO: J6.56 (AUD_OUT/CAM_MCLK), J23.2, J24.2
I2S_WS: J6.52 (AUD_LRCLK), J23.4, J24.4
MCLK: J6.58 (AUD_MCLK), J23.1, J24.1
unnamed: D2.A, R1.1
unnamed: D3.A, R4.1
unnamed: 3V3_LED.1, D2.C
unnamed: D3.C, VIN_LED.1
unnamed: EN.2, J6.4 (3.3V_EN)
unnamed: D4.C, J4.VBUS, J11.1
unnamed: J1.A5 (CC1), R2.2
unnamed: J1.B5 (CC2), R3.2
unnamed: BT1.+, D6.A, R8.1
OUT_MEAS: MEAS.1, MEAS.3 (1), U5.1 (OUT)
PWM0: J6.32 (PWM0), J14.6, J15.6
PWM1: J6.47 (PWM1), J14.5, J15.5
RTC_3V: D6.C, D7.C, J6.72 (RTC_3V), R8.2, TP1.P$1
RTS1: J6.13 (RTS1), J23.6, J24.6
RX1: J6.19 (RX1), J25.1, J26.1
RX2: J6.20 (RX2), J25.5, J26.5
SCK: J6.57 (SPI_SCK), J12.4, J22.4
SCK1: J6.60 (SPI_SCK1/SDIO_CLK), J12.12, J13.1
SCL: J3.2, J6.14 (I2C_SCL), J10.2, J20.4
SCL1: J6.53 (I2C_SCL1), J16.1, J19.4, J21.1
SDA: J3.3, J6.12 (I2C_SDA), J10.3, J20.3
SDA1: J6.51 (I2C_SDA1), J16.2, J19.3, J21.2
SWDCK: J2.4 (SWDCLK), J6.21 (SWDCK), TP3.P$1
SWDIO: J2.2 (SWDIO), J6.23 (SWDIO), TP2.P$1
TX1: J6.17 (TX1), J23.8, J24.8
TX2: J6.22 (TX2), J25.4, J26.4
USBHOST_N: J4.D-, J6.37 (USBHOST_D-), J11.2
USBHOST_P: J4.D+, J6.35 (USBHOST_D+), J11.3
USB_N: J1.A7 (D-), J1.B7 (D-), J6.5 (USB_D-)
USB_P: J1.A6 (D+), J1.B6 (D+), J6.3 (USB_D+)
VIN: BYP.2, C1.1, C2.+, C13.1, F2.2, J6.9 (USB_VIN), J8.4, J9.1, R4.2, R5.2, R10.2, U5.8 (IN)
VIN/3: J6.49 (BATT_VIN/3), R9.2, R10.1
V_USB: BYP.1, D4.A, F2.1, J1.VBUS1 (VBUS), J1.VBUS2 (VBUS)

Notes on the sheet:
300uA Leakage
0.65uA Leakage 0.3V drop at 10mA
~20 minute charge time
1mAhr Capacity
Take care when closing this jumper, it removes the 6V/2A fuse.
SWD
USB
Headers
RTC
Voltage Regulation
MicroMod Connector
Elias Santistevan
LEDs
USB Host
Buttons
v11
VIN Range 2.2V-6.0V
Don't power board using USB Host and USB-C at the same time.
Testpoints

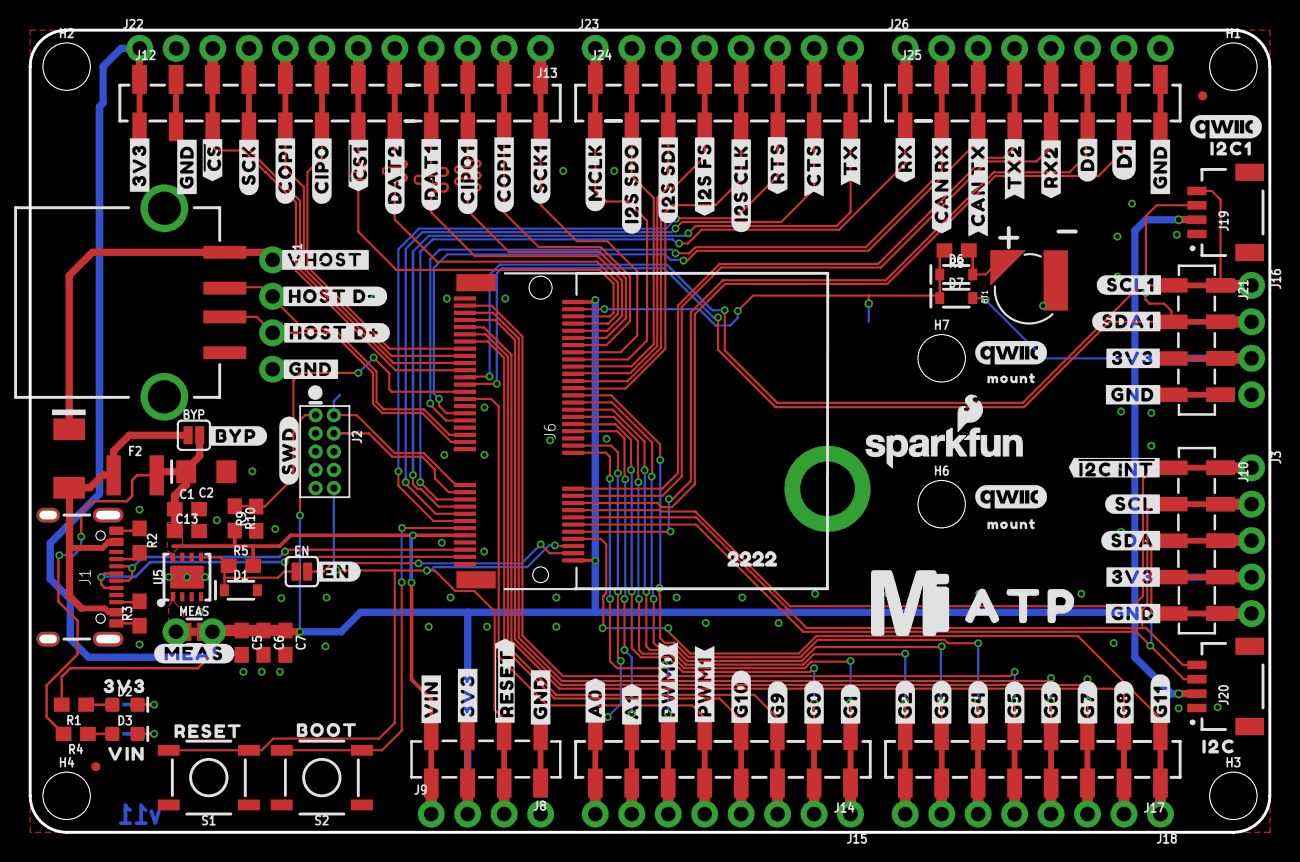
[picture p142: board MicroMod_ATP_CarrierBoard.brd from above]

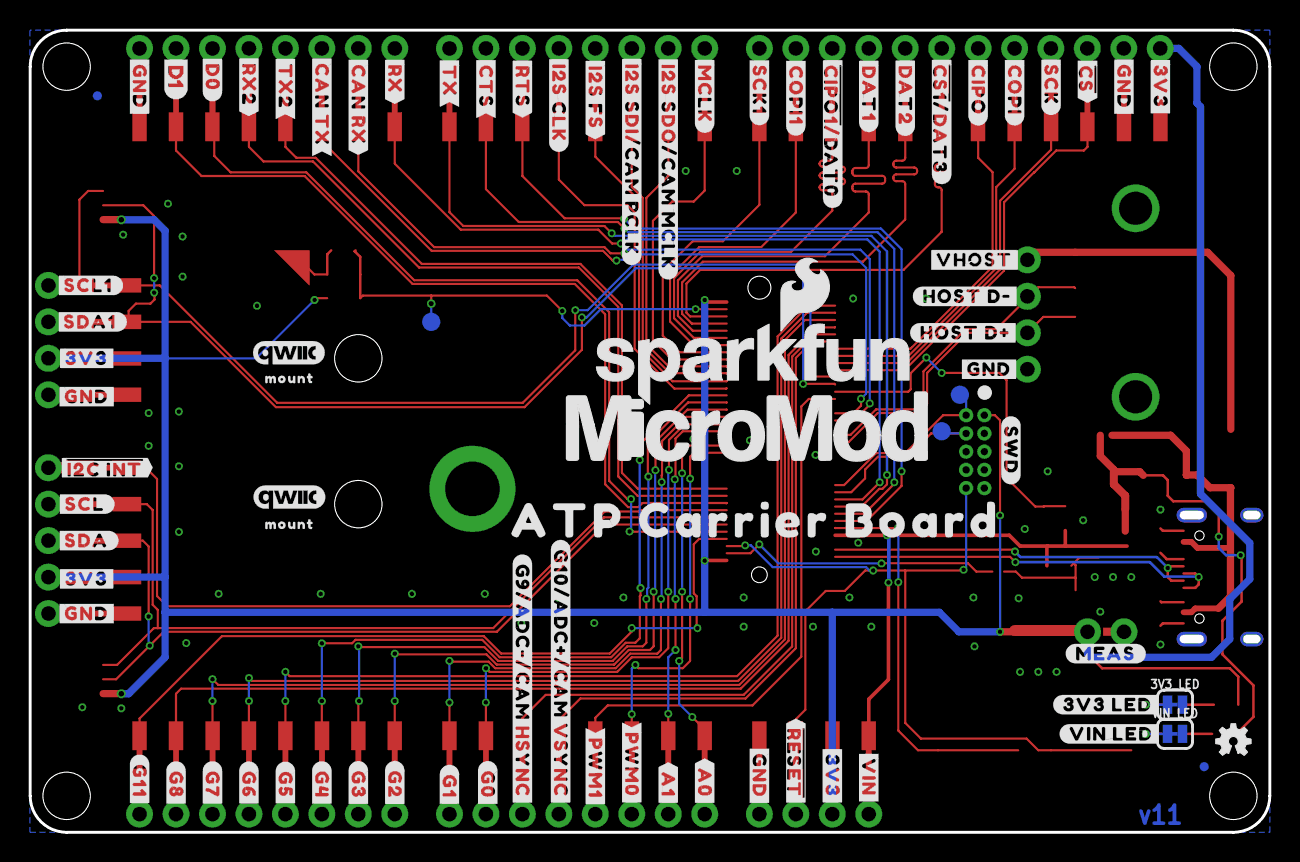
[picture p143: board MicroMod_ATP_CarrierBoard.brd from below]

Board: 2 copper layers, 86.4 x 55.9 mm, 222 parts (80 on the bottom side), 71 nets.

Other parts of the board:
H6, H7: STAND-OFF
LOGO4: SFE_LOGO_NAME_FLAME.2_INCH; SFE_LOGO_NAME_FLAME_.2
LOGO5, LOGO6, LOGO7, LOGO8: QWIIC_LOGO_3MM; QWIIC_5MM
U$1, U$123: #A0#10
U$2, U$124: #A1#10
U$3, U$27, U$46, U$47, U$58, U$89, U$100, U$101, U$102, U$103, U$104, U$105: #GND#0
U$4, U$120: #G0#2
U$5: #RESET10
U$6, U$98: #D0#0
U$7, U$119: #G1#2
U$8, U$118: #G2#2
U$9, U$117: #G3#3
U$10, U$116: #G4#4
U$11, U$115: #G5#5
U$12, U$114: #G6#6
U$13, U$113: #G7#7
U$14, U$112: #G8#8
U$15: #G9#9
U$16: #G10#10
U$17, U$111: #G11#10
U$18, U$121: #PWM0#10
U$19, U$122: #PWM1#10
U$20: ##CS1##5178039
U$21, U$110: ##I2C_INT##10
U$22: #CAN_RX#9
U$23, U$97: #CAN_TX#10
U$24: #CIPO#3
U$25: #COPI#2
U$26: #CTS#6
U$28: #SCK#2
U$29: #I2S_FS#5
U$30: #I2S_SDI#5
U$31: #I2S_SDO#5
U$32: #MCLK#4
U$33: #RTS#5
U$34: #RX#8
U$35: #TX#7
U$36: #DAT1#5178039
U$37, U$125: ##RESET##7
U$38, U$60, U$61, U$70, U$88, U$106, U$107, U$126: #3V3#1
U$39: #BYP#8
U$40, U$128: #HOST_D##9
U$41, U$129: #HOST_D##10
U$42, U$132: #MEAS#10
U$43: BOOT10
U$44, U$108: #SDA#4
U$45, U$127: #VIN#6
U$48: #EN#0
U$49, U$109: #SCL#5
U$50, U$146: #VHOST#0
U$51, U$131: #SWD#10
U$52: #I2S_CLK#5
U$53: #DAT2#5178039
U$54: #CIPO1#5178039
U$55: 22229
U$56: ##CIPO1##DAT0#5178038
U$57, U$75: #COPI1#2
U$59: ##CS##0
U$62: ATP0
U$63, U$76: #RX2#3
U$64, U$80: #TX2#2
U$65, U$78: #SCL1#3
U$66, U$79: #SDA1#3
U$67, U$77: #SCK1#2
U$68: VIN3
U$69: 3V34
U$71: I2C4
U$72: I2C14
U$73: ATP_CARRIER_BOARD1
U$81: ##CS##5178037
U$82: #DAT2#5
U$83: #DAT1#5
U$84: ##CS1##DAT3#5178037
U$85: #COPI#4
U$86: #SCK#4
U$87: #MCLK#6
U$90: #I2S_FS#7
U$91: #I2S_CLK#7
U$92: #RTS#7
U$93: #CTS#8
U$94: #TX#9
U$95: #RX#10
U$96: #CAN_RX#10
U$99, U$145: D10
U$133: #VIN_LED#10
U$134: #3V3_LED#10
U$135: #G9#ADC##CAM_HSYNC#9
U$136: #G10#ADC##CAM_VSYNC#10
U$137: #I2S_SDI#CAM_PCLK#7
U$138: #I2S_SDO#CAM_MCLK#7
U$139, U$141, U$142, U$143: MOUNT10
U$140: MICROMOD_MI_LOGO_1
U$144: MICROMOD_LOGO_1
U$147: #CIPO#5178038
