TALs-Education/ZumoPi/ZumoPi_V02/old_Designs/PCB/ref_design/SparkFun_Qwiic_VR_IMU_Breakout_1/SparkFun_Qwiic_VR_IMU_Breakout.brd

## EAGLE design ZumoPi_V02/old_Designs/PCB/ref_design/SparkFun_Qwiic_VR_IMU_Breakout_1/SparkFun_Qwiic_VR_IMU_Breakout.brd (2024-11-26, an earlier design)

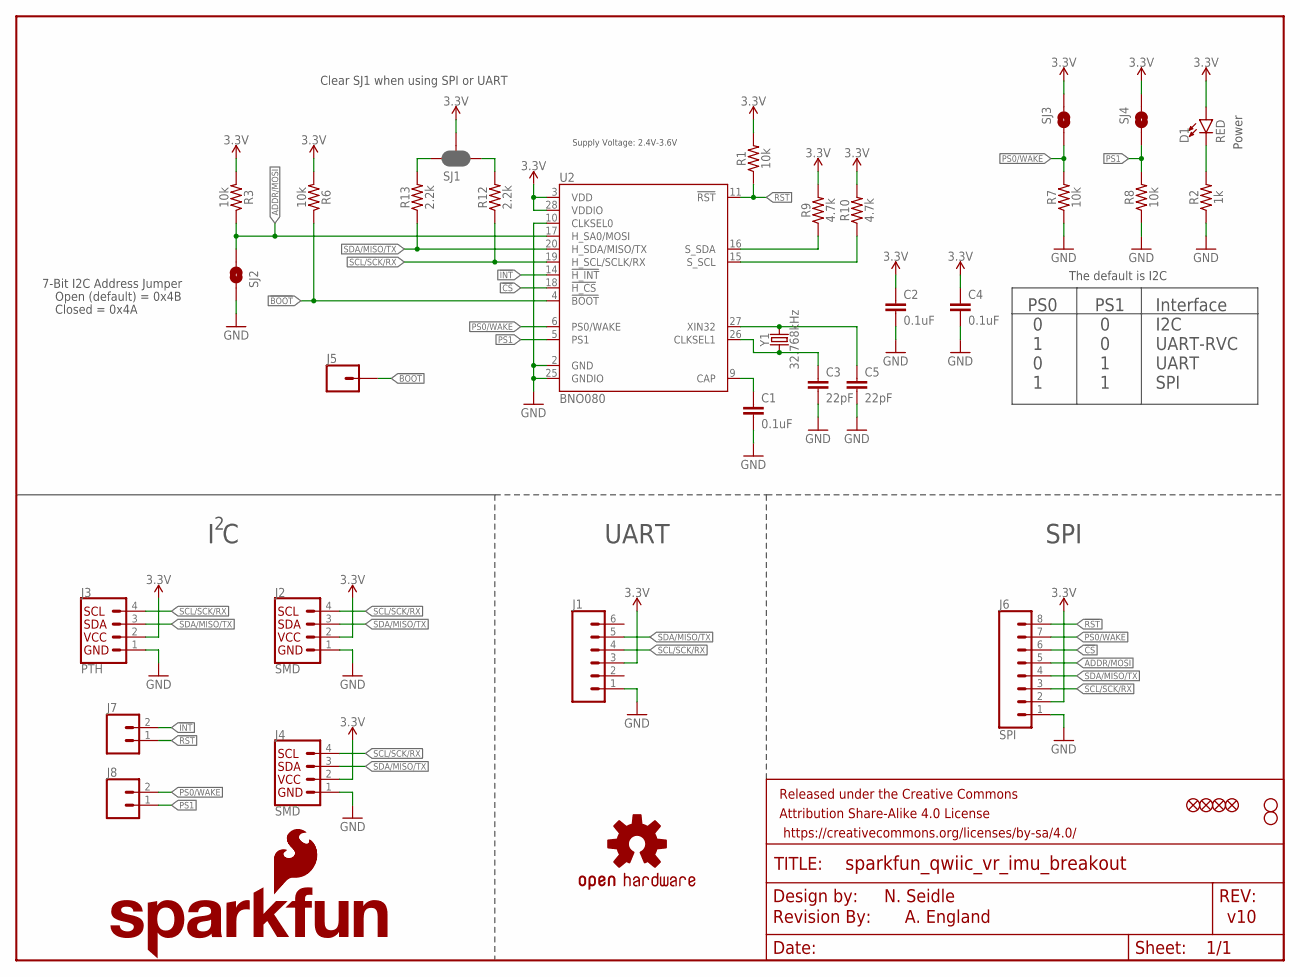
[picture p144: schematic SparkFun_Qwiic_VR_IMU_Breakout.sch]

Parts:
C1, C2, C4: 0.1uF; 0603
C3, C5: 22pF; 0603
D1: RED; LED-0603
FRAME1: FRAME-LETTER; CREATIVE_COMMONS
J1: CONN_06NO_SILK_FEMALE_PTH; 1X06_NO_SILK
J2, J4: SMD; 1X04_1MM_RA
J3: PTH; 1X04_NO_SILK
J5: CONN_01PTH_NO_SILK_YES_STOP; 1X01_NO_SILK
J6: SPI; 1X08_NO_SILK
J7, J8: CONN_021X02_NO_SILK; 1X02_NO_SILK
JP1, JP2, JP5, JP6: FIDUCIALUFIDUCIAL; MICRO-FIDUCIAL
JP3, JP4: STAND-OFF
LOGO1: OSHW-LOGOMINI; OSHW-LOGO-MINI
LOGO2: REVISION
LOGO4: SFE_LOGO_FLAME.1_INCH; SFE_LOGO_FLAME_.1
LOGO5: SFE_LOGO_NAME_FLAME.1_INCH; SFE_LOGO_NAME_FLAME_.1
R1, R3, R6, R7, R8: 10k; 0603
R2: 1k; 0603
R9, R10: 4.7k; 0603
R12, R13: 2.2k; 0603
SJ1: JUMPER-SMT_3_2-NC_PASTE_SILK; SMT-JUMPER_3_2-NC_PASTE_SILK
SJ2, SJ3, SJ4: SOLDERJUMPERNO; SJ_2S-NO
U2: BNO080; LGA-28
Y1: 32.768kHz; CRYSTAL-SMD-3.2X1.5MM

Connections:
3.3V: C2.1, C4.1, D1.A, J1.3, J2.2 (VCC), J3.2 (VCC), J4.2 (VCC), J6.2, R1.2, R3.2, R6.2, R9.2, R10.2, SJ1.2, SJ3.1, SJ4.1, U2.3 (VDD), U2.28 (VDDIO)
!BOOT: J5.1, R6.1, U2.4 (!BOOT)
!CS: J6.6, U2.18 (!H_CS)
!INT: J7.2, U2.14 (!H_INT)
!RST: J6.8, J7.1, R1.1, U2.11 (!RST)
ADDR/MOSI: J6.5, R3.1, SJ2.2, U2.17 (H_SA0/MOSI)
CAP: C1.1, U2.9 (CAP)
GND: C1.2, C2.2, C3.2, C4.2, C5.2, J1.1, J2.1 (GND), J3.1 (GND), J4.1 (GND), J6.1, R2.1, R7.1, R8.1, SJ2.1, U2.2 (GND), U2.10 (CLKSEL0), U2.25 (GNDIO)
unnamed: C5.1, U2.27 (XIN32), Y1.P$2 (2)
unnamed: C3.1, U2.26 (CLKSEL1), Y1.P$1 (1)
unnamed: D1.C, R2.2
PS0/WAKE: J6.7, J8.2, R7.2, SJ3.2, U2.6 (PS0/WAKE)
PS1: J8.1, R8.2, SJ4.2, U2.5 (PS1)
SCL/SCK/RX: J1.4, J2.4 (SCL), J3.4 (SCL), J4.4 (SCL), J6.3, R12.1, U2.19 (H_SCL/SCLK/RX)
SCL_PU: R12.2, SJ1.1
SDA/MISO/TX: J1.5, J2.3 (SDA), J3.3 (SDA), J4.3 (SDA), J6.4, R13.1, U2.20 (H_SDA/MISO/TX)
SDA_PU: R13.2, SJ1.3
S_SCL: R10.1, U2.15 (S_SCL)
S_SDA: R9.1, U2.16 (S_SDA)

Notes on the sheet:
N. Seidle
v10
7-Bit I2C Address Jumper
Closed = 0x4A
Open (default) = 0x4B
PS0 0 1 0 1
PS1 0 0 1 1
Interface I2C UART-RVC UART SPI
The default is I2C
Clear SJ1 when using SPI or UART
I C
UART
SPI
Power
A. England
Supply Voltage: 2.4V-3.6V

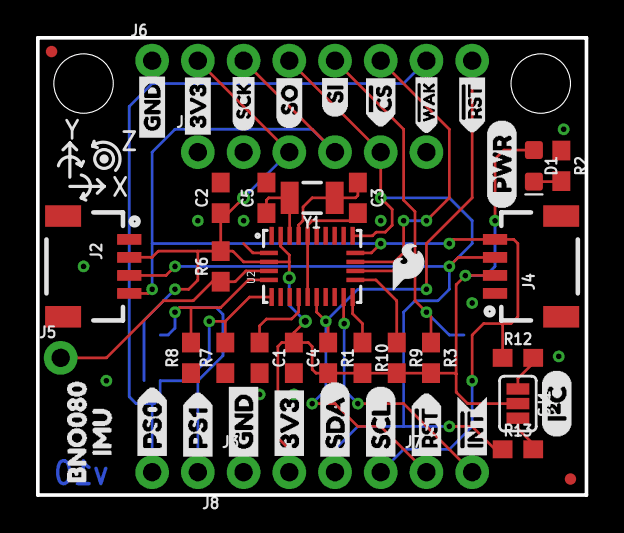
[picture p145: board SparkFun_Qwiic_VR_IMU_Breakout.brd from above]

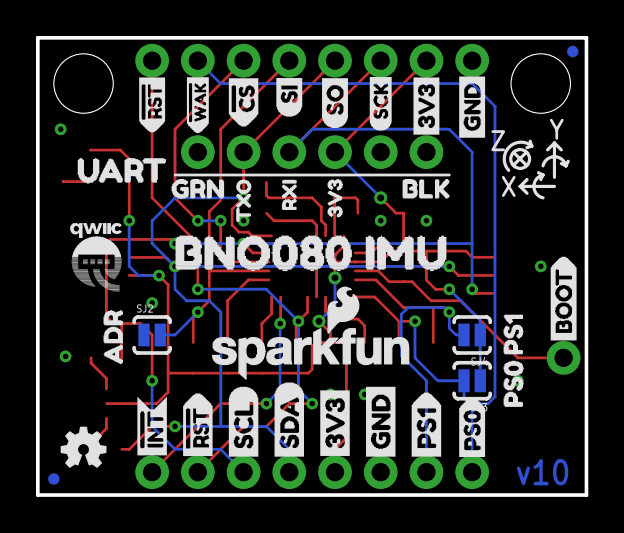
[picture p146: board SparkFun_Qwiic_VR_IMU_Breakout.brd from below]

Board: 2 copper layers, 30.5 x 25.4 mm, 89 parts (35 on the bottom side), 19 nets.

Other parts of the board:
U$1: (PWR)
U$2: BOOT2
U$3, U$4: #RST>
U$5, U$6: SCL
U$7, U$8: SDA
U$9, U$10: 3V3
U$11, U$50: 3V30
U$12, U$13: SCK0
U$14: PS03
U$15, U$16: GND
U$17, U$18: SI1
U$19, U$20: #WAK6
U$21: 3V32
U$22: RXI1
U$23: (I_SUPER2_C)
U$25, U$26: #INT0
U$27, U$28: PS14
U$29: PS05
U$30: ADR0
U$33: PS114
U$34: PS015
U$35: TXO0
U$39: UART8
U$40: GRN10
U$41: BLK9
U$42, U$43: GND1
U$44: BNO080_IMU11
U$46: BNO08012
U$47: IMU13
U$49, U$51: #RST7
U$52, U$53: #CS3
U$54, U$55: SO0
U$59: QWIIC#LABEL#FULL#M#PNG
