TALs-Education/ZumoPi/ZumoPi_V02/old_Designs/PCB/ref_design/MicroMod-RP2040-ProcessorBoard/MicroMod-RP2040-ProcessorBoard.brd

## EAGLE design ZumoPi_V02/old_Designs/PCB/ref_design/MicroMod-RP2040-ProcessorBoard/MicroMod-RP2040-ProcessorBoard.brd (2024-11-26, an earlier design)

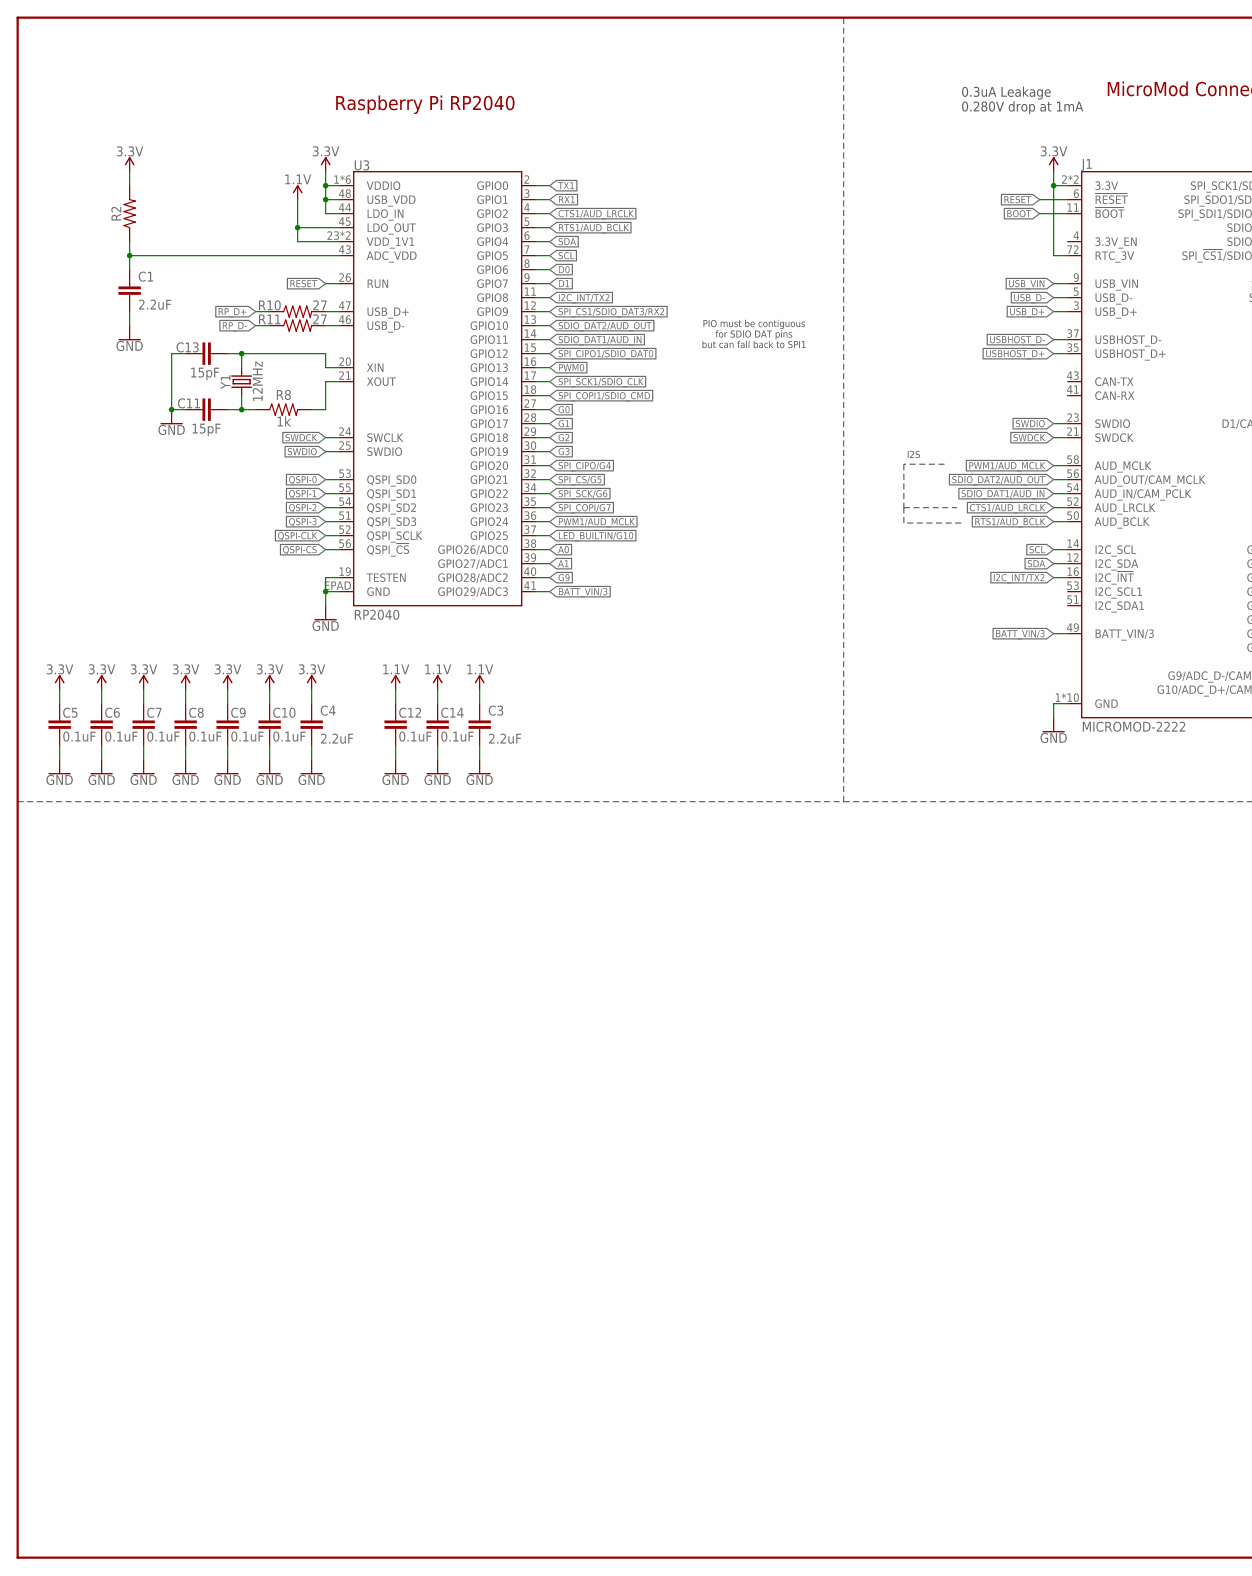
[picture p147: schematic MicroMod-RP2040-ProcessorBoard.sch, part in row 1, column 1]

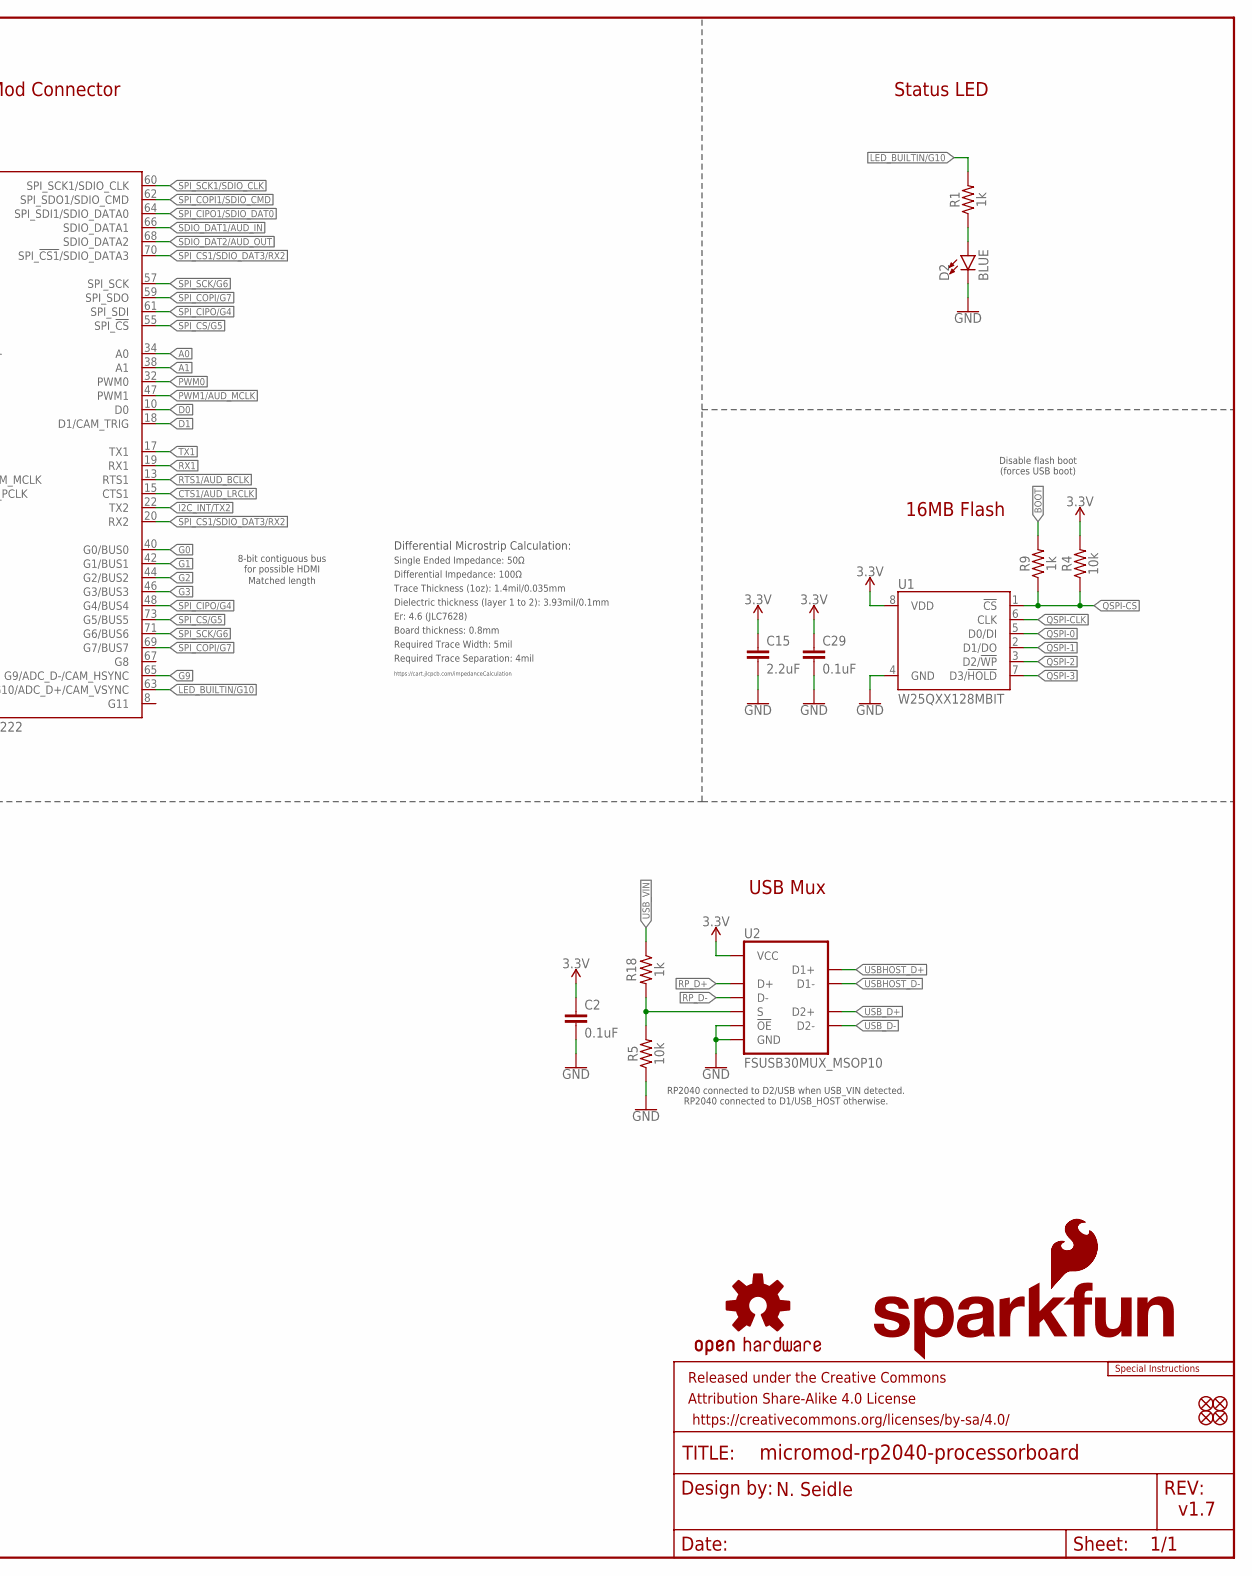
[picture p148: schematic MicroMod-RP2040-ProcessorBoard.sch, part in row 1, column 2]

Parts:
C1, C3, C4, C15: 2.2uF; 0402-TIGHT
C2, C5, C6, C7, C8, C9, C10, C12, C14, C29: 0.1uF; 0402-TIGHT
C11, C13: 15pF; 0402-TIGHT
D2: BLUE; LED-0603
FD1, FD2, FD3, FD4: FIDUCIALUFIDUCIAL; FIDUCIAL-MICRO
FRAME1: FRAME-LEDGER; CREATIVE_COMMONS
J1: MICROMOD-2222; M.2-CARD-E-22
LOGO1: SFE_LOGO_NAME_FLAME.1_INCH; SFE_LOGO_NAME_FLAME_.1
LOGO2: SFE_LOGO_FLAME.1_INCH; SFE_LOGO_FLAME_.1
LOGO3: OSHW-LOGOMINI; OSHW-LOGO-MINI
LOGO4: SPECIAL_INSTRUCTIONS-ORDERING; ORDERING_INSTRUCTIONS
R1, R8, R9, R18: 1k; 0402-TIGHT
R2: 200OHM-0402T-1/16W-1%; 0402-TIGHT
R4, R5: 10k; 0402-TIGHT
R10, R11: 27; 0402-TIGHT
U1: W25QXX128MBIT; WSON-8-6X5-SKINNY_CENTERPAD
U2: FSUSB30MUX_MSOP10; MSOP10
U3: RP2040; QFN-56
Y1: 12MHz; CRYSTAL-SMD-2X2.5MM

Connections:
1.1V: C3.1, C12.1, C14.1, U3.23 (VDD_1V1), U3.45 (LDO_OUT), U3.50 (VDD_1V1)
3.3V: C2.1, C4.1, C5.1, C6.1, C7.1, C8.1, C9.1, C10.1, C15.1, C29.1, J1.2 (3.3V), J1.72 (RTC_3V), J1.74 (3.3V), R2.2, R4.2, U1.8 (VDD), U2.10 (VCC), U3.1 (VDDIO), U3.10 (VDDIO), U3.22 (VDDIO), U3.33 (VDDIO), U3.42 (VDDIO), U3.44 (LDO_IN), U3.48 (USB_VDD), U3.49 (VDDIO)
!RESET!: J1.6 (!RESET!), U3.26 (RUN)
A0: J1.34 (A0), U3.38 (GPIO26/ADC0)
A1: J1.38 (A1), U3.39 (GPIO27/ADC1)
ADC_VDD: C1.1, R2.1, U3.43 (ADC_VDD)
BATT_VIN/3: J1.49 (BATT_VIN/3), U3.41 (GPIO29/ADC3)
BOOT: J1.11 (!BOOT!), R9.2
CTS1/AUD_LRCLK: J1.15 (CTS1), J1.52 (AUD_LRCLK), U3.4 (GPIO2)
D0: J1.10 (D0), U3.8 (GPIO6)
D1: J1.18 (D1/CAM_TRIG), U3.9 (GPIO7)
G0: J1.40 (G0/BUS0), U3.27 (GPIO16)
G1: J1.42 (G1/BUS1), U3.28 (GPIO17)
G2: J1.44 (G2/BUS2), U3.29 (GPIO18)
G3: J1.46 (G3/BUS3), U3.30 (GPIO19)
G9: J1.65 (G9/ADC_D-/CAM_HSYNC), U3.40 (GPIO28/ADC2)
GND: C1.2, C2.2, C3.2, C4.2, C5.2, C6.2, C7.2, C8.2, C9.2, C10.2, C11.1, C12.2, C13.1, C14.2, C15.2, C29.2, D2.C, J1.1 (GND), J1.7 (GND), J1.33 (GND), J1.36 (GND), J1.39 (GND), J1.45 (GND), J1.75 (GND), J1.GND1 (GND), J1.GND2 (GND), J1.GND3 (GND), R5.1, U1.4 (GND), U2.5 (GND), U2.9 (!OE!), U3.19 (TESTEN), U3.EPAD (GND)
I2C_!INT!/TX2: J1.16 (I2C_!INT!), J1.22 (TX2), U3.11 (GPIO8)
LED_BUILTIN/G10: J1.63 (G10/ADC_D+/CAM_VSYNC), R1.2, U3.37 (GPIO25)
unnamed: D2.A, R1.1
unnamed: R8.2, U3.21 (XOUT)
unnamed: C13.2, U3.20 (XIN), Y1.P3 (2)
unnamed: C11.2, R8.1, Y1.P1 (1)
PWM0: J1.32 (PWM0), U3.16 (GPIO13)
PWM1/AUD_MCLK: J1.47 (PWM1), J1.58 (AUD_MCLK), U3.36 (GPIO24)
QSPI-0: U1.5 (D0/DI), U3.53 (QSPI_SD0)
QSPI-1: U1.2 (D1/DO), U3.55 (QSPI_SD1)
QSPI-2: U1.3 (D2/!WP!), U3.54 (QSPI_SD2)
QSPI-3: U1.7 (D3/!HOLD!), U3.51 (QSPI_SD3)
QSPI-CLK: U1.6 (CLK), U3.52 (QSPI_SCLK)
QSPI-CS: R4.1, R9.1, U1.1 (!CS!), U3.56 (QSPI_!CS!)
RP_D1+: R10.2, U3.47 (USB_D+)
RP_D1-: R11.2, U3.46 (USB_D-)
RP_D+: R10.1, U2.4 (D+)
RP_D-: R11.1, U2.6 (D-)
RTS1/AUD_BCLK: J1.13 (RTS1), J1.50 (AUD_BCLK), U3.5 (GPIO3)
RX1: J1.19 (RX1), U3.3 (GPIO1)
SCL: J1.14 (I2C_SCL), U3.7 (GPIO5)
SDA: J1.12 (I2C_SDA), U3.6 (GPIO4)
SDIO_DAT1/AUD_IN: J1.54 (AUD_IN/CAM_PCLK), J1.66 (SDIO_DATA1), U3.14 (GPIO11)
SDIO_DAT2/AUD_OUT: J1.56 (AUD_OUT/CAM_MCLK), J1.68 (SDIO_DATA2), U3.13 (GPIO10)
SPI_!CS1!/SDIO_DAT3/RX2: J1.20 (RX2), J1.70 (SPI_!CS1!/SDIO_DATA3), U3.12 (GPIO9)
SPI_!CS!/G5: J1.55 (SPI_!CS!), J1.73 (G5/BUS5), U3.32 (GPIO21)
SPI_CIPO1/SDIO_DAT0: J1.64 (SPI_SDI1/SDIO_DATA0), U3.15 (GPIO12)
SPI_CIPO/G4: J1.48 (G4/BUS4), J1.61 (SPI_SDI), U3.31 (GPIO20)
SPI_COPI1/SDIO_CMD: J1.62 (SPI_SDO1/SDIO_CMD), U3.18 (GPIO15)
SPI_COPI/G7: J1.59 (SPI_SDO), J1.69 (G7/BUS7), U3.35 (GPIO23)
SPI_SCK1/SDIO_CLK: J1.60 (SPI_SCK1/SDIO_CLK), U3.17 (GPIO14)
SPI_SCK/G6: J1.57 (SPI_SCK), J1.71 (G6/BUS6), U3.34 (GPIO22)
SWDCK: J1.21 (SWDCK), U3.24 (SWCLK)
SWDIO: J1.23 (SWDIO), U3.25 (SWDIO)
TX1: J1.17 (TX1), U3.2 (GPIO0)
USBHOST_D+: J1.35 (USBHOST_D+), U2.2 (D1+)
USBHOST_D-: J1.37 (USBHOST_D-), U2.8 (D1-)
USB_D+: J1.3 (USB_D+), U2.3 (D2+)
USB_D-: J1.5 (USB_D-), U2.7 (D2-)
USB_MUX_SIG: R5.2, R18.2, U2.1 (S)
USB_VIN: J1.9 (USB_VIN), R18.1

Notes on the sheet:
MicroMod Connector
v1.7
N. Seidle
Raspberry Pi RP2040
Status LED
16MB Flash
Disable flash boot (forces USB boot)
PIO must be contiguous for SDIO DAT pins but can fall back to SPI1
8-bit contiguous bus for possible HDMI
0.3uA Leakage 0.280V drop at 1mA
I2S
USB Mux
RP2040 connected to D2/USB when USB_VIN detected. RP2040 connected to D1/USB_HOST otherwise.
Board thickness: 0.8mm
Er: 4.6 (JLC7628)
Trace Thickness (1oz): 1.4mil/0.035mm
Single Ended Impedance: 50Ω
Dielectric thickness (layer 1 to 2): 3.93mil/0.1mm
https://cart.jlcpcb.com/impedanceCalculation
Differential Microstrip Calculation:
Required Trace Separation: 4mil
Required Trace Width: 5mil
Differential Impedance: 100Ω
Matched length

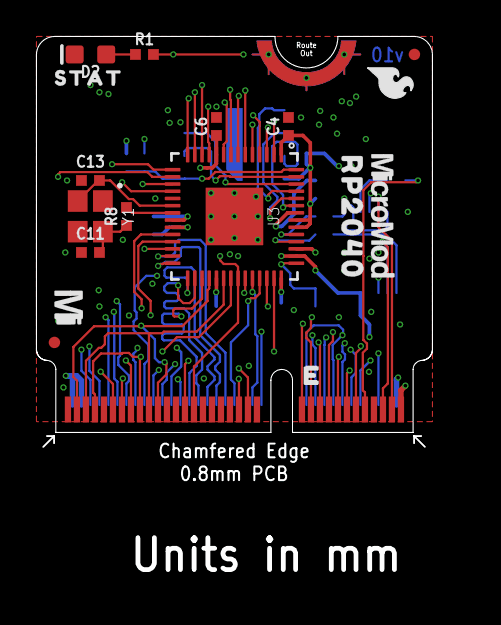
[picture p149: board MicroMod-RP2040-ProcessorBoard.brd from above]

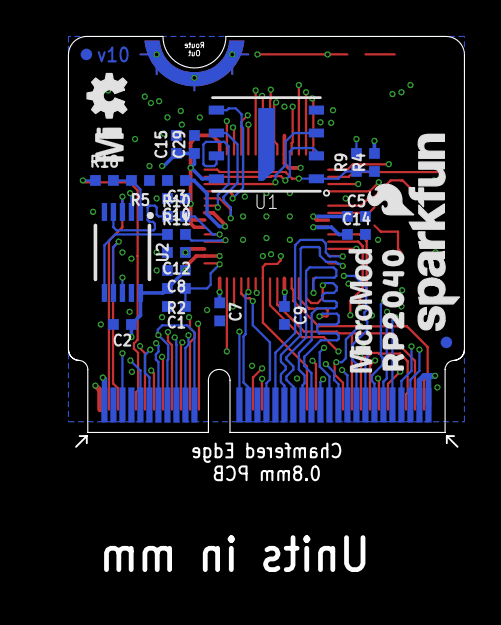
[picture p150: board MicroMod-RP2040-ProcessorBoard.brd from below]

Board: 4 copper layers, 22.0 x 22.8 mm, 47 parts (28 on the bottom side), 58 nets.

Other parts of the board:
U$1, U$7: MICROMOD_MI_LOGO_.35
U$3, U$12: MICROMOD_LOGO_.3
U$4, U$9: RP20400
U$11: STAT0
