TALs-Education/ZumoPi/ZumoPi_V02/WS_Zumo/Python/Demonstarations/JoystickCameraBall/JoystickBallHTML.py

#!/usr/bin/python3
import threading
import serial
import time
import math
import json
import numpy as np
from collections import deque
import logging

# Suppress Flask/werkzeug HTTP request logging
logging.getLogger('werkzeug').setLevel(logging.ERROR)

# Dash imports
import dash
import dash_daq as daq
from dash import html, dcc
import plotly.graph_objs as go
from flask import request

# Picamera2 and OpenCV imports
from picamera2 import Picamera2

# Import the ball detection library.
from ball_detect import BallDetect

class ZumoApp:
    def __init__(self, serial_port, external_stylesheets):
        # Open the serial port
        self.ser = serial.Serial(serial_port, 115200)
        self.zumo_angle = 0
        self.zumo_speed = 0
        self.closing_event = threading.Event()
        self.transmit_thread = threading.Thread(target=self.transmit_data)
        self.receive_thread = threading.Thread(target=self.receive_data)
        self.lock = threading.Lock()
        self.last_messages = []
        self.received_values = deque(maxlen=100)
        self.prev_frame_time = time.time()

        # Initialize the camera with 640x480 resolution for processing.
        self.picam2 = Picamera2()
        preview_config = self.picam2.create_preview_configuration({
            "format": "RGB888", "size": (640, 480)
        })
        self.picam2.configure(preview_config)
        self.picam2.start()

        # Instantiate BallDetect with the camera.
        self.ball_detector = BallDetect(self.picam2)

        self.app = dash.Dash(__name__, external_stylesheets=external_stylesheets)
        self.create_layout()

        self.file = open('recorded_messages.txt', 'a')

    def start(self):
        self.transmit_thread.start()
        self.receive_thread.start()
        self.app.run_server(port=8500, host='0.0.0.0', debug=False, use_reloader=False)

    def transmit_data(self):
        while not self.closing_event.is_set() and self.ser.isOpen:
            with self.lock:
                joy_y = math.sin(math.radians(self.zumo_angle)) * self.zumo_speed * 200
                joy_x = math.cos(math.radians(self.zumo_angle)) * self.zumo_speed * 200
            left_velocity = joy_y + joy_x
            right_velocity = joy_y - joy_x
            command = {"vl": left_velocity, "vr": right_velocity}
            msg = json.dumps(command) + "\n"
            self.ser.write(msg.encode('ascii'))
            time.sleep(0.1)

    def receive_data(self):
        while not self.closing_event.is_set() and self.ser.isOpen:
            if self.ser.in_waiting > 0:
                c = self.ser.readline().decode("ascii").strip()
                with self.lock:
                    self.last_messages.append(c)
                    if len(self.last_messages) > 3:
                        self.last_messages.pop(0)
                self.file.write(c + "\n")
            else:
                time.sleep(0.05)

    def create_layout(self):
        # Layout: live camera stream, joystick control, and live plot.
        self.app.layout = html.Div([
            html.Button("Close", id="close-button", style={'width': '100%'}),
            html.Div([
                html.Div([
                    html.Img(id="live-image", style={'width': '480px', 'height': '360px'})
                ], style={'flex': '1', 'padding': '10px'}),
                html.Div([
                    daq.Joystick(id='my-joystick', label="Zumo Joystick", angle=0, size=300),
                    html.Div(id='joystick-output', style={'marginTop': '10px'})
                ], style={'flex': '1', 'padding': '10px'}),
            ], style={'display': 'flex', 'justify-content': 'center', 'align-items': 'center'}),
            html.Div([
                dcc.Graph(id='live-plot', style={'height': '300px'})
            ]),
            dcc.Interval(id='interval-component', interval=100, n_intervals=0),
            html.Div(id='hidden-div', style={'display': 'none'})
        ])

        self.app.callback(
            dash.dependencies.Output('joystick-output', 'children'),
            [dash.dependencies.Input('my-joystick', 'angle'),
             dash.dependencies.Input('my-joystick', 'force')]
        )(self.update_joystick)

        self.app.callback(
            dash.dependencies.Output('live-image', 'src'),
            [dash.dependencies.Input('interval-component', 'n_intervals')]
        )(self.update_image)

        self.app.callback(
            dash.dependencies.Output('live-plot', 'figure'),
            [dash.dependencies.Input('interval-component', 'n_intervals')]
        )(self.update_plot)

        self.app.callback(
            dash.dependencies.Output('hidden-div', 'children'),
            [dash.dependencies.Input('close-button', 'n_clicks')]
        )(self.close_button_clicked)

    def update_joystick(self, angle, force):
        with self.lock:
            self.zumo_angle = angle if isinstance(angle, (int, float)) else 0
            self.zumo_speed = force if isinstance(force, (int, float)) else 0
        return [f'Angle is {angle}', html.Br(), f'Force is {force}']

    def update_image(self, n_intervals):
        # Use BallDetect's process_frame method which returns a Base64-encoded JPEG image.
        return self.ball_detector.process_frame()

    def update_plot(self, n_intervals):
        if self.closing_event.is_set():
            raise dash.exceptions.PreventUpdate

        try:
            with self.lock:
                last_messages = self.last_messages.copy()

            if last_messages:
                try:
                    data_msg = json.loads(last_messages[-1])
                    left_velocity = data_msg.get("vL", 0)
                    right_velocity = data_msg.get("vR", 0)
                    values = [left_velocity, right_velocity]
                except Exception:
                    try:
                        values = list(map(float, last_messages[-1].split(',')))
                    except Exception:
                        values = [0, 0]
                self.received_values.append(values)

            if self.received_values:
                data = np.array(self.received_values).T
                variable_names = ["vL", "vR"]
                traces = [
                    go.Scatter(
                        x=list(range(len(data[0]))),
                        y=data[i],
                        mode='lines',
                        name=variable_names[i] if i < len(variable_names) else f'value{i+1}'
                    ) for i in range(len(data))
                ]
                layout = go.Layout(title='Live Plot of Incoming Messages')
            else:
                traces = []
                layout = go.Layout(title='Live Plot of Incoming Messages')

            return {'data': traces, 'layout': layout}
        except Exception as e:
            logging.error("Error in update_plot: %s", e)
            return {'data': [], 'layout': go.Layout(title='Live Plot Error')}

    def close(self):
        self.closing_event.set()
        self.file.close()
        self.picam2.stop()

    def close_button_clicked(self, n_clicks):
        if n_clicks is not None and n_clicks > 0:
            self.close()
            time.sleep(1)
            self.stop()

    def stop(self):
        func = request.environ.get('werkzeug.server.shutdown')
        if func is None:
            raise RuntimeError('Not running with the Werkzeug Server')
        func()

def main():
    external_stylesheets = ['https://codepen.io/chriddyp/pen/bWLwgP.css']
    serial_port = '/dev/ttyAMA10'
    zumo_app = ZumoApp(serial_port, external_stylesheets)
    try:
        zumo_app.start()
    except KeyboardInterrupt:
        zumo_app.close()

if __name__ == "__main__":
    main()
