TALs-Education/ZumoPi/(commit log)

2024-11-26 zumoPi V02
    [MicroMod-RP2040-ProcessorBoard.brd, MicroMod-RP2040-ProcessorBoard.sch, MicroMod_ATP_CarrierBoard.brd, MicroMod_ATP_CarrierBoard.sch, Pinout.xlsx, Qwiic Distance Sensor - VL53L1X.brd, Qwiic Distance Sensor - VL53L1X.sch, Qwiic Fuel Gauge - MAX17048.brd]
2025-02-05 uart examples
2025-02-24 arduino examples update
2025-11-20 Assembly Images
2025-12-15 zumo updates
    [zum02c-drill.dxf]
2026-05-14 traffic cone
    [Mono_Traffic_Cone.3mf]
2026-08-06 3d models updates
    [Ball.3mf, BarcodeCircle.3mf, BarcodePrints.3mf, CameraCover.3mf, CameraProtection.3mf, Cone_MultiColor.3mf, Cylinder_Multicolor.3mf, Cylinder_Small_Multicolor.3mf]
2026-09-06 updated 3d models
    [PiCover_121.3mf, PiCover_122.3mf, PiCover_123.3mf, PiCover_124.3mf, PiCover_125.3mf]
2026-09-09 educational materials
